codreman2-eng/Smart-Mangrove/reports/Estado de waypoints en el M600.md

# El puerto API podría delatar ya la misión

Sí existe una vía que podría funcionar sin romper la regla de solo recepción, pero nadie la ha demostrado todavía en un M600. El Open Protocol de DJI define en el mismo UART API que el ESP32 ya escucha dos mensajes no solicitados, además del broadcast 0x02/0x00. El primero es **0x02/0x03, el estado de la misión** (tipo de misión, waypoint objetivo, estado actual y error). El segundo es **0x02/0x04, los eventos de la misión** (subida terminada, misión terminada y waypoint alcanzado con su índice). DJI los describe como "broadcast data protocol" y no como llamadas de API. El único requisito documentado es marcar la casilla "Ground Station Status" en DJI Assistant ([Ground Station Protocol](https://developer.dji.com/onboard-sdk/documentation/protocol-doc/ground-station-protocol.html)). Quedan dos incógnitas sin respuesta pública. La primera es si el A3 emite esos mensajes cuando la misión la sube GS Pro y no el OSDK; DJI no lo ha probado y dijo oficialmente que OSDK-ROS no lo soporta. La segunda es si los emite hacia un dispositivo nunca activado. Ambas se resuelven con una sola sesión del simulador de DJI Assistant 2, usando el sniffer `tools/osdk_sniff.py` que el proyecto ya tiene. Si la prueba falla, la única señal explícita que queda es la acción de waypoint "PWM signal output to F-channel" del firmware A3 1.7.6.0, leída por GPIO 35. Esa opción tiene un coste: vuelve a meter en las guías el cableado del canal F que se acaba de quitar. Las demás vías tienen un veredicto firme. El sniffing de DUML o del CAN del A3 se descarta. La app MSDK solo sirve si sustituye a GS Pro como app de misión. Las posiciones de los waypoints no viajan por ningún canal pasivo, así que el ESP32 debe seguir cargándolas desde su propio `mission.json`.

## Dos mensajes de misión ya pasan por el cable que el ESP32 escucha

Esta es la vía con mejor relación entre coste y beneficio, porque no requiere hardware nuevo. El código fuente del OSDK 3.9 define `mission = {0x02, 0x03}` y `waypoint = {0x02, 0x04}` junto al broadcast `{0x02, 0x00}` ([dji_command.cpp](https://github.com/dji-sdk/Onboard-SDK/blob/3.9/osdk-core/api/src/dji_command.cpp)). Los structs están en `dji_ack.hpp`. `WayPointStatusPushData` lleva `mission_type`, `waypoint_index` y `current_status` (0 premisión, 1 en acción, 5 primer waypoint, 6 alcanzado). `WayPointReachedData` lleva `incident_type`, `waypoint_index` y `current_status` (4 pre-acción, 6 post-acción). El comentario del propio código dice que esos datos llegan "while ground-station is enabled on Assistant's SDK Page" ([dji_ack.hpp](https://github.com/dji-sdk/Onboard-SDK/blob/3.9/osdk-core/api/inc/dji_ack.hpp)). Con eso el ESP32 tendría justo lo que pide la pregunta: **el índice del waypoint objetivo, el evento de waypoint alcanzado (incluso separado en antes y después de las acciones) y el fin de misión**.

Hay un dato importante: **la librería anfitriona no exige activación ni autoridad de control para entregar esos mensajes**. En `dji_vehicle.cpp`, `PushDataHandler` despacha 0x02/0x03 y 0x02/0x04 a sus callbacks sin consultar `getActivationStatus()`. La autoridad solo hace falta para subir o arrancar una misión, no para recibirla ([dji_vehicle.cpp @3.9](https://raw.githubusercontent.com/dji-sdk/Onboard-SDK/3.9/osdk-core/api/src/dji_vehicle.cpp)). Por tanto, el único que puede bloquear al ESP32 es el propio firmware del A3. Esa es una prueba empírica, no una barrera de diseño. El broadcast ya demostró algo parecido: según `OsdkPositionSource.h`, el A3 lo emite sin que nadie lo pida, verificado en hardware real con el TX del adaptador desconectado.

Hay tres matices que impiden dar la vía por buena. **Primero, DJI respondió de forma negativa al caso M600 Pro.** En el issue #303 (M600 Pro, FW 1.0.1.67, OSDK 3.8.1), soporte de DJI dijo primero que "we have not tested" suscribirse a la información de una misión creada por una app de terceros. Después lo cerró con "OSDK-ROS does not support obtaining waypoint task information set by DJI APP/ third-party APP" ([Onboard-SDK-ROS #303](https://github.com/dji-sdk/Onboard-SDK-ROS/issues/303)). Esa respuesta habla de lo que la librería soporta, no de lo que el autopiloto emite. Aun así, es la única declaración oficial y no es favorable. A favor queda un argumento estructural: un colaborador recordó que "mission tasks are not exclusive to the Onboard SDK", porque el motor de misiones de la controladora es compartido ([Issue #416](https://github.com/dji-sdk/Onboard-SDK/issues/416)). **Segundo, la fiabilidad de los mensajes es imperfecta incluso con misiones del OSDK.** En modo `TRACE_COORDINATED` solo llegaban los eventos del primer y del último waypoint ([Issue #219](https://github.com/dji-sdk/Onboard-SDK/issues/219)). En un M210 el callback de eventos "is never called" ni en simulador ni en vuelo ([Onboard-SDK-ROS #244](https://github.com/dji-sdk/Onboard-SDK-ROS/issues/244)). **Tercero, la casilla "Ground Station Status" aparece en documentación de la era M100.** No se confirmó que exista en DJI Assistant 2 para A3/M600. Marcarla sería un cambio de configuración en tierra, no una transmisión del payload, así que no rompe la regla del proyecto.

El firmware actual descarta hoy esos mensajes. `OsdkPositionSource::_decode` sale con `if (p[0] != 0x02 || p[1] != 0x00) return false;`, de modo que cualquier 0x02/0x03 o 0x02/0x04 que ya llegue se tira sin registrar. En cambio, el sniffer de PC `tools/osdk_sniff.py` ya cuenta los pares cmd set/id (`self.cmds`, un `Counter`) y decodifica el campo `enc` de la cabecera. Es la herramienta exacta para la prueba.

Hay dos caminos oficiales del OSDK que conviene descartar del todo. **La activación queda descartada.** Es el comando 0x00/0x01: requiere TX, un `app_id` y una clave de desarrollador DJI, y una primera conexión con internet a través de DJI GO o Assistant 2. Además instala una clave de cifrado en el enlace ([OPEN Protocol](https://developer.dji.com/onboard-sdk/documentation/protocol-doc/open-protocol.html); [OSDK FAQ](https://developer.dji.com/onboard-sdk/documentation/appendix/FAQ.html)). Ningún documento dice que la activación desbloquee nada de misiones. **La suscripción (set 0x03) también queda descartada.** Funciona por petición y respuesta, así que necesita TX. Su lista de topics no incluye ninguno de misión ni de waypoint, y el ejemplo de la 3.9 la salta en el "legacy M600" ([dji_telemetry.hpp](https://raw.githubusercontent.com/dji-sdk/Onboard-SDK/3.9/osdk-core/api/inc/dji_telemetry.hpp); [mission_sample.cpp](https://raw.githubusercontent.com/dji-sdk/Onboard-SDK/3.9/sample/platform/linux/missions/mission_sample.cpp)). El techo de versiones también está claro: **OSDK 3.9, de septiembre de 2019, es la última que lista M600 (FW 1.0.1.67) y A3/A3 Pro (FW 1.7.7.0)**. La 4.x solo cubre M300 y M210 V2, y Waypoint V2 no existe para el M600 ([README @3.9](https://raw.githubusercontent.com/dji-sdk/Onboard-SDK/3.9/README.md); [README @master](https://raw.githubusercontent.com/dji-sdk/Onboard-SDK/master/README.md)).

Hay un premio menor dentro del broadcast. El enum `DisplayMode` nombra HOTPOINT (9) y NAVI_SDK_CTRL (17), pero no tiene valor de waypoint. Los valores 13-14, 16 y 18-32 están marcados como "reserved" ([dji_status.hpp](https://raw.githubusercontent.com/dji-sdk/Onboard-SDK/3.9/osdk-core/api/inc/dji_status.hpp)). El MSDK, por su parte, sí reporta `GPS_WAYPOINT` ("WP/F-WP") durante una misión ([FlightControllerState](https://developer.dji.com/api-reference/android-api/Components/FlightController/DJIFlightController_DJIFlightControllerCurrentState.html)). Por eso es plausible, aunque no está verificado, que el A3 ponga un valor reservado en el broadcast mientras GS Pro vuela. Ese valor daría un indicador barato de que hay una misión en ejecución, pero no el índice del waypoint. El campo STATUS (bit 11) todavía no se decodifica: según el propio código, primero hay que dimensionar GPS, RTK, MAG, RC y GIMBAL.

## Un pulso PWM en el canal F es la única señal deliberada

Si los mensajes de misión no aparecen, la única señal que GS Pro puede emitir a propósito en un waypoint concreto es eléctrica. Las notas de versión del A3 son explícitas. La **FW 1.7.6.0 (2018-08-02)**, con Assistant 2 for Autopilot v2.0.0, dice "Added a PWM signal output to F-channel in Waypoint Actions" y también corrige "the aircraft will sometimes not fly to the next waypoint". La **FW 1.7.7.0 (2019-01-09)** corrige que el canal F emitía un valor mínimo antes del preajustado tras reiniciar la controladora ([A3 Release Notes](https://dl.djicdn.com/downloads/a3/20190109/A3+release+notes+20190109.pdf)). El manual del A3 describe F1-F4 como salidas PWM multifunción y F5-F8 como E/S PWM ([A3 User Manual](https://dl.djicdn.com/downloads/a3/en/A3_and_A3_Pro_User_Manual_en_160520.pdf)). El ESP32 lee la señal sin transmitir nada, igual que ya lee el UART. La captura de RC-PWM en GPIO 35 ya está escrita (`RcPwmInput`, `RC_Input_Calibration_Tool.ino`).

**Veredicto: funciona con salvedades, y se presenta como opción, no como decisión.** El coste es concreto: reintroduce en las guías el cable del canal F que el proyecto acaba de retirar, con su pull-down externo de 10 k. Además, GPIO 35 no tolera 5 V y nadie ha medido el nivel lógico de los puertos F. Si resulta ser 5 V, hace falta el mismo divisor o la resistencia en serie que ya usa `RC_Pulse_Generator_Mega2560.ino`. Hay tres incógnitas más que ninguna fuente resuelve. La primera es en qué app y versión aparece la acción y con qué nombre; lo más probable es GS Pro, pero no se encontró manual ni changelog que lo confirme. La segunda es si el A3 integrado del M600 expone la acción igual que un A3 suelto. El M600 numera su firmware aparte (1.0.1.67), y no se verificó qué versión de controladora incluye. La tercera es si los puertos F son accesibles en el chasis del M600 sin el Channel Expansion Kit. Un usuario del foro de DJI afirma que los puertos F no dan V+, lo cual cuadra con un cable de señal y masa, pero esto no está verificado ([DJI forum 95197](https://forum.dji.com/thread-95197-1-1.html)). A cambio, esta vía da lo que ninguna otra pasiva ofrece: una marca que el planificador pone en el waypoint de lanzamiento, por ejemplo 1900 µs tras un hover y de vuelta a 1100 µs después. Con la puerta de posición ya existente, el lanzamiento queda atado a la intención de la misión y no solo a la geometría.

Las demás acciones de GS Pro, cada una con su veredicto, sirven como confirmación pero no como fuente de verdad. GS Pro admite **hasta 99 waypoints con hasta 15 acciones cada uno**: rotación de la aeronave, pitch de gimbal, inicio y parada de grabación, foto y hover ([Heliguy](https://www.heliguy.com/blogs/posts/heliguys-guide-to-the-dji-gs-pro-app)). Cada hover dura como máximo 32 767 ms ([MSDK DJIWaypointActionType](https://developer.dji.com/iframe/mobile-sdk-doc/ios/Enums/DJIWaypointActionType.html)). **El hover con la puerta de posición y velocidad funciona** y no exige cambios. Conviene endurecer la puerta a ≤0,5-1,0 m/s sostenidos durante ≥2 s, en lugar de ≤2,0 m/s instantáneos. Aun así, sigue detectando "parado cerca de la coordenada", no "la misión llegó". **La rotación a un rumbo firma funciona con salvedades** como segundo factor, porque el ESP32 ya recibe el cuaternión. Por ejemplo: hover, girar a un rumbo alejado al menos 30-45° de los tramos de vuelo, mantener ±5-10° y lanzar. **La foto mapeada a un puerto F configurado como "Shutter" es dudosa.** El firmware 1.6.0.10 añadió el mapeo del obturador, pero UgCS informa de que no puede disparar cámaras propias en F1-F8 ([A3 Release Notes](https://dl.djicdn.com/downloads/a3/20190109/A3+release+notes+20190109.pdf); [DIYDrones](https://diydrones.com/group/ugcs/forum/dji-n3-remote-shutter-ugcs)). **El pitch de gimbal no funciona** sin un gimbal DJI reconocido. El M600 con A3 solo controla en ángulo Ronin-MX, X5, X3 y XT ([OSDK Gimbal](https://developer.dji.com/onboard-api-reference/classDJI_1_1OSDK_1_1Gimbal.html)), y añadir uno solo para transportar una señal pesa y cuesta más que un cable.

## DUML y CAN tienen nombres de comandos pero ningún bus accesible

Los comandos de misión existen en el protocolo interno, pero nada de lo publicado permite leerlos en un M600. El disector `dji-dumlv1-flyc.lua` de o-gs nombra un bloque completo de misión en el set 0x03. Dos de esos comandos son mensajes no solicitados: **0x88 "Push Navigation Status Info"** (Target Way Point, Way Point Running Status) y **0x89 "Push Navigation Event Info"** (Reach Incident Way Point Index). Su estructura coincide casi campo por campo con 0x02/0x03 y 0x02/0x04, lo que sugiere un mismo registro interno exportado por dos caminos. Pero la sección de waypoint lleva el comentario `-- Way Point mission (unverified)`. Las subidas 0x82/0x84, que llevarían las posiciones, tienen nombre y ningún layout ([dji-dumlv1-flyc.lua](https://github.com/o-gs/dji-firmware-tools/blob/master/comm_dissector/wireshark/dji-dumlv1-flyc.lua)). Todas las capturas proceden de drones de consumo (Phantom, Mavic, Spark) por UART, USB o Wi-Fi. El repositorio no tiene herramienta de captura CAN ni ninguna captura de A3, M600 o LB2 ([README del disector](https://github.com/o-gs/dji-firmware-tools/blob/master/comm_dissector/README.md)).

La topología física termina de cerrar esta vía. Según el manual, el Lightbridge 2 se conecta al A3 por el **"RF Port" con un "DBUS Cable II"**, no por CAN1. CAN1 queda reservado a GPS-Compass Pro, RTK y gimbal, y CAN2 y el puerto API a dispositivos SDK ([A3 User Manual](https://dl.djicdn.com/downloads/a3/en/A3_and_A3_Pro_User_Manual_en_160520.pdf)). La misión que sube GS Pro probablemente viaja por un enlace propietario sin documentar, el mismo cable que lleva el mando de RC a la controladora, y no conviene intervenir en él. El único precedente público de decodificación CAN de DJI es el Naza-M V2. Allí el oyente tenía que **transmitir un heartbeat (0x108-1007) a 1 Hz** para que la controladora emitiera los datos OSD ([STorM32 wiki](https://www.olliw.eu/storm32bgc-v2-wiki/CAN_Bus_Communication)), algo que el proyecto prohíbe. La tasa de bits del A3, los IDs, el conector y el pinout no son públicos. Además, la EULA de DJI prohíbe la ingeniería inversa sin consentimiento escrito ([DJI Developer EULA](https://developer.dji.com/policies/eula)). **Veredicto: no funciona y se descarta.** Un nodo TWAI en modo listen-only sería eléctricamente seguro, pero no tendría nada que decodificar.

## La app MSDK solo ve la misión si sustituye a GS Pro

El MSDK 4.x expone exactamente los campos que se buscan, pero hay un problema de arquitectura. `WaypointExecutionProgress` da `targetWaypointIndex`, `isWaypointReached` y `executeState` ([DJIWaypointExecutionProgress](https://developer.dji.com/api-reference/android-api/Components/Missions/DJIWaypointMission_DJIWaypointExecutionProgress.html)). El M600 y el M600 Pro figuran con misiones Waypoint en el MSDK 4, y no aparecen en el v5 ([MSDK Product Introduction](https://developer.dji.com/mobile-sdk/documentation/introduction/product_introduction.html)). El problema es que **solo una app habla con la aeronave a la vez**. DJI lo declara para las plataformas actuales ("only one app can access the drone data"), y en el M600 el móvil va por USB al mando ([DJI SDK forum](https://sdk-forum.dji.net/hc/en-us/articles/6029213604249-Can-you-run-official-app-and-MSDK-app-simultaneously-on-RC-Pro-or-RC-Plus)). Para una misión ajena, la única ruta documentada es la de reconexión. Si al conectar el SDK ya hay una misión en ejecución, el operador descarga un resumen "but information for each waypoint is absent", y `downloadMission` puede pedir los waypoints mientras dure el estado EXECUTING ([WaypointMissionOperator](https://developer.dji.com/api-reference/android-api/Components/Missions/DJIWaypointMissionOperator.html)). Para usar esa ruta, GS Pro tendría que soltar el enlace en pleno vuelo, y nadie lo ha probado en un M600.

El relé hasta el ESP32 añade dos problemas más. Por Wi-Fi, el móvil se uniría al AP "SmartLauncher", pero el alcance desde el suelo es de cientos de metros como mucho, frente a los kilómetros del Lightbridge; esto es una estimación sin fuente. Por `sendDataToOnboardSDKDevice`, el MSDK lo lista para el M600/A3 con un máximo de 100 bytes por llamada ([DJIOnboardSDKDevice](https://developer.dji.com/api-reference/ios-api/Components/OnboardSDKDevice/DJIOnboardSDKDevice.html)), y los datos llegan al puerto API como 0x02/0x02 a unos 1 KB/s ([Data Transparent Transmission](https://developer.dji.com/onboard-sdk/documentation/M100-Docs/application-development-guides/data-transparent-transmission.html)). No se sabe si llegan a un dispositivo no activado, y un hilo del foro de DJI afirma que no está disponible en el M600 ([DJI SDK forum 360038614413](https://sdk-forum.dji.net/hc/en-us/community/posts/360038614413-Open-Protocol-and-Data-Transparant-Transmission-on-M210-and-M600)). **Veredicto: funciona con salvedades fuertes, y se descarta como relé de GS Pro.** Solo vale la pena si el proyecto decide cambiar de herramienta y que una app MSDK propia planifique, suba y vuele la misión. En ese caso los eventos están garantizados. GS Pro, además, está en fase de mantenimiento desde la 2.0.17 y no recibirá más soporte de dispositivos ([App Store](https://apps.apple.com/us/app/dji-gs-pro/id1183717144)).

## Las posiciones de los waypoints no salen por ningún canal pasivo

Para la segunda mitad de la pregunta la respuesta es firme. **Ningún mensaje pasivo documentado contiene las coordenadas de los waypoints.** 0x02/0x03 y 0x02/0x04 solo llevan índices y estados. Los comandos DUML de subida no tienen layout público. El MSDK solo las entrega a la app que tiene el enlace, mediante `downloadMission`. En el OSDK, descargar la misión requiere enviar comandos, y aun así solo funciona si el propio OSDK subió algo antes; el autor del issue #303 lo comprobó en un M600 Pro ([Onboard-SDK-ROS #303](https://github.com/dji-sdk/Onboard-SDK-ROS/issues/303)). Por eso el diseño actual es el correcto: el operador carga las coordenadas de lanzamiento en el `mission.json` del ESP32 (`MissionDefault.h` ya trae `lat_deg`, `lon_deg`, `alt_m` y `radius_m` por punto). Si 0x02/0x04 resulta funcionar, el índice que reporte se cruzaría con esa lista. Hay que tener en cuenta que GS Pro trocea las misiones de más de 99 waypoints ([GS Pro FAQ](https://www.dji.com/ground-station-pro/faq)), así que el índice es relativo a cada tramo subido y no a la misión completa.

| Vía | Veredicto | Qué aporta |
|---|---|---|
| OSDK 0x02/0x03 y 0x02/0x04 en el UART actual | Funciona con salvedades, pendiente de banco | Índice objetivo, waypoint alcanzado, fin de misión |
| DisplayMode reservado en el broadcast | Pendiente de banco | Solo "misión activa" |
| Activación o suscripción del OSDK | No, se descarta (exige TX y app key) | Nada de misión |
| PWM de canal F (FW ≥1.7.6.0) en GPIO 35 | Funciona con salvedades, opción con coste de cableado | Marca deliberada en el waypoint de lanzamiento |
| Hover + puerta de posición y velocidad | Funciona (ya implementado) | "Parado en la coordenada" |
| Rumbo firma (cuaternión) | Funciona con salvedades | Segundo factor |
| Foto / Shutter en puerto F | Dudosa, informes contradictorios | Marca, si dispara sin cámara DJI |
| Pitch de gimbal | No, sin gimbal DJI | — |
| DUML / CAN del A3 | No, se descarta | — |
| App MSDK como relé de GS Pro | No en la práctica; sí si sustituye a GS Pro | Índice y estado completos |
| Posiciones de waypoints por vía pasiva | No | Precargar en `mission.json` |

## Una sesión de simulador resuelve las incógnitas

La prueba se hace en banco, con hélices desmontadas, y el ESP32 sigue sin transmitir nada en todo momento. Pasos:

1. Actualizar y anotar el firmware de la controladora. Hace falta conocer la versión del A3 integrado; el objetivo es 1.7.7.0 o la equivalente del paquete M600.
2. En DJI Assistant 2, en la página SDK, buscar y marcar "Ground Station Status". Si la casilla no existe, anotarlo, porque eso también es un resultado. Asignar además un puerto F a la salida PWM de waypoint.
3. Arrancar el simulador de Assistant 2 y conectar el adaptador USB-TTL de 3,3 V solo al TX del puerto API.
4. En GS Pro, en el iPad, volar una misión de 3 waypoints. En el waypoint 2 programar: Hover 3 s, Rotate a un rumbo firma, la acción PWM del canal F a valor alto (si GS Pro la ofrece), Hover 10 s, PWM de vuelta a valor bajo.
5. Grabar la sesión con `python tools/osdk_sniff.py --port COMx --seconds 600`, anotando la hora de cada transición.

Que GS Pro vuele misiones contra el simulador de Assistant 2 es una suposición que hay que confirmar en el primer minuto.

Los criterios de decisión son binarios:

- Si el histograma `cmd set/id` muestra 0x02/0x03 o 0x02/0x04 con `enc=0`, y el `waypoint_index` cambia 0, 1, 2 al ritmo del vuelo, la vía principal queda confirmada. El siguiente paso es ampliar `_decode` para que deje de descartar esos IDs y registrarlos en el logger antes de usarlos en la lógica de lanzamiento.
- Si aparecen con `enc≠0`, están cifrados y se descartan.
- Si no aparece ninguno de los dos, los mensajes están restringidos a misiones del OSDK o a la activación, y la vía se cierra para siempre.

En la misma captura hay que mirar cuatro cosas más. La primera es el byte de modo de vuelo dentro de STATUS, que hay que decodificar o comparar en crudo contra un tramo en P-GPS. La segunda es si el campo gimbal se mantiene estático. La tercera es si el puerto F genera pulsos en un osciloscopio; antes de acercarlo a GPIO 35 hay que medir con un multímetro si la amplitud es de 3,3 V o 5 V. La cuarta es que `RcPwmInput` vea el escalón a 1900 µs justo en el waypoint 2. Solo si falla la primera vía y funciona la tercera tiene sentido decidir si se vuelve a cablear el canal F en las guías.

## Conclusión

El hallazgo que cambia el planteamiento es que la pieza que falta probablemente ya pasa por el cable que el proyecto escucha, y el firmware la tira por un filtro de dos bytes. Eso invierte el orden natural de trabajo. Antes de pensar en hardware nuevo, ingeniería inversa o apps de terceros, conviene dedicar una tarde al simulador con una herramienta que ya existe. La respuesta de DJI en el issue #303 obliga a ser prudentes: el resultado más probable es incierto, no positivo. Pero el coste de averiguarlo es casi nulo, y el posible beneficio (índice y evento de llegada con autoridad del autopiloto, sin un solo cable más) es mayor que el de cualquier otra opción.

La segunda consecuencia es de diseño. Aunque la prueba salga bien, ninguna vía pasiva entrega coordenadas, y los mensajes de misión tienen un historial de pérdidas en ciertos modos de trayectoria. El evento de misión debe entrar como una condición más de la puerta de lanzamiento, junto con posición, velocidad sostenida y quizás rumbo firma, y nunca sustituirla. El canal F queda como plan B con un coste conocido. El MSDK solo vuelve a ser relevante si el proyecto decide dejar GS Pro, que ya está congelado por DJI.
