codreman2-eng/Smart-Mangrove/SMART_LAUNCHER_COMPLETE_GUIDE.md

# Smart Launcher — Complete Implementation & Wiring Guide

**Project:** Autonomous drone seed release system for mangrove reforestation  
**Hardware:** Freenove ESP32-WROVER-E + DJI M600 / A3 Pro (Cube Orange+ = Phase 4)  
**Version:** Phase 4c — configurable release gate (dwell, speed, radius)  
**Last updated:** 2026-10-15 (wiring §4.1/4.5/4.7, §8.2, §10.2, §15). Sections 11, 12
and 16 still describe the Cube Orange / ArduPilot path and are not current for the DJI approach.

---

## Table of Contents

1. [Project Overview](#1-project-overview)
2. [System Architecture](#2-system-architecture)
3. [Hardware Bill of Materials](#3-hardware-bill-of-materials)
4. [Wiring Guide](#4-wiring-guide)
5. [Power System](#5-power-system)
6. [Mechanical Integration](#6-mechanical-integration)
7. [Software Environment Setup](#7-software-environment-setup)
8. [Firmware — Phase 2 Skeleton](#8-firmware--phase-2-skeleton)
9. [Servo Tester Tool](#9-servo-tester-tool)
10. [Mission Configuration](#10-mission-configuration)
11. [Cube Orange Setup](#11-cube-orange-setup)
12. [Bench Testing Protocol](#12-bench-testing-protocol)
13. [Calibration Guide](#13-calibration-guide)
14. [State Machine & LED Reference](#14-state-machine--led-reference)
15. [Serial Command Reference](#15-serial-command-reference)
16. [Flight Checklist](#16-flight-checklist)
17. [Troubleshooting](#17-troubleshooting)
18. [Development Roadmap](#18-development-roadmap)

---

## 1. Project Overview

The Smart Launcher is a **self-contained, platform-agnostic payload module** that autonomously releases mangrove propagules (seeds) from a drone at predefined GPS coordinates.

### Key design principles

- **Zero *control* coupling to the flight controller.** The launcher reads position — from its own GNSS, or from the DJI A3's unprompted OSDK broadcast (Phase 3d) — and **never transmits** to the aircraft. No PSDK or Channel Expansion Kit, and no commanded flight. The original "no OSDK at all" rule was narrowed to receive-only, not dropped.
- **Power only from the drone.** The drone provides 2S–6S power. All drop logic runs on the ESP32 onboard.
- **Two independent modules, synchronized.** Each module holds 5 seeds. Module A fires first; Module B fires immediately after A's limit switch confirms completion. This preserves balance.
- **Configurable without reflashing.** All mission parameters (waypoints, timing, PWM values) live in `mission.json` on the ESP32 filesystem. Change the file, re-upload the filesystem, fly.
- **Safe.** A hardware fault in the launcher cannot affect the flight controller. Power is the only shared resource.

### Physical mechanism

Each launcher module contains a **sliding cover** over 5 seed compartments (35 mm wide each). A continuous rotation servo drives a rack-and-pinion that retracts the cover progressively:

```
Start: [COVER████████████████████] all 5 closed
WP 1:  [        ████████████████] door 1 open → seed drops
WP 2:  [                ████████] door 2 open → seed drops
WP 3:  [                    ████] door 3 open → seed drops
...
WP 5:  [                        ] all open → limit switch hits → mission done
```

The cover only moves in **one direction** (retract). Seeds fall by gravity. The limit switch at the fully-retracted end signals that all seeds have been dropped from that module.

---

## 2. System Architecture

```
┌─────────────────────────────────────────────────────────────────┐
│                         DRONE (host)                            │
│  ┌──────────────────┐          ┌──────────────────────────────┐ │
│  │  Cube Orange     │          │   Smart Launcher             │ │
│  │  ArduCopter 4.6  │ TELEM2   │   Freenove ESP32-WROVER-E   │ │
│  │  (flight ctrl)   │──UART───▶│                              │ │
│  │                  │          │  ┌─────────────────────────┐ │ │
│  │  GPS/IMU/EKF     │          │  │ Drop Logic Engine        │ │ │
│  │  Flies waypoints │          │  │ Config Manager           │ │ │
│  │  via QGC/UgCS    │          │  │ State Machine            │ │ │
│  └──────────────────┘          │  │ Logger                   │ │ │
│                                │  └──────────┬──────────────┘ │ │
│  ┌──────────────────┐          │             │                 │ │
│  │  UBEC 5V/5A      │          │  ┌──────────▼──────────────┐ │ │
│  │  (power only)    │──5V─────▶│  │ Actuator Module A & B   │ │ │
│  └──────────────────┘          │  │ Servo PWM (LEDC)        │ │ │
│                                │  │ Limit switch read        │ │ │
│  ┌──────────────────┐          │  └──────────┬──────────────┘ │ │
│  │  u-blox M8N GNSS │──UART───▶│             │                 │ │
│  │  (onboard)       │          └─────────────│─────────────────┘ │
│  └──────────────────┘                        │                   │
└─────────────────────────────────────────────│───────────────────┘
                               ┌──────────────▼──────────────────┐
                               │  Module A          Module B      │
                               │  Servo + rack      Servo + rack  │
                               │  5 doors           5 doors       │
                               │  Limit SW A        Limit SW B    │
                               └─────────────────────────────────┘
```

### Position source selection

> The diagram above is the original ArduPilot plan. **The path flown today is
> the DJI M600:** the A3's API port broadcasts position and velocity to the
> launcher over one receive-only wire (section 4.5).

The firmware picks the source itself — there is nothing to set:

| Priority | Source | Notes |
|---|---|---|
| 1 | DJI A3 OSDK broadcast, UART2 (GPIO 25) | ~47 Hz, position + velocity + height. Enables the impact predictor and the speed gate |
| 2 | Onboard u-blox M8N, UART1 (GPIO 4/5) | Automatic fallback when OSDK goes stale (>500 ms). 1 Hz, no velocity |
| — | Cube Orange TELEM2 (MAVLink) | **Not implemented** — Phase 4 plan only |

`position_source` in `mission.json` is parsed but **not used**; the OSDK →
GNSS fallback order above is fixed in firmware.

---

## 3. Hardware Bill of Materials

### Core electronics

| Component | Part | Qty | Notes |
|---|---|---|---|
| MCU | Freenove ESP32-WROVER-E | 1 | PSRAM, built-in Wi-Fi. Arduino IDE board: **ESP32 Wrover Module** |
| GNSS | u-blox M8N (BN-880 or similar) | 1 | UART, 3.3V, patch antenna included |
| Servo | FS5106R continuous rotation | 2 | One per module. 4.8–6V |
| Limit switch | Micro snap-action switch (SPDT) | 2 | One per module, at fully-retracted end |
| UBEC | 5V / 5A step-down BEC | 1 | Powers servos + ESP32 |
| Capacitor | 100µF 10V electrolytic | 2 | One across each servo power rail |
| Connector | XT30 or JST-PH | 1 set | Drone power input |
| Wire | 22 AWG silicone | — | Signal lines |
| Wire | 18 AWG silicone | — | Power lines (servo) |

### Optional / Phase 4

| Component | Part | Notes |
|---|---|---|
| JST-GH 6-pin cable | Cube Orange+ TELEM2 cable | Phase 4 MAVLink feed — pins unassigned, see 4.6 |
| USB-C cable | Data-capable (not charge-only) | Firmware upload |

### For bench testing only

| Item | Purpose |
|---|---|
| Desktop 5V / 3A power supply | Power servos without drone battery |
| Bench alligator clips | Temporary connections |
| Multimeter | Verify voltages before first power-on |

---

## 4. Wiring Guide

### 4.1 Complete pin mapping — ESP32-WROVER-E

> **`Servo_Web_Calibrator_WROVER/Pins.h` is the authority.** These values were
> validated on real hardware by serial-checkpoint bisection. If this table and
> `Pins.h` ever disagree, `Pins.h` is right and this table is stale.

| Signal | GPIO | Direction | Voltage | Notes |
|---|---|---|---|---|
| Servo A PWM | GPIO 12 | OUT | 3.3V | `ledcAttach`, 50 Hz, 16-bit |
| Servo B PWM | GPIO 13 | OUT | 3.3V | `ledcAttach`, 50 Hz, 16-bit |
| Limit Switch A | GPIO 32 | IN | 3.3V | INPUT_PULLUP, active LOW |
| Limit Switch B | GPIO 33 | IN | 3.3V | INPUT_PULLUP, active LOW |
| Status LED | GPIO 22 | OUT | 3.3V | Plain 2-pin LED + 330R. **Not** the board's built-in |
| Wait LED (yellow) | GPIO 27 | OUT | 3.3V | 330R to GND. Steady ON = ARMED |
| Drop announce LED | GPIO 14 | OUT | 3.3V | 330R to GND. Lit for the servo drive window |
| RC pilot trigger | GPIO 35 | IN | — | **Not wired** (F-channel wire removed 2026-10-14). Reserved; trigger ships disabled. See 4.5 |
| OSDK RX | GPIO 25 | IN | 3.3V | ← DJI A3 Pro API port TX, 921600 baud (UART2) |
| OSDK TX | GPIO 26 | — | — | **Not connected.** Reserved for UART2 TX; never driven — the link is receive-only |
| GNSS UART RX | GPIO 4 | IN | 3.3V | ← GNSS module TX (UART1) |
| GNSS UART TX | GPIO 5 | OUT | 3.3V | → GNSS module RX (UART1) |
| ARM button | GPIO 0 | IN | 3.3V | Onboard BOOT button, hold 2s **after** boot. Secondary path — the dashboard ARM button is primary |
| GND | GND | — | 0V | Common ground — CRITICAL |
| 5V in | 5V pin | PWR IN | 5V | From UBEC output |

#### ⛔ Pins that must never be used on this board

| Pin | Why | How it was found |
|---|---|---|
| GPIO 2 | Strapping pin. Driven as OUTPUT during/around boot it boot-loops (`rst:0x8 TG1WDT_SYS_RESET`) | Cost a debugging session |
| GPIO 9, 10 | Permanently wired to the shared flash+PSRAM SPI bus on WROVER modules, regardless of flash mode. `pinMode(9, INPUT_PULLUP)` crashes the board instantly | Live serial bisection |
| GPIO 16, 17 | Same PSRAM bus. These are `Serial2`'s **default** pins, so UART2 pins must always be passed explicitly to `Serial2.begin()` | Caught before it cost anything |

Free and safe if you need a spare: **18, 19, 21, 23**.

> **A 3.3V GPIO signal is safe for servo signal wires.** Most servos accept 3.3V logic on the signal pin even when powered at 5V. Tested with FS5106R.

> **Note on GPIO 14:** the boot ROM emits a brief PWM burst on this pin, so a
> flicker of the drop announce LED at power-on — before checkpoint `[1]` prints —
> is expected, not a fault.

---

### 4.2 Servo wiring

Each servo has 3 wires. Standard colour coding:

```
Servo wire colour → Connect to
─────────────────────────────────────────────────────
Brown / Black     → UBEC GND  AND  ESP32 GND (common)
Red               → UBEC 5V output
Orange / Yellow   → ESP32 GPIO (12 for A, 13 for B)
```

> **Never power servos from the ESP32 5V or 3.3V pins.** Always use the UBEC. Servo stall current (up to 1.5A each) will reset or damage the ESP32 regulator.

**Add a 100µF electrolytic capacitor** across the servo power rail (+ to 5V, – to GND) near each servo connector. This absorbs voltage spikes when the servo starts or stalls.

> **`SIM_MODE` in `Pins.h` decides whether these pins are driven at all.** With
> `SIM_MODE 1`, `ledcAttach()` is never called on GPIO 12/13 — the signal lines
> stay high-impedance and no PWM is generated. **Also unplug the servo UBEC for
> sim runs.** Set it to `0` only for a flight build.

---

### 4.3 Limit switch wiring

Each micro switch has 3 terminals: COM, NO (Normally Open), NC (Normally Closed).  
**Use COM and NO.**

```
Limit switch terminal → Connect to
──────────────────────────────────
COM                   → GND
NO                    → GPIO 32 (Module A) or GPIO 33 (Module B)
NC                    → not connected
```

The firmware configures these pins as `INPUT_PULLUP`. When the cover reaches the end of the rail and presses the switch, the GPIO reads LOW → servo auto-stops.

> ⚠️ **Wire these before `SIM_MODE` goes to 0.** With the switches unwired the pin
> floats high and the last door of each module runs to its timeout instead of
> stopping: module A drove **1740 ms against a 580 ms target** — a 3x overdrive.
> Harmless in SIM, mechanically dangerous with real servos.
>
> Only the **last** door of a module reads the switch (`_is_last_door`); doors 1–4
> use `travel_ms` and never read the pin, so they are safe to fire un-switched.

---

### 4.4 GNSS module wiring (u-blox M8N / BN-880)

```
GNSS module pin → ESP32 GPIO
────────────────────────────────
VCC (3.3V)      → 3V3 pin on ESP32 board
GND             → GND
TX              → GPIO 4 (ESP32 UART1 RX)
RX              → GPIO 5 (ESP32 UART1 TX)
```

> The BN-880 runs at 3.3V. Do **not** connect VCC to the 5V rail.

---

### 4.5 DJI M600 / A3 Pro wiring (primary position — the only aircraft wire)

This is the link that is actually flown today; the M8N above is the fallback.
**It is the only connection between the launcher and the aircraft's
electronics** (besides power).

**API port → OSDK position (receive-only):**

```
A3 "API" port pin → ESP32
──────────────────────────────────────────────────
TX                → GPIO 25   (330R series optional)
GND               → GND       ← MANDATORY
RX                → NOT CONNECTED   (GPIO 26 stays unconnected)
VCC               → NOT CONNECTED
```

Both sides are 3.3V — no level shifter. 921600 baud, as set in DJI Assistant 2.
**The launcher never transmits on this link** — that is a design rule, not a
limitation.

**DJI Assistant 2 broadcast settings — keep VELOCITY on.** The broadcast must
include **POSITION (bit 5)** and **VELOCITY (bit 3)**. Everything the release
gate uses arrives on this one wire: position, height above takeoff, and the
velocity vector the impact predictor and the speed limit read. Without
VELOCITY both switch off silently — the speed gate fails **open** and the
dashboard's APPROACH card shows "no velocity - gate off". TIME, QUATERNION,
ACCEL and ANG_RATE can be trimmed to shorten the frame; the decoder computes
field offsets from the `passFlag`. (Earlier versions of this guide said to trim
to POSITION+GPS+RC+STATUS — that predates the predictor and would disable it.)

**Mission pushes over the same wire (unverified).** The A3 may also send
`0x02/0x03` (mission state) and `0x02/0x04` (waypoint event) on this TX line
when "Ground Station Status" is ticked in Assistant 2's SDK page. The firmware
logs them and the dashboard's DJI MISSION card counts them; nothing fires on
them. Whether the A3 sends them for a GS Pro mission is the open question in
`reports/Estado de waypoints en el M600.md`. No extra wiring either way.

**F-channel → GPIO 35 pilot trigger: NOT WIRED.** Removed from this guide on
2026-10-14. The firmware input still exists and the dashboard still shows the
card, but the trigger ships **disabled** (`rc_trigger.enabled = false`) because
an unwired input-only pin has no pull resistor and floats. If the GS Pro
"PWM signal output to F-channel" waypoint action is adopted later, the wire
comes back with: the F-channel voltage **measured first** (GPIO 35 is not 5V
tolerant — 10k/20k divider if it reads 5V), an external **10k pull-down** from
GPIO 35 to GND, common ground, then `RC_Input_Calibration_Tool.ino` before the
dashboard trigger is enabled.

### 4.5a What the release settings need from the wiring

Nothing new. The dashboard's RELEASE SETTINGS (max speed, dwell, default
radius — section 10.2) are pure software acting on data from the A3 API wire
above:

| Setting | Data it needs | Comes from |
|---|---|---|
| Radius (per waypoint) | Position (+ predicted impact) | API TX → GPIO 25, POSITION field |
| Max release speed | Horizontal velocity | API TX → GPIO 25, VELOCITY field |
| Impact prediction | Velocity + height above takeoff | API TX → GPIO 25, VELOCITY + POSITION |
| Dwell | Time + the two above | ESP32 clock |

On the GNSS fallback (M8N on GPIO 4/5) there is no velocity: radius and dwell
still apply, the speed gate and prediction do not.

---

### 4.6 Cube Orange+ TELEM2 wiring (Phase 4 — MAVLink, NOT YET WIRED)

Phase 4 would take position from the Cube Orange+ over MAVLink as a cross-check
and mode/abort detector. **No pins are assigned for this yet**, and the obvious
choice is a trap:

- **Not GPIO 16/17.** Those are `Serial2`'s defaults *and* the WROVER PSRAM bus.
- UART0 is the console, UART1 is the GNSS (GPIO 4/5), and **UART2 is already
  taken by the DJI OSDK link** (GPIO 25/26). A third UART has to be resolved
  before this is wired — pick free pins (18/19/21/23) and pass them explicitly
  to `begin()`.

For reference, the Cube Orange carrier's TELEM2 port is a **JST-GH 6-pin**:

```
TELEM2 pin (JST-GH) → Signal    → ESP32
─────────────────────────────────────────────────
Pin 1               → +5V       → NOT connected (ESP32 already powered)
Pin 2               → TX (out)  → ESP32 UART RX   (pin TBD — NOT 16)
Pin 3               → RX (in)   → ESP32 UART TX   (pin TBD — NOT 17)
Pin 4               → CTS       → NOT connected
Pin 5               → RTS       → NOT connected
Pin 6               → GND       → GND (common ground)
```

> Both TX/RX are 3.3V TTL — directly compatible with ESP32. No level shifter needed.

---

### 4.7 Complete wiring diagram (text schematic)

```
                    ┌─────────────────────────────┐
  DRONE BATTERY     │    UBEC  5V / 5A            │
  2S–6S ──────────▶ │  IN: 7.4–25.2V              │──── 5V out ──┬── Servo A red
                    │  OUT: 5V regulated          │              ├── Servo B red
                    └─────────────────────────────┘              └── ESP32 5V pin

  GND bus ──────────────────────────────────────────────────────────────────────
           │         │          │          │          │          │        │
         UBEC GND  Servo A    Servo B   Limit SW A  Limit SW B  GNSS GND  A3 GND
                   brown/blk  brown/blk  COM         COM

  ┌──────────────────────────────────────────────────────────────────────┐
  │                   Freenove ESP32-WROVER-E                            │
  │                                                                      │
  │  GPIO 4  ◀──────────────────────────────────── GNSS TX              │
  │  GPIO 5  ──────────────────────────────────▶   GNSS RX              │
  │  GPIO 25 ◀──────────────────────────────────── A3 API TX (OSDK)     │
  │  GPIO 26     (not connected — A3 API RX stays open)                 │
  │  GPIO 35     (not connected — RC trigger reserved, disabled)        │
  │  GPIO 12 ──────────────────────────────────▶   Servo A signal (org) │
  │  GPIO 13 ──────────────────────────────────▶   Servo B signal (org) │
  │  GPIO 32 ◀──── internal pullup ──── Limit SW A NO ──── GND          │
  │  GPIO 33 ◀──── internal pullup ──── Limit SW B NO ──── GND          │
  │  GPIO 0  ◀──── onboard BOOT button                                  │
  │  GPIO 22 ──── [330R] ──── Status LED ──── GND                       │
  │  GPIO 27 ──── [330R] ──── Wait LED (yellow) ──── GND                │
  │  GPIO 14 ──── [330R] ──── Drop announce LED ──── GND                │
  │  GND     ──────────────────────────────── Common GND bus            │
  │  5V      ◀──────────────────────────────── UBEC 5V out              │
  └──────────────────────────────────────────────────────────────────────┘

  Note: the limit-switch 10kΩ pullups are INTERNAL (INPUT_PULLUP) — no external
  resistors needed. GPIO 35 needs an EXTERNAL 10kΩ pull-down only if the
  F-channel is ever wired (4.5). The A3 → ESP32 link is ONE signal wire
  (API TX → GPIO 25) plus ground.
  Never use GPIO 2, 9, 10, 16 or 17 on this board — see 4.1.
```

---

## 5. Power System

### 5.1 Power budget

| Component | Voltage | Typical current | Peak (stall) |
|---|---|---|---|
| ESP32-WROVER-E | 5V → 3.3V internal | 80 mA | 250 mA (Wi-Fi TX) |
| GNSS M8N | 3.3V | 25 mA | 35 mA |
| Servo A (FS5106R) | 5V | 150 mA running | 1500 mA stall |
| Servo B (FS5106R) | 5V | 150 mA running | 1500 mA stall |
| **Total (running)** | **5V** | **~400 mA** | **~3300 mA** |

**Required UBEC: 5V / 5A minimum.** Recommended: 5V / 5A with short-circuit protection.

### 5.2 Recommended UBEC options

| Product | Rating | Notes |
|---|---|---|
| Matek FCHUB-6S | 5V / 3A + 9V / 3A | Good for light servos |
| HobbyWing 5A BEC | 5V / 5A | Best option for FS5106R |
| Pololu D36V28F5 | 5V / 3.8A | Compact, high efficiency |

### 5.3 Power sequencing

Power-on order does not matter — the ESP32 boots from 3.3V (internal LDO from 5V input). Servos are always held at 1500 µs (stop) until the ARM command is received.

---

## 6. Mechanical Integration

### 6.1 Rack and pinion specs

| Parameter | Value | Derivation |
|---|---|---|
| Gear diameter | 38 mm | Measured |
| Teeth count | 24 | Measured |
| Circumference | π × 38 = 119.4 mm | — |
| Travel per tooth | 119.4 ÷ 24 = **4.97 mm** | — |
| Teeth for 35 mm | 35 ÷ 4.97 = **7.04 teeth** | — |
| Revolutions for 35 mm | 7.04 ÷ 24 = **0.293 rev** | — |
| FS5106R speed at 5V | ~60 RPM = 1 rev/sec | Datasheet |
| **Theoretical travel time** | 0.293 sec = **~300 ms** | — |
| **Starting firmware value** | **350 ms** | +20% margin |

> **Calibrate this value on the bench before flying.** See Section 13.

### 6.2 Limit switch placement

The limit switch must be positioned so the switch actuator is **fully depressed** when the sliding cover reaches the end of its retraction travel (all 5 doors open). Mount it at the retracted end of the rail with the switch body fixed to the frame and the actuator contacting a tab on the sliding cover.

### 6.3 Module mounting on drone

- Mount both modules **symmetrically** on the drone frame, equidistant from the centre of gravity.
- Use vibration-dampening foam or rubber grommets between the launcher frame and drone frame.
- Run all wiring through cable sleeves and secure with zip ties — no loose wires near propellers.
- The entire launcher assembly should be detachable via a single multi-pin connector for easy module swap between missions.

---

## 7. Software Environment Setup

> **The firmware is built with the Arduino IDE, not PlatformIO.** The live
> sketch is `Servo_Web_Calibrator_WROVER/Servo_Web_Calibrator_WROVER.ino`.
> The PlatformIO project under `smart_launcher_phase2/` is the abandoned Phase 2
> skeleton — see 7.6 before touching it.

### 7.1 Arduino IDE — board and core

1. Download Arduino IDE 2.x from [arduino.cc](https://www.arduino.cc/en/software)
2. `File → Preferences` → paste into "Additional boards manager URLs":
   ```
   https://raw.githubusercontent.com/espressif/arduino-esp32/gh-pages/package_esp32_index.json
   ```
3. `Tools → Board → Boards Manager` → search "esp32" → install **esp32 by
   Espressif Systems**. The project machine has **3.3.11** installed (verified
   via `arduino-cli board details`, 2026-09-14); match it if you can. Note
   `START_HERE.md` still says 3.3.8 — it has drifted.
4. Select board: `Tools → Board → ESP32 Arduino → **ESP32 Wrover Module**`

| Setting | Value |
|---|---|
| Board | **ESP32 Wrover Module** |
| Upload Speed | 921600 |
| Flash Frequency | 80 MHz |
| Partition Scheme | Default 4MB with spiffs |

> ⛔ **"ESP32 Wrover Module" is not optional.** Choosing "ESP32 Dev Module"
> misconfigures PSRAM and the board crashes on boot. This already happened once.
> "ESP32S3 Dev Module" is wrong for a different reason — this is not an S3.

### 7.2 Turn compiler warnings on

`File → Preferences → Compiler warnings → **Default**` (or higher).

The sketch carries a deliberate `#warning` that fires on a flight build,
restating which defects were confirmed on hardware, which were closed by code
reading only, and that the servos have never been driven by this firmware. At
the IDE's default setting of "None" you would never see it.

### 7.3 Uploading

1. Open `Servo_Web_Calibrator_WROVER/Servo_Web_Calibrator_WROVER.ino`
2. Check `#define SIM_MODE` in `Pins.h` — for bench work **it must be `1`**
3. Set board (7.1) and port
4. Upload. Wait for `Hash of data verified` and `Hard resetting`

**The COM port moves.** The launcher enumerates as a **CH340** and has been seen
on COM6 and COM10; unplugging and replugging can move it. Never assume — plug
in, check `Tools → Port`, unplug, look again; the one that disappeared is yours.
It is a different device from the Cube Orange+.

**Only one program can hold a port.** If upload fails with "Access denied" or
"port busy", the Serial Monitor is almost certainly still open. Close it. This
has caught us three times.

### 7.4 There is no filesystem upload step

The old `uploadfs` instruction does not apply to this firmware. `ConfigManager`
calls `LittleFS.begin(true)`, which formats on first mount if needed, and
`/mission.json` **self-seeds from a PROGMEM default** (`MissionDefault.h`) when
it is missing. Waypoints and calibration are then written back to `mission.json`
from the device itself — the dashboard's Save button, or the SIM-only serial
commands `wpadd` / `wpradius` / `wpclear` / `wpsave`.

Nothing needs to be pushed to flash from the PC except the sketch.

### 7.5 Required libraries

Install via `Tools → Manage Libraries`:

| Library | Version | Purpose |
|---|---|---|
| TinyGPSPlus | ^1.0.3 | NMEA sentence parsing |
| ArduinoJson | ^7.0.0 | JSON config parsing |

`WiFi`, `WebServer`, `LittleFS` and `HardwareSerial` ship with the ESP32 core —
nothing to install.

### 7.6 Headless builds (arduino-cli)

`arduino-cli` is **not on PATH**. It ships inside the IDE install:

```bash
ARDUINO_CLI="C:/Program Files/Arduino IDE/resources/app/lib/backend/resources/arduino-cli.exe"
export ARDUINO_DIRECTORIES_DATA="C:/Users/carli/AppData/Local/Arduino15"

"$ARDUINO_CLI" compile --fqbn esp32:esp32:esp32wrover Servo_Web_Calibrator_WROVER
```

Using the IDE's own data directory is what makes the CLI see the same installed
core and libraries as the IDE. `esp32:esp32:esp32wrover` is the same board
profile as "ESP32 Wrover Module" in 7.1.

### 7.7 PlatformIO — historical only

`smart_launcher_phase2/smart_launcher/platformio.ini` targets
`freenove_esp32_wrover` and was the Phase 2 build. **That tree is not the flight
firmware and has not been touched since Phase 3 landed.** Its pin `build_flags`
were partly corrected during the WROVER port, but they still carry
`-DPIN_MAVLINK_RX=16 -DPIN_MAVLINK_TX=17` — the PSRAM-bus trap described in 4.1.
Do not copy pins out of it; `Pins.h` is the authority.

---

## 8. Firmware — Phase 2 Skeleton

### 8.1 Project structure

> ⚠️ **This is the Phase 2 skeleton's layout, not the flight firmware.** The
> live code is a flat Arduino sketch folder, `Servo_Web_Calibrator_WROVER/`,
> holding `Servo_Web_Calibrator_WROVER.ino` plus `Pins.h`, `ConfigManager`,
> `PositionSource` / `GNSSPositionSource` / `OsdkPositionSource` /
> `SimPositionSource` / `FallbackPositionSource`, `ActuatorModule`,
> `StateMachine`, `DropLogicEngine`, `RcPwmInput`, `Ballistics.h`,
> `MissionDefault.h` and `Logger`. The module responsibilities in 8.2 still
> describe it; the directory tree below does not. See 7.7.

```
smart_launcher/
├── platformio.ini              ← Board config, pins, libraries
├── partitions_custom.csv       ← 3MB firmware + 960KB LittleFS
├── data/
│   └── mission.json            ← Mission config (upload to LittleFS)
└── src/
    ├── main.cpp                ← Setup, loop, serial command handler
    ├── config/
    │   ├── ConfigManager.h
    │   └── ConfigManager.cpp   ← Load/parse mission.json from LittleFS
    ├── position/
    │   ├── IPositionSource.h   ← Abstract interface + Haversine()
    │   ├── GNSSPositionSource.h
    │   └── GNSSPositionSource.cpp  ← NMEA parser via TinyGPS++
    ├── actuator/
    │   ├── ActuatorModule.h
    │   └── ActuatorModule.cpp  ← Servo LEDC PWM + limit switch logic
    ├── safety/
    │   ├── StateMachine.h
    │   └── StateMachine.cpp    ← State machine + ARM button + LED
    ├── logging/
    │   ├── Logger.h
    │   └── Logger.cpp          ← Serial + LittleFS flash log
    └── logic/
        ├── DropLogicEngine.h
        └── DropLogicEngine.cpp ← Haversine check, sequential A→B firing
```

### 8.2 Module responsibilities

#### ConfigManager
- Mounts LittleFS on boot
- Parses `mission.json` into typed structs (`MissionConfig`, `DropPoint`, `ModuleConfig`)
- Provides `reload()` for hot-reload after Wi-Fi upload (Phase 3)
- Prints config summary to serial for verification

#### IPositionSource
- Pure abstract interface: `begin()`, `update()`, `read()`, `hasFix()`
- `haversineDistance()` inline function — returns distance in metres between two GPS coordinates
- Swap GNSS for MAVLink by changing one pointer in `main.cpp` — no other code changes

#### GNSSPositionSource
- Opens UART1 on GPIO 4/5 at 9600 baud
- Feeds bytes to TinyGPS++ decoder
- Updates internal `Position` struct on each valid NMEA sentence
- `hasFix()` returns true only when HDOP < 5.0 and satellites ≥ 4

#### ActuatorModule
- Configures LEDC at 50 Hz, 16-bit resolution
- `dropNext()`:
  - Doors 1–4: sends open PWM, waits exactly `travel_ms`, sends stop PWM
  - Door 5 (last): sends open PWM, polls limit switch until triggered OR timeout
  - Returns `DropResult::OK` or `DropResult::TIMEOUT`
- `stop()`: immediately sends 1500 µs (safe in any state)
- `reset()`: clears door counter (for bench testing and module swap)

#### StateMachine
```
BOOT ──(self-check OK)──▶ IDLE
IDLE ──(hold ARM 2s)────▶ ARMED
ARMED ──(drop executing)─▶ DROPPING
DROPPING ──(drop done)───▶ ARMED
ANY ──(fault detected)───▶ FAULT
ARMED ──(hold ARM 2s)────▶ IDLE  (disarm)
```

#### DropLogicEngine
- Called every `loop()` iteration; non-blocking (tracks IDLE / WAITING_A /
  WAITING_B itself, so the dashboard keeps running during a drop)
- Predicts where a seed released now would land (`Ballistics.h`, needs OSDK
  velocity; otherwise uses the aircraft position) and measures the Haversine
  distance from that point to the next pending waypoint
- **Release gate** — fires only when ARMED and all three hold:
  1. distance ≤ the waypoint's `radius_m`
  2. horizontal speed ≤ `release.max_speed_mps` (OSDK only; open on GNSS)
  3. 1 and 2 have held continuously for `release.dwell_s` while armed
     (any exit, or a disarm, restarts the count)
- Then: state → DROPPING, module A drives one door, B fires as soon as A
  reports done, back to ARMED, next waypoint
- Logs a `release` row (distance, radius, speed, limit, dwell, predicted or
  not) and one `drop` row per module to the JSONL flight log
- Reports FAR / APPROACHING / SLOW DOWN / SETTLING / IN RADIUS / DROPPING to the
  dashboard's APPROACH card, armed or not

#### Logger
- Writes human-readable CSV to `/logs/flight.log` on LittleFS
- Format: `timestamp_ms, drop_id, module, door_num, lat, lon, alt, result`
- `dumpLog()` prints entire log to serial (use after landing for review)

### 8.3 Drop sequence — detailed timing

```
Timeline (one waypoint, both modules):

T+0 ms    Enter radius → state = DROPPING
T+0 ms    Module A servo: 1700 µs (OPEN)
T+350 ms  Module A servo: 1500 µs (STOP) [timed, doors 1-4]
           OR limit switch triggers [door 5]
T+351 ms  Log Module A drop → Serial + LittleFS
T+351 ms  Module B servo: 1300 µs (OPEN)  ← fires immediately
T+701 ms  Module B servo: 1500 µs (STOP)
T+702 ms  Log Module B drop
T+702 ms  State = ARMED, advance to next waypoint
```

Total time per waypoint: **~700 ms** (at 350 ms travel_ms)

The release now waits for speed ≤ `release.max_speed_mps` (2.0 m/s by
default), so the aircraft moves at most ~1.4 m during this window. The fall
carry (2.6 m at 2 m/s from 8 m) is aimed for by the impact predictor when OSDK
velocity is available. With the predictor active, `radius_m` is an accuracy
tolerance — "fire when the seed is predicted to land within X m" — 5 m by
default.

---

## 9. Servo Tester Tool

A standalone Arduino sketch (`servo_tester.ino`) for bench testing servos before integrating with the full firmware.

### 9.1 Features
- Wi-Fi access point mode — no router needed
- Web interface at `http://192.168.4.1`
- Individual control of Module A and Module B
- OPEN / STOP / CLOSE buttons with correct preset PWM per module
- Fine-tuning slider (1000–2000 µs, 10 µs steps)
- Live limit switch indicators (auto-stops servo on trigger)
- Event log with timestamps
- Heartbeat LED blink on GPIO 22

### 9.2 How to use

1. Flash `servo_tester.ino` with Arduino IDE
2. Connect phone/laptop to Wi-Fi: **"SmartLauncher"** (no password)
3. Open browser → `http://192.168.4.1`
4. Status LED (GPIO 22) blinking = server healthy

### 9.3 PWM reference for FS5106R

| PWM (µs) | Module A direction | Module B direction |
|---|---|---|
| 1000 | Full speed reverse (CLOSE) | Full speed forward |
| 1300 | Slow reverse | Slow forward |
| 1500 | **STOP (neutral)** | **STOP (neutral)** |
| 1700 | Slow forward (OPEN) | Slow reverse |
| 2000 | Full speed forward | Full speed reverse |

> The two modules rotate in **opposite directions** because they retract toward each other for balance. This is reflected in the firmware (`module_a.servo_open_pwm_us = 1700`, `module_b.servo_open_pwm_us = 1300`).

> **Important:** The exact neutral point (true stop) may not be exactly 1500 µs. Use the slider to find the value where the servo is completely still. Record this as `servo_stop_pwm_us` in `mission.json`.

---

## 10. Mission Configuration

### 10.1 File location

The mission config lives at `/mission.json` on the ESP32 LittleFS filesystem.

**It is not uploaded from the PC.** On first boot it self-seeds from a PROGMEM
default (`MissionDefault.h`), and it is edited on the device thereafter:

- the Wi-Fi dashboard's **Save** button (edits live in RAM until you save), or
- the SIM-only serial commands `wpadd` / `wpradius` / `wpclear` / `wpsave`.

See 7.4. The annotated structure below documents the file's schema.

### 10.2 Full annotated config

```json
{
  "mission_name": "mangrove_plot_A",

  "min_gps_fix_duration_s": 10,
  // How many seconds of stable GPS fix required before ARM is allowed.
  // Prevents arming in poor reception. Range: 5–30s recommended.

  "position_source": "GNSS",
  // Parsed but NOT used. The firmware always takes DJI OSDK position first
  // and falls back to the onboard M8N automatically (see section 2).

  "modules": {
    "A": {
      "servo_open_pwm_us": 1700,
      // PWM to run servo in OPEN direction. 
      // Calibrate: should move rack ~35mm in travel_ms milliseconds.
      // Increase toward 2000 for faster travel, decrease toward 1500 for slower.

      "servo_stop_pwm_us": 1500,
      // PWM to hold servo stopped. Find true neutral with servo tester slider.
      // Common range: 1480–1520 µs depending on individual servo.

      "travel_ms": 350,
      // Time in milliseconds to travel exactly 35mm (one door width).
      // Theoretical: 293ms. Starting value: 350ms. Calibrate on bench.
      // If rack travels MORE than 35mm, reduce this value.
      // If rack travels LESS than 35mm, increase this value.

      "door_count": 5
      // Total seeds in this module. Do not change unless redesigning.
    },
    "B": {
      "servo_open_pwm_us": 1300,
      // Module B rotates opposite to A (1300 = open direction for B)
      "servo_stop_pwm_us": 1500,
      "travel_ms": 350,
      "door_count": 5
    }
  },

  "rc_trigger": {
    "enabled": false,
    // Pilot trigger on GPIO 35. Ships DISABLED: the F-channel is not wired
    // (section 4.5). Thresholds below are nominal, never measured on the A3.
    "safe_max_us": 1300, "fire_min_us": 1700,
    "frames_to_confirm": 5, "signal_timeout_ms": 500
  },

  "release": {
    // When an ARMED launcher fires. Edited from the dashboard:
    // Waypoints tab -> RELEASE SETTINGS -> Apply + Save. An absent block
    // means these defaults (the 2026-09-30 behaviour).
    "max_speed_mps": 2.0,
    // Horizontal speed at or below which a release is allowed (0.1-15).
    // Needs OSDK velocity; on the GNSS fallback the speed gate is open.
    "dwell_s": 0.0,
    // Seconds the in-radius-and-slow condition must hold, armed, before
    // firing (0-30). 0 = fire on the first qualifying sample. 1-2 s for a
    // hover drop. Any exit from the radius or speed window restarts it.
    "default_radius_m": 5.0
    // Radius given to new waypoints ("ADD WAYPOINT HERE", `wpadd`) and the
    // value "Default radius -> all waypoints" applies (0.5-100).
  },

  "drops": [
    // One entry per drop point, max 10. Each entry fires ONE door of Module A,
    // then ONE door of Module B as soon as A reports done (sequential, for
    // balance). 5 doors per module = 5 drop points per load.

    { "id": 1, "lat_deg": 9.345678, "lon_deg": -79.876543, "alt_m": 8.0, "radius_m": 3.0 },
    { "id": 2, "lat_deg": 9.345700, "lon_deg": -79.876520, "alt_m": 8.0, "radius_m": 3.0 },
    { "id": 3, "lat_deg": 9.345722, "lon_deg": -79.876497, "alt_m": 8.0, "radius_m": 3.0 },
    { "id": 4, "lat_deg": 9.345744, "lon_deg": -79.876474, "alt_m": 8.0, "radius_m": 3.0 },
    { "id": 5, "lat_deg": 9.345766, "lon_deg": -79.876451, "alt_m": 8.0, "radius_m": 3.0 }

    // radius_m: release tolerance in metres, tested against the PREDICTED
    // IMPACT point (aircraft position without OSDK velocity). Per waypoint,
    // editable in the Waypoints tab list. 5 m is the smallest that survives
    // the 1 Hz GNSS fallback; use 10 m for bench/walk tests.
    // alt_m is informational — the fall time uses the A3's height above takeoff.
  ]
}
```

### 10.3 Generating waypoints from QGroundControl

1. Plan mission in QGC with drop points as waypoints
2. Export as `.plan` file
3. Open `.plan` (it is JSON) and extract `lat`, `lon` from each waypoint item
4. Paste coordinates into `mission.json` drops array
5. Re-upload filesystem

Python helper script (coming in Phase 5):
```bash
python tools/convert_mission.py --input mission.plan --output data/mission.json
```

---

## 11. Cube Orange Setup

### 11.1 Firmware

- **Firmware:** ArduCopter V4.6.3 OFFICIAL (or latest stable)
- **Board:** CubeOrangePlus
- **Frame:** Hexa X (`FRAME_CLASS=2`, `FRAME_TYPE=1`)

### 11.2 Initial setup sequence (Mission Planner)

1. Connect via USB → COM port at 115200 baud
2. `Setup → Install Firmware` → select CubeOrangePlus → Copter V4.6.3
3. `Config → Mandatory Hardware → Frame Type` → Hexa X
4. `Config → Mandatory Hardware → Accel Calibration` → follow wizard (6 positions)
5. `Config → Mandatory Hardware → Compass` → calibrate (rotate drone on all axes)
6. `Config → Mandatory Hardware → Radio Calibration` → calibrate RC transmitter
7. `Config → Mandatory Hardware → ESC Calibration` → calibrate all 6 ESCs
8. Motor test (no props): `Setup → Optional Hardware → Motor Test` → verify correct order

### 11.3 TELEM2 parameters for Smart Launcher (Phase 4)

Set these in `Config → Full Parameter List`:

| Parameter | Value | Description |
|---|---|---|
| `SERIAL2_PROTOCOL` | `2` | MAVLink 2.0 on TELEM2 |
| `SERIAL2_BAUD` | `57` | 57600 baud |
| `SR2_POSITION` | `4` | GLOBAL_POSITION_INT at 4 Hz |
| `SR2_EXT_STAT` | `2` | Battery and GPS status |
| `SR2_EXTRA1` | `0` | Disable unnecessary messages |
| `SR2_EXTRA2` | `0` | Disable unnecessary messages |

Write parameters → reboot Cube Orange → TELEM2 will output MAVLink immediately on power-up.

### 11.4 TELEM2 wiring to ESP32 (Phase 4)

```
Cube Orange+ TELEM2      ESP32-WROVER-E
(JST-GH 6-pin)
─────────────────────────────────────────
Pin 1 (+5V)    →    NOT CONNECTED
Pin 2 (TX)     →    ESP32 UART RX  (pin TBD — NOT 16, see 4.6)
Pin 3 (RX)     →    ESP32 UART TX  (pin TBD — NOT 17, see 4.6)
Pin 4 (CTS)    →    NOT CONNECTED
Pin 5 (RTS)    →    NOT CONNECTED
Pin 6 (GND)    →    GND (common ground)
```

---

## 12. Bench Testing Protocol

Perform all these tests **before mounting on the drone** and **before any flight**.

### Test 1 — Power-on and boot

```
PASS criteria:
□ Status LED (GPIO 22) solid on → BOOT state; a brief GPIO 14 flicker at power-on is the boot ROM, not a fault
□ Serial monitor shows:
    === Smart Launcher booting ===
    [CFG] LittleFS mounted OK
    [CFG] Loaded 'mangrove_plot_A' — 5 drop points
    [HW] Servos initialised — both at 1500µs (STOP)
    [SM] State machine started — BOOT (state LED GPIO22, wait LED GPIO27)
    [SM] Disarmed → IDLE
    [MAIN] Boot complete — IDLE
□ LED solid YELLOW = IDLE state
□ No "FAULT" messages in serial output
```

### Test 2 — Servo neutral verification

```
Procedure:
1. Type 'dropa' in serial monitor
2. Observe servo A — it should NOT move (neutral test)
   If it moves: adjust servo_stop_pwm_us in mission.json
3. Repeat with 'dropb' for servo B

PASS criteria:
□ Servo A stationary at 1500µs (or calibrated neutral)
□ Servo B stationary at 1500µs (or calibrated neutral)
```

### Test 3 — Servo tester web interface

```
Procedure:
1. Flash servo_tester.ino
2. Connect to "SmartLauncher" Wi-Fi
3. Open http://192.168.4.1
4. Click OPEN for Module A — verify servo runs
5. Click STOP — verify servo stops
6. Click CLOSE — verify servo reverses
7. Manually press limit switch — verify:
   - Dot turns purple in interface
   - Servo auto-stops
8. Repeat for Module B

PASS criteria:
□ Both servos respond to commands
□ Both limit switches trigger auto-stop
□ Servo directions match OPEN/CLOSE labels
```

### Test 4 — Single door drop timing

```
Procedure:
1. Flash main firmware
2. Mark start position on rack with marker pen
3. Type 'arm' in serial monitor → status LED goes to a 2 Hz blink, wait LED steady on (§14)
4. Type 'dropa' → servo runs for travel_ms, stops
5. Measure how far rack moved
6. Adjust travel_ms via the dashboard's calibration Save (writes mission.json)
7. Reboot or reload config — no filesystem upload, see 7.4
8. Repeat until rack moves exactly 35mm

PASS criteria:
□ Module A rack moves 35mm ± 2mm per 'dropa' command
□ Module B rack moves 35mm ± 2mm per 'dropb' command
□ 'reset' command resets door counter
□ 5 consecutive drops complete, limit switch triggers on 5th
```

### Test 5 — GPS fix and arming

```
Procedure:
1. Take ESP32 outside (or near window) with GNSS connected
2. Power on — wait for GPS fix
3. Serial output should show:
    [GPS] UART1 started on RX=4 TX=5 @9600 baud
   After satellite acquisition (~60s):
    [MAIN] GPS stable for 10 s — ready to ARM
4. Hold ARM button for 2+ seconds → status LED goes to a 2 Hz blink, wait LED steady on (§14)

PASS criteria:
□ GPS acquires fix within 90s (cold start)
□ HDOP reported < 5.0
□ Satellites ≥ 4
□ ARM button hold triggers ARMED state
□ Serial shows: [SM] >>> ARMED <<<
```

### Test 6 — Full mission simulation (NMEA replay)

```
Procedure:
1. Record real NMEA sentences from your field location
   (or use gpsfake / miniterm to replay a .nmea file)
2. Feed NMEA over UART to ESP32 GNSS port
3. Arm the system
4. Verify drops trigger at correct waypoints
5. Verify A fires before B at each waypoint
6. After 5th waypoint: verify limit switches hit, mission complete

PASS criteria:
□ Each waypoint triggers exactly one drop
□ Module A fires first, B follows
□ Mission complete logged after waypoint 5
□ System disarms automatically
□ Serial log matches expected drop sequence
```

---

## 13. Calibration Guide

### 13.1 Finding servo neutral (true stop)

The FS5106R continuous rotation servo may not stop exactly at 1500 µs.  
Individual units vary ±20 µs.

**Using servo tester:**
1. Open `http://192.168.4.1`
2. Click STOP → note if servo is still moving slightly
3. Move slider slowly toward 1490 or 1510 until servo is completely still
4. Record the value (e.g. `1508`)
5. Update `servo_stop_pwm_us` in `mission.json`
6. Re-upload filesystem

### 13.2 Calibrating travel_ms (35mm per door)

**Method:**
1. Mark a reference line on the rack with a marker
2. Type `dropa` in serial monitor
3. Measure displacement with ruler
4. Calculate correction:
   ```
   new_travel_ms = current_travel_ms × (35 / measured_mm)
   Example: measured 40mm with 350ms
   new_travel_ms = 350 × (35/40) = 306 ms
   ```
5. Update `travel_ms` in `mission.json`, re-upload filesystem
6. Repeat until displacement is 35 ± 1 mm

### 13.3 Verifying balance (A vs B timing)

After calibrating both modules individually:
1. Weigh both modules with seeds loaded — should be equal
2. Run `dropa` and `dropb` with stopwatch
3. Total time for 5 doors should be equal between modules
4. If one module is faster: reduce its `travel_ms` slightly

---

## 14. State Machine & LED Reference

```
                    ┌──────┐
                    │ BOOT │  startup, self-check
                    └──┬───┘
                       │ config OK
                    ┌──▼───┐
              ┌────▶│ IDLE │  ready, drop logic off
              │     └──┬───┘
              │        │ ARM (dashboard button, or BOOT button held 2s)
              │     ┌──▼────┐
              │     │ ARMED │  drop logic active
              │     └──┬────┘
              │        │ in radius + armed
              │     ┌──▼──────────┐
              │     │  DROPPING   │  executing drop
              │     └──┬──────────┘
              │        │ drop complete
              └────────┘ back to ARMED

         Any state ──(error)──▶ FAULT  servos stopped
```

### There is no RGB LED on this board

State is signalled by **blink cadence across three single-colour LEDs**, not by
colour — `PIN_LED` is a plain 2-pin LED, not a WS2812. See
`StateMachine::_updateLED()` / `_updateWaitLED()`.

| State | Status LED (GPIO 22) | Wait LED, yellow (GPIO 27) |
|---|---|---|
| BOOT | Solid on | Dark until IDLE |
| IDLE | Slow single blink (150 ms on / 2 s period) | Slow blink (120 ms on / 1.5 s period) |
| ARMED | Steady 2 Hz blink (250/500 ms) | **STEADY ON** — the "waiting for trigger" state |
| DROPPING | Rapid blink (50/100 ms) | **Dark** — the announce LED has the floor |
| FAULT | Slow 50% on/off (500/1000 ms) | Rapid blink (100/200 ms) |

The wait LED is deliberately the **inverse** of the announce LED during DROPPING:
yellow steady = holding, yellow dark + announce lit = firing. That makes the
A→B handoff readable at a glance, and makes an unexpected re-fire after an
emergency stop obvious.

### Drop announce LED (GPIO 14)

Active in **both** SIM and flight builds, so bench behaviour matches the aircraft.
It is lit for exactly the window the servo is (or would be) driven, then — after
a 200 ms dark gap — blips out which module just dropped:

| Module | Confirm pattern |
|---|---|
| A | Short blips — 80 ms on / 120 ms off |
| B | Long blips — 400 ms on / 200 ms off |

> A brief flicker on GPIO 14 at power-on, before checkpoint `[1]` prints, is the
> boot ROM's PWM burst — expected, not a fault.

---

## 15. Serial Command Reference

Connect at **115200 baud**. The board enumerates as a **CH340** — no FTDI
adapter needed, but the port moves; see 7.3. Opening the port does *not* reset
the board (only `tools/bench_serial.py`'s explicit DTR/RTS sequence does), and
serial works at the same time as the Wi-Fi dashboard.

> Timing-critical sequences should be scripted with `tools/bench_serial.py`, not
> hand-typed.

Deliberately **no servo-moving commands**: motion stays behind the
dashboard's two-tap confirm.

| Command | Builds | Action |
|---|---|---|
| `help` | all | List the commands |
| `status` | all | State, position + source, OSDK health, doors, approach (state, distance, radius, speed vs limit, dwell), log size, worst loop |
| `arm` / `disarm` | all | Same as the dashboard buttons (no GPS-stability gate) |
| `stop` | all | Emergency stop — the same function as the dashboard's red bar |
| `wp` | all | List the waypoints with their radii |
| `rel` | all | Print the release settings |
| `rel <max_mps> <dwell_s> [default_r]` | SIM | Set them (RAM only — `wpsave` writes mission.json). Blocked while armed |
| `clearlog` | all | Delete the flight log (ask first — it may hold bench history) |
| `simpos <lat> <lon>` / `simclear` | SIM | Inject / clear a fake position |
| `simvel <vn> <ve>` | SIM | Give the injected fix a velocity (m/s) at 8 m, so prediction and speed gate run |
| `wpadd <lat> <lon> [r] [alt]` | SIM | Add a waypoint (r defaults to `release.default_radius_m`) |
| `wpradius <idx\|all> <r>` | SIM | Change a radius (1-based index, or all) |
| `wpclear` / `wpsave` | SIM | Clear the list / write mission.json |
| `balltest` | SIM | Impact-predictor self-test vectors |

**Example `status` output (SIM, armed, settling):**
```
state=2 armed=1 dropping=0
pos valid=1 9.0222514, -79.5322405 alt=8.0 src=OSDK
osdk frames=0 crcErr=0 health-fix=0
doorsA=0 doorsB=0 dropIdx=0 of 10
approach=SETTLING wp=1 dist=0.6 r=5.0 speed=0.5 max=2.0 dwell=1.2/2.0 aim=impact
log=474112 bytes  worstLoop=2 ms
```

States: 0=BOOT 1=IDLE 2=ARMED 3=DROPPING 4=FAULT. The flight log is read
from the dashboard (Control tab) or `/log?tail=0`, not over serial.

---

## 16. Flight Checklist

### Pre-flight (ground)

```
□ mission.json updated with correct waypoints for today's field site
□ Firmware uploaded from the Arduino IDE, board "ESP32 Wrover Module" (7.1)
□ SIM_MODE set deliberately in Pins.h — and limit switches wired if it is 0 (4.3)
□ Config summary verified in serial monitor (correct coordinates, radius)
□ Both modules loaded with seeds
□ Limit switches verified functional (test bench)
□ Travel_ms calibrated (35mm per door confirmed)
□ Servo neutral calibrated
□ All wiring secured, no loose connections
□ UBEC output verified: 5.0V ± 0.1V with multimeter
□ Common ground confirmed between UBEC, servos, ESP32
□ SD card inserted in Cube Orange
□ Cube Orange compass calibrated (if moved since last calibration)
□ Mission uploaded to Cube Orange via QGC
□ Geofence configured in Mission Planner (recommended)
```

### Arming sequence (field)

```
□ Power on launcher (UBEC) → LED = YELLOW (IDLE)
□ Wait for GPS fix → serial: "[MAIN] GPS stable for 10s"
□ LED still YELLOW — GPS acquired
□ Hold ARM button 2 seconds → status LED 2 Hz blink + wait LED steady on (ARMED)
□ Confirm: serial shows [SM] >>> ARMED <<<
□ Power on drone
□ Arm drone via RC transmitter (normal ArduPilot arm procedure)
□ Safety check: do NOT approach propellers after arming
□ Execute mission via QGC or RC
```

### Post-flight

```
□ Land drone
□ Disarm drone (RC transmitter)
□ Hold ARM button 2s → launcher LED = YELLOW (disarmed)
□ Power off drone + launcher
□ Connect ESP32 via USB
□ Open serial monitor → type 'log' → review drop events
□ Verify all 5 waypoints show OK drops for both modules
□ Note any TIMEOUT events for investigation
□ Remove empty modules, reload seeds for next mission
□ Type 'reset' before next mission if not reflashing
```

---

## 17. Troubleshooting

### Servo does not move

| Check | Action |
|---|---|
| Is system ARMED? | Type `arm` in serial, check LED is green |
| Is power supply on? | Verify UBEC 5V with multimeter |
| Is PWM wire connected? | Check GPIO 12 (A) or GPIO 13 (B) |
| Is common ground connected? | UBEC GND and ESP32 GND must share ground |
| Is servo signal 3.3V compatible? | FS5106R accepts 3.3V signal — should be fine |

### Servo does not stop

| Symptom | Cause | Fix |
|---|---|---|
| Servo creeps slowly | Neutral not calibrated | Use servo tester slider to find true stop |
| Servo runs continuously | Limit switch wired incorrectly or unwired | Verify COM→GND, NO→GPIO 32 (A) / 33 (B). Only the LAST door of a module reads the switch |
| Servo runs past door | travel_ms too high | Reduce by 20ms, re-test |

### GPS not acquiring fix

| Check | Action |
|---|---|
| Is antenna outdoors or near window? | GNSS needs sky view |
| Are UART wires swapped? | Verify GNSS TX → GPIO 4, GNSS RX → GPIO 5 |
| Is GNSS powered correctly? | 3.3V only — never connect to 5V |
| Cold start? | Wait 90s for first fix, 10s for warm start |
| Is baud rate correct? | Default M8N is 9600 — check `GNSSPositionSource` |

### LittleFS mount fails

```
[CFG] LittleFS mount FAILED
```
| Check | Action |
|---|---|
| Nothing to upload — is the partition scheme right? | Must be "Default 4MB with spiffs" (7.1). `LittleFS.begin(true)` formats on first mount, so a genuine mount failure is a partition or flash problem, not a missing upload |
| Board not selected correctly? | Must be **ESP32 Wrover Module** — "ESP32 Dev Module" misconfigures PSRAM (7.1) |

### Mission Planner cannot connect to Cube Orange

| Symptom | Fix |
|---|---|
| "USB Serial Device" in Device Manager | Install CubePilot driver from ardupilot.org |
| Two COM ports appear | Use the MAVLink port (not SLCAN) |
| Connected but no telemetry | Check baud rate = 115200 |
| PreArm: Check frame class | Set FRAME_CLASS=2, FRAME_TYPE=1 in Full Parameter List |

---

## 18. Development Roadmap

| Phase | Description | Status |
|---|---|---|
| **Phase 1** | Electronics, schematic, pin mapping, power budget | ✅ Complete |
| **Phase 2** | Firmware skeleton: GNSS, servo, config, state machine, logging | ✅ Complete |
| **Phase 3** | Wi-Fi AP config upload, NMEA bench replay tool | 🔲 Next |
| **Phase 4** | MAVLink position source (Cube Orange TELEM2) | 🔲 Planned |
| **Phase 5** | Python config tool: import QGC/UgCS missions, upload via serial | 🔲 Planned |
| **Phase 6** | Full flight testing protocol | 🔲 Planned |

### Phase 3 details (next sprint)

- **Wi-Fi AP config server:** Browse to `http://192.168.4.1/config` to upload new `mission.json` without USB
- **NMEA replay script:** Python script feeds recorded `.nmea` file over serial to simulate GPS flight path — allows full system test on bench without GPS signal
- **Watchdog timer:** Hardware watchdog to reset ESP32 if firmware hangs during flight

### Phase 4 details

- Implement `MavlinkPositionSource` parsing `GLOBAL_POSITION_INT` (MAVLink msg #33)
- Runtime selection: if `position_source = "MAVLINK"` in config, use TELEM2; else use GNSS
- Fallback: if MAVLink stops updating for 2 seconds, fall back to GNSS automatically

---

*Smart Launcher Project — Mangrove Reforestation Initiative*  
*Hardware: Freenove ESP32-WROVER-E + DJI M600 / A3 Pro (Cube Orange+ Standard Set = Phase 4)*  
*Firmware: ArduCopter V4.6.3 (Cube Orange+) + custom Arduino C++ built with the Arduino IDE*
