codreman2-eng/Smart-Mangrove/Servo_Web_Calibrator_WROVER/Servo_Web_Calibrator_WROVER.ino

/*
  Smart Launcher — Mission Dashboard + Calibrator (Phase 3)
  Board  : ESP32 Wrover Module  (Tools -> Board -> ESP32 Wrover Module,
           NOT "ESP32 Dev Module" — wrong board = PSRAM misconfig = boot crash)
  Flash  : 8MB, QIO, 80MHz, upload 921600

  This sketch merges two things that were previously separate:
    1. The servo calibrator (Stop/Offset/Reverse per module, slider,
       TIMED RUN, Apply Correction) — extensively hands-on validated on
       this exact board across many sessions. See PROJECT_HANDOFF.md for
       the full bug history (GPIO 2 strapping pin, GPIO 9/10 permanently
       reserved for flash+PSRAM on WROVER modules, direction-reversal fix,
       real-stop-tracking fix).
    2. The mission-control architecture from smart_launcher_phase2/ (a
       PlatformIO project): ConfigManager, StateMachine, Logger,
       GNSSPositionSource, DropLogicEngine — ported here near-verbatim as
       sibling files, EXCEPT ActuatorModule, which is a real rewrite:
       (a) uses ledcAttach(pin,...)/ledcWrite(pin,...) matching the
       calibrator's proven API, not PlatformIO's older forced
       ledcSetup/ledcAttachPin API; (b) is non-blocking (startDrop()+poll()
       instead of a blocking while-loop), because this sketch's loop()
       also runs server.handleClient() for the live dashboard — a blocking
       multi-second drop would freeze the dashboard during exactly the
       moment you'd most want to watch it.

  WHY THIS TOOLCHAIN (Arduino IDE / arduino-cli) AND NOT PLATFORMIO:
    PlatformIO's official espressif32 platform bundles an older
    Arduino-ESP32 core without ledcAttach(pin,...) at all. On its first
    live drop test, a stop value (1650us) measured via this calibrator did
    NOT stop the servo through that older core/API — it kept slowly
    rotating even after a full reboot re-wrote the same stop command.
    Re-measured via this calibrator afterward: true stop was 1670us, not
    1650. The two toolchains' differing underlying LEDC drivers is the
    likely explanation. This sketch's toolchain has the actual track
    record of calibration numbers holding up under re-verification — see
    PROJECT_HANDOFF.md for the full incident writeup.

    IMPORTANT: that's "proven more trustworthy by repeated measurement,"
    not "proven correct in an absolute sense." Recalibrate each module's
    stop value fresh after any significant firmware change — don't carry
    forward old numbers from memory or from a different toolchain.

  WIRING:
    Servo A signal -> GPIO 12   Servo B signal -> GPIO 13
    Limit switch A -> GPIO 32 (COM->GND, NO->GPIO, INPUT_PULLUP)
    Limit switch B -> GPIO 33 (COM->GND, NO->GPIO, INPUT_PULLUP)
    Heartbeat/state LED -> GPIO 22 (plain 2-pin LED, NOT WS2812)
    GNSS RX/TX -> GPIO 4/5 (UART1, u-blox M8N, 9600 baud)
    Servo power     -> external 5V (UBEC), NEVER from ESP32 pins
    Servo/limit GND -> external supply GND + ESP32 GND, all tied together
    NEVER USE GPIO 2 (strapping pin) or GPIO 9/10 (flash+PSRAM on WROVER).

  USE:
    Connect to Wi-Fi AP "SmartLauncher" (no password) -> http://192.168.4.1
    Two tabs: Mission Control (default) and Calibration. A sticky
    EMERGENCY STOP button is always visible regardless of tab.

    Calibration tab: same workflow as before — set Stop(us)/Offset(us),
    tick Reverse if OPEN/CLOSE come out backwards, TIMED RUN + measured-mm
    + Apply Correction to dial in travel_ms. Press "Save Calibration" to
    persist into mission.json (LittleFS) — nothing is written to flash on
    every slider drag, only on explicit save.

    Mission Control tab: ARM (confirmed) enables GPS-radius-triggered
    autonomous drops via DropLogicEngine. Manual DROP A / DROP B require
    ARMED state and a two-tap confirm (today's incident is exactly why —
    friction only on actions that cause motion, never on ones that stop
    it). Flight log viewer + Clear.

  mission.json self-seeds from a PROGMEM default (MissionDefault.h) on
  first boot if the file doesn't exist — Arduino IDE has no bundled
  equivalent of PlatformIO's `pio run --target uploadfs`.
*/

#include <Arduino.h>
#include <WiFi.h>
#include <WebServer.h>
#include "Pins.h"
#include "ConfigManager.h"
#include "PositionSource.h"
#include "GNSSPositionSource.h"
#include "Logger.h"
#include "StateMachine.h"
#include "ActuatorModule.h"
#include "DropLogicEngine.h"
#include "MissionDefault.h"
#include "SimPositionSource.h"
#include "OsdkPositionSource.h"
#include "RcPwmInput.h"
#include "Ballistics.h"

#if !SIM_MODE
#warning "FLIGHT BUILD: real servo PWM on GPIO 12/13. All four planted defects are closed: (a), (b), (e) fixed and re-verified on hardware 2026-08-25; (c) symptoms proven unreachable 2026-09-01. Still open before trusting a drop: T_EXIT_S is 0.0 and unmeasured, limit switches are unwired (LIMIT_SWITCHES_WIRED 0 - last door is timed), OSDK_VZ_IS_UP is unverified, and the impact predictor has never seen real aircraft data. Set SIM_MODE back to 1 before committing."
#endif

// ─── Objects ────────────────────────────────────────────────────────────
const char* SSID = "SmartLauncher";
WebServer server(80);

ConfigManager      cfg;
Logger             logger;
StateMachine       sm(PIN_LED, PIN_ARM_BUTTON, PIN_WAIT_LED);
GNSSPositionSource gnssSource(1, PIN_GNSS_RX, PIN_GNSS_TX, 9600);

// DJI M600 A3 Pro broadcast — 50Hz fused position, read-only. Wrapped so a
// loose connector degrades to the onboard M8N instead of taking the
// launcher's position away entirely, and so this same firmware still runs
// on the DIY ArduPilot aircraft, which has no OSDK at all.
OsdkPositionSource     osdkSource(2, PIN_OSDK_RX, PIN_OSDK_TX, OSDK_BAUD);
FallbackPositionSource realSource(osdkSource, gnssSource);

#if SIM_MODE
// In SIM builds the fake source sits IN FRONT of the real one and only
// takes over once a position is injected — so a fresh SIM boot runs on real
// aircraft position (the walk test) while /simpos still works indoors.
SimPositionSource  simSource;
IPositionSource*   posSource = &simSource;
#else
IPositionSource*   posSource = &realSource;
#endif

// Constructed with placeholder values here, rebuilt from config in setup()
ActuatorModule modA(PIN_SERVO_A, PIN_LIMIT_A, 1700, 1500, 350, 5, 'A');
ActuatorModule modB(PIN_SERVO_B, PIN_LIMIT_B, 1300, 1500, 350, 5, 'B');

DropLogicEngine* engine = nullptr;

// Pilot "drop now" trigger from the M600 A3 Pro F-channel. SUPPLEMENTS the
// GPS waypoint path — it fires a balanced A->B pair without consuming a
// planned waypoint, and it cannot arm: the dashboard still owns arming, so
// two independent authorities are required before anything drops.
RcPwmInput rcIn(PIN_RC_IN);

// Manual (dashboard) drops are not owned by DropLogicEngine, so nothing was
// moving the state machine into DROPPING for them — the dashboard and the
// state LED both reported ARMED for the whole manual drop window. Tracked
// here so the yellow WAIT LED and the reported state are truthful.
static bool manualDropActive = false;
// What the aircraft was doing when DROP A/B was pressed, for the log row
// written when the door finishes. Until 2026-10-31 manual drops left no row
// at all: 5 door openings in that day's log could only be inferred from
// state changes, 3 of them in flight at 1.5-1.7 m/s.
static Position manualDropPos;
static uint8_t  manualDropMod = 0;     // 0 = A, 1 = B

// A mission-status push older than this means the mission is not running
// (the A3 stops sending them when a mission ends). Fail-safe: a stale or
// missing push can only hold a drop back, never cause one.
#define DJI_MISSION_STALE_MS 3000

// ─── Flight logging ────────────────────────────────────────────────────
// 1 Hz periodic telemetry plus event rows on change. At ~150 bytes/row this
// is roughly 2 hours of flight inside the log's 1.1MB budget — a real
// mission is 15-20 min, so there is comfortable headroom. Raising this to
// 5 Hz would fill the budget in about 33 minutes; don't, without also
// revisiting MAX_LOG_BYTES.
#define TELEMETRY_INTERVAL_MS 1000    // armed / dropping
#define TELEMETRY_IDLE_MS    10000    // idle heartbeat only
static uint32_t last_tlm_ms   = 0;
// Change-detection state, so events are logged once per transition rather
// than every loop. Centralised here instead of sprinkled through the HTTP
// handlers — fewer call sites to keep in sync.
static uint8_t  last_state    = 255;
static bool     last_rc_sig   = false;
static uint8_t  last_rc_band  = 255;

// Worst loop() iteration seen in the current reporting window. Every ms
// spent in an HTTP handler is a ms in which position is not updated and the
// drop radius is not evaluated — so this IS the drop-latency figure, and it
// is measured rather than assumed. Reported on the dashboard and on serial.
static uint32_t loop_max_us      = 0;
static uint32_t loop_max_report  = 0;   // held for display between resets
static uint32_t loop_report_ms   = 0;

// ─── GPS fix stability tracking ────────────────────────────────────────
static uint32_t gps_fix_start_ms = 0;
static bool     gps_stable       = false;

bool checkGPSStable(IPositionSource* src, uint8_t required_s) {
    if (!src->hasFix()) { gps_fix_start_ms = 0; gps_stable = false; return false; }
    if (gps_fix_start_ms == 0) gps_fix_start_ms = millis();
    if (!gps_stable && (millis() - gps_fix_start_ms >= (uint32_t)required_s * 1000)) {
        gps_stable = true;
        Serial.printf("[MAIN] GPS stable for %d s\n", required_s);
    }
    return gps_stable;
}

// ─── Calibration-only raw PWM jog state (Calibration tab) ─────────────
// Separate from ActuatorModule's door-drop startDrop()/poll() — raw jogs
// (OPEN/STOP/CLOSE buttons, slider, TIMED RUN) don't count doors. Same
// non-blocking shape validated all session.
bool     calRunningA = false, calRunningB = false;
bool     calTimedActive = false;
bool     calTimedIsA    = true;
uint32_t calTimedStart  = 0;
uint32_t calTimedMs     = 0;

// ─── HTML split into chunks — avoids one large PROGMEM block ──────────
static const char HTML1[] =
"<!DOCTYPE html><html lang='en'><head>"
"<meta charset='UTF-8'>"
"<meta name='viewport' content='width=device-width,initial-scale=1'>"
"<title>Smart Launcher</title><style>"
"*{box-sizing:border-box;margin:0;padding:0}"
"body{font-family:sans-serif;background:#0f1117;color:#e0e0e0;padding:14px;padding-bottom:70px}"
"h1{color:#4ade80;text-align:center;font-size:1.2rem;margin-bottom:2px}"
".sub{text-align:center;color:#6b7280;font-size:.72rem;margin-bottom:14px}"
".tabs{display:flex;gap:6px;max-width:720px;margin:0 auto 14px}"
".tab-btn{flex:1;padding:10px;border:none;border-radius:8px;background:#1c1f26;color:#6b7280;font-weight:700;font-size:.82rem;cursor:pointer}"
".tab-btn.active{background:#1e3a5f;color:#93c5fd}"
".tab-panel{display:none}.tab-panel.active{display:block}"
".grid{display:grid;grid-template-columns:1fr 1fr;gap:10px;max-width:720px;margin:0 auto}"
".card{background:#1c1f26;border:1px solid #2a2d35;border-radius:12px;padding:16px}"
".card h2{font-size:.88rem;color:#93c5fd;margin-bottom:12px}"
".badge{display:inline-block;padding:3px 10px;border-radius:20px;font-size:.68rem;font-weight:700;margin-bottom:10px}"
".s-stop{background:#374151;color:#9ca3af}.s-open{background:#166534;color:#4ade80}"
".s-close{background:#7c2d12;color:#fb923c}.s-timed{background:#1e3a5f;color:#60a5fa}"
".s-armed{background:#166534;color:#4ade80}.s-idle{background:#713f12;color:#fbbf24}"
".s-dropping{background:#581c87;color:#e9d5ff}.s-fault{background:#7f1d1d;color:#fca5a5}"
".s-boot{background:#1e3a5f;color:#93c5fd}"
".pwm-val{font-size:1.9rem;font-weight:700;color:#f9fafb;text-align:center;margin:4px 0 2px}"
".pwm-unit{font-size:.68rem;color:#6b7280;text-align:center;margin-bottom:10px}"
"input[type=range]{width:100%;accent-color:#4ade80;margin-bottom:10px}"
".btns{display:grid;grid-template-columns:1fr 1fr 1fr;gap:5px;margin-bottom:8px}"
"button{padding:10px 0;border:none;border-radius:8px;font-size:.78rem;font-weight:700;cursor:pointer}"
".b-o{background:#166534;color:#4ade80}.b-s{background:#374151;color:#e5e7eb}"
".b-c{background:#7c2d12;color:#fb923c}.b-t{background:#1e3a5f;color:#60a5fa;width:100%;padding:9px 0;margin-top:4px}"
".b-danger{background:#7f1d1d;color:#fca5a5;width:100%;padding:10px 0;margin-top:4px}"
".b-confirm{background:#b45309;color:#fef3c7}"
".ref-row{display:flex;gap:6px;margin-bottom:8px}"
".ref-row div{flex:1}"
".ref-row label{font-size:.65rem;color:#6b7280;display:block;margin-bottom:2px}"
".ref-row input[type=number]{width:100%;padding:6px;background:#111318;border:1px solid #2a2d35;border-radius:6px;color:#f9fafb;font-size:.8rem;text-align:center}"
".preview{font-size:.66rem;color:#6b7280;text-align:center;margin-bottom:8px}"
".preview b{color:#93c5fd}"
".ms-row{display:flex;gap:6px;align-items:center;margin-top:6px}"
".ms-row input[type=number]{flex:1;padding:7px;background:#111318;border:1px solid #2a2d35;border-radius:6px;color:#f9fafb;font-size:.85rem;text-align:center}"
".ms-row label{font-size:.7rem;color:#6b7280}"
".pbar{width:100%;height:4px;background:#1f2937;border-radius:2px;margin-top:8px;overflow:hidden;display:none}"
".pfill{height:100%;background:#60a5fa;width:0%}"
".sw-bar{max-width:720px;margin:10px auto 0;background:#1c1f26;border:1px solid #2a2d35;border-radius:12px;padding:12px}"
".sw-bar h2{font-size:.78rem;color:#6b7280;margin-bottom:8px}"
".sw-row{display:flex;gap:20px;align-items:center;flex-wrap:wrap}"
".sw{display:flex;align-items:center;gap:8px;font-size:.78rem}"
".dot{width:12px;height:12px;border-radius:50%;background:#374151;transition:.2s}"
".dot.clear{background:#4ade80}.dot.hit{background:#a855f7;box-shadow:0 0 6px #a855f7}"
".up{margin-left:auto;font-size:.68rem;color:#374151}"
".log{max-width:720px;margin:10px auto 0;background:#1c1f26;border:1px solid #2a2d35;border-radius:12px;padding:12px;max-height:180px;overflow-y:auto}"
".log h2{font-size:.78rem;color:#6b7280;margin-bottom:6px}"
".le{font-size:.68rem;font-family:monospace;color:#a3e635;padding:2px 0;border-bottom:1px solid #1a1e27}"
".hint{max-width:720px;margin:10px auto 0;background:#1c1f26;border:1px solid #2a2d35;border-radius:10px;padding:12px;font-size:.7rem;color:#6b7280;line-height:1.7}"
".hint b{color:#93c5fd}"
".row2{display:flex;gap:10px;max-width:720px;margin:0 auto 10px}"
".row2 .card{flex:1}"
".kv{display:flex;justify-content:space-between;font-size:.75rem;padding:3px 0;color:#9ca3af}"
".kv b{color:#e5e7eb}"
".estop{position:fixed;bottom:0;left:0;right:0;background:#7f1d1d;color:#fecaca;border:none;"
"padding:16px;font-size:1rem;font-weight:800;letter-spacing:.05em;cursor:pointer;z-index:50}"
".estop:active{background:#991b1b}"
".toast{position:fixed;top:10px;left:50%;transform:translateX(-50%);background:#7f1d1d;color:#fecaca;"
"padding:10px 18px;border-radius:8px;font-size:.8rem;font-weight:700;z-index:100;display:none;"
"max-width:90%;text-align:center;box-shadow:0 4px 12px rgba(0,0,0,.4)}"
".toast.ok{background:#166534;color:#4ade80}"
"</style></head><body>"
"<div class='toast' id='toast'></div>"
"<h1>&#x1F680; Smart Launcher</h1>"
"<p class='sub'>ESP32 WROVER-E &nbsp;&#183;&nbsp; GPIO 12/13 servos &nbsp;&#183;&nbsp; LED 22 &nbsp;&#183;&nbsp; wait 27 &nbsp;&#183;&nbsp; 192.168.4.1</p>"
"<div class='tabs'>"
"<button class='tab-btn active' id='tabBtnMission' onclick='showTab(\"mission\")'>Control</button>"
"<button class='tab-btn' id='tabBtnWp' onclick='showTab(\"wp\")'>Waypoints</button>"
"<button class='tab-btn' id='tabBtnCal' onclick='showTab(\"cal\")'>Calibration</button>"
"</div>";

// Waypoints tab. The design centre is ADD WAYPOINT HERE: stand where you
// want a drop, tap once. No coordinates typed, no laptop, no import format
// — which is the only workflow that actually works in a mangrove field.
static const char HTML_WP[] =
"<div class='tab-panel' id='tabWp'>"
"<div class='sw-bar'><h2>CURRENT POSITION</h2>"
"<div class='sw-row'>"
"<div class='sw'><div id='wpFixDot' class='dot'></div><span id='wpFix'>no fix</span></div>"
"<div class='sw'><b id='wpHereLL' style='color:#e5e7eb'>--</b></div>"
"<div class='up' id='wpSrc'>--</div></div>"
"<div class='ms-row' style='margin-top:10px'>"
"<label>Radius</label><input type='number' id='wpR' value='5' min='0.5' max='100' step='0.5'>"
"<label>m &nbsp;(starts at the saved default radius below)</label></div>"
"<button class='b-o' style='width:100%;padding:14px;margin-top:8px;font-size:.9rem' "
"onclick='wpHere()'>&#128205; ADD WAYPOINT HERE</button>"
"</div>"
"<div class='sw-bar'><h2>MISSION <span id='wpCount' style='color:#374151'></span></h2>"
"<div id='wpWarn' style='display:none;background:#713f12;border:1px solid #b45309;"
"border-radius:8px;padding:8px;font-size:.68rem;color:#fbbf24;margin-bottom:8px'></div>"
"<div id='wpList' style='font-size:.7rem;color:#9ca3af'>(loading)</div>"
"<div class='btns' style='margin-top:10px'>"
"<button class='b-t' style='margin:0' onclick='wpRefresh()'>&#8635; Refresh</button>"
"<button class='b-c' onclick='wpClear()'>Clear all</button>"
"<button class='b-o' onclick='wpSave()'>&#128190; Save</button></div>"
"<div style='font-size:.66rem;color:#6b7280;margin-top:8px;line-height:1.6'>"
"Edits live in RAM until <b>Save</b> writes mission.json. Any edit rewinds "
"mission progress to waypoint 1. Blocked while armed."
"</div></div>"
// Release gate settings. These decide WHEN an armed launcher fires, so they
// sit next to the waypoints they apply to rather than on the Control tab.
"<div class='sw-bar'><h2>RELEASE SETTINGS <span style='color:#374151'>&#183; when an armed launcher fires</span></h2>"
"<div class='ref-row'>"
"<div><label>Max speed (m/s)</label><input type='number' id='relSpd' value='2.0' min='0.1' max='15' step='0.1' oninput='relPreview()'></div>"
"<div><label>Dwell (s)</label><input type='number' id='relDw' value='0' min='0' max='30' step='0.5'></div>"
"<div><label>Default radius (m)</label><input type='number' id='relR' value='5' min='0.5' max='100' step='0.5'></div>"
"</div>"
"<div class='preview' id='relCarry'>--</div>"
"<div class='btns' style='grid-template-columns:1fr 1fr'>"
"<button class='b-o' onclick='relApply()'>&#128190; Apply + Save</button>"
"<button class='b-t' style='margin:0' onclick='wpRadiusAll()'>Default radius &#8594; all waypoints</button></div>"
"<div style='font-size:.66rem;color:#6b7280;margin-top:8px;line-height:1.6'>"
"Fires when the <b>predicted impact point</b> is inside the waypoint's radius, horizontal speed is at or "
"below <b>Max speed</b>, and both have held for <b>Dwell</b> seconds while armed (0 = at once; 1-2 s for a "
"hover drop). Speed gate and prediction need DJI OSDK velocity &#8212; on the GNSS fallback only radius "
"and dwell apply. <b>Apply + Save</b> writes the whole mission.json, unsaved waypoint edits included. "
"<b>&#8594; all waypoints</b> is a waypoint edit: press <b>Save</b> above to keep it. Blocked while armed."
"</div></div>"
// Hover release mode settings — every condition tunable in the field.
"<div class='sw-bar'><h2>HOVER RELEASE <span style='color:#374151'>&#183; drop on a hover, no coordinates</span></h2>"
"<label style='font-size:.75rem;color:#e5e7eb;display:flex;align-items:center;gap:6px;margin-bottom:8px'>"
"<input type='checkbox' id='hvEn'> <b>Hover mode ON</b> &nbsp;<span style='color:#6b7280'>(waypoints are ignored while on)</span></label>"
"<div class='ref-row'>"
"<div><label>After flight (min)</label><input type='number' id='hvMin' value='0.25' min='0' max='60' step='0.25'></div>"
"<div><label>Min height (m)</label><input type='number' id='hvHmin' value='5' min='0' max='120' step='0.5'></div>"
"<div><label>Max height (m)</label><input type='number' id='hvHmax' value='15' min='0' max='120' step='0.5'></div>"
"</div><div class='ref-row'>"
"<div><label>Max speed (m/s)</label><input type='number' id='hvSpd' value='1.0' min='0.1' max='15' step='0.1'></div>"
"<div><label>Max vertical (m/s)</label><input type='number' id='hvVzMax' value='1.0' min='0.1' max='5' step='0.1'></div>"
"<div><label>Hold (s)</label><input type='number' id='hvHoldS' value='5' min='0' max='30' step='0.5'></div>"
"</div><div class='ref-row'>"
"<div><label>Min from takeoff (m)</label><input type='number' id='hvHome' value='30' min='0' max='5000' step='1'></div>"
"<div><label>Move between drops (m)</label><input type='number' id='hvRearm' value='10' min='0' max='1000' step='1'></div>"
"<div><label>Takeoff height (m)</label><input type='number' id='hvToh' value='3' min='0.5' max='20' step='0.5'></div>"
"</div><div class='ref-row'>"
"<div><label>&nbsp;</label><label style='display:flex;align-items:center;gap:6px;color:#e5e7eb'>"
"<input type='checkbox' id='hvB'> Also fire module B</label></div>"
"<div><label>&nbsp;</label><label style='display:flex;align-items:center;gap:6px;color:#e5e7eb'>"
"<input type='checkbox' id='hvMis'> Only during the DJI mission</label></div>"
"</div>"
"<button class='b-o' style='width:100%;margin-top:8px' onclick='hvApply()'>&#128190; Apply + Save</button>"
"<div style='font-size:.66rem;color:#6b7280;margin-top:8px;line-height:1.6'>"
"While <b>armed</b>, fires module A when <b>all</b> hold together for <b>Hold</b> seconds: airborne at least "
"<b>After flight</b> minutes (the clock starts when height passes <b>Takeoff height</b>), height between "
"<b>Min height</b> and <b>Max height</b>, at least <b>Min from takeoff</b> metres from where it took off, OSDK "
"speed at or below <b>Max speed</b>, climbing or descending no faster than <b>Max vertical</b> (so an RTH climb "
"or a landing never fires), the speed worked out from position agreeing (within 1 m/s), and at least "
"<b>Move between drops</b> metres from the last hover drop. With <b>Only during the DJI mission</b> it also "
"needs the A3 to report a GS Pro waypoint mission running, so stops after the mission ends never fire. "
"Needs DJI OSDK height and velocity &#8212; "
"without them it never fires. Blocked while armed."
"</div></div>"
"</div>";

#if SIM_MODE
// Loud, unmissable, and only present in SIM builds — you must never be in
// doubt about which firmware is on the board. Sent between HTML1 and the
// Mission tab (see handleRoot).
static const char HTML_SIM_BANNER[] =
"<div style='max-width:720px;margin:0 auto 14px;background:#713f12;border:1px solid #b45309;"
"border-radius:12px;padding:12px;text-align:center'>"
"<div style='color:#fbbf24;font-weight:800;font-size:.86rem;letter-spacing:.04em'>"
"&#x26A0;&#xFE0F; SIM MODE &#8212; NO SERVO OUTPUT</div>"
"<div style='color:#d1a054;font-size:.68rem;margin-top:5px;line-height:1.6'>"
"GPIO 12/13 are not attached &#8212; drops announce on the GPIO 14 LED instead.<br>"
"Timing, state, door counting and drop logic are identical to the flight build.<br>"
"Inject a position with <b>/simpos?lat=..&amp;lon=..</b> to trigger auto-fire."
"</div></div>";
#endif

// Mission Control tab
static const char HTML_MISSION[] =
"<div class='tab-panel active' id='tabMission'>"
// Hover release mode. Shown instead of APPROACH while hover mode is on: one
// row per condition, so a ground check shows exactly which one is missing.
"<div class='card' id='hvCard' style='margin-bottom:12px;text-align:center;display:none'><h2>HOVER RELEASE</h2>"
"<span id='hvBadge' class='badge s-stop' style='font-size:1rem;padding:6px 18px'>NO DATA</span>"
"<div id='hvLink' style='font-size:.72rem;line-height:1.5;margin:6px 0 4px;color:#9ca3af'>--</div>"
"<div style='font-size:1.4rem;font-weight:700;color:#f9fafb' id='hvHold'>--</div>"
"<div class='kv'><span id='hvTk'>&#9675;</span> Flight time: <b id='hvT'>--</b></div>"
"<div class='kv'><span id='hvHk'>&#9675;</span> Height above takeoff: <b id='hvH'>--</b></div>"
"<div class='kv'><span id='hvDk'>&#9675;</span> Distance from takeoff: <b id='hvD'>--</b></div>"
"<div class='kv'><span id='hvVk'>&#9675;</span> Speed (OSDK): <b id='hvV'>--</b></div>"
"<div class='kv'><span id='hvZk'>&#9675;</span> Vertical speed (OSDK): <b id='hvZ'>--</b></div>"
"<div class='kv'><span id='hvPk'>&#9675;</span> Speed (from position): <b id='hvP'>--</b></div>"
"<div class='kv'><span id='hvRk'>&#9675;</span> Moved since last drop: <b id='hvR'>--</b></div>"
"<div class='kv' id='hvMrow' style='display:none'><span id='hvMk'>&#9675;</span> DJI mission running: <b id='hvM'>--</b></div>"
"<div class='kv'>Hover drops: <b id='hvN'>0</b></div>"
"</div>"
"<div class='card' id='apCard' style='margin-bottom:12px;text-align:center'><h2>APPROACH</h2>"
"<span id='apBadge' class='badge s-stop' style='font-size:1rem;padding:6px 18px'>NO POSITION</span>"
"<div style='font-size:1.9rem;font-weight:700;color:#f9fafb' id='apDist'>--</div>"
"<div class='kv'>Next waypoint: <b id='apWp'>--</b></div>"
"<div class='kv'>Speed / release max: <b id='apSpd'>--</b></div>"
"<div class='kv'>Dwell / required: <b id='apDw'>--</b></div>"
"<div class='kv'>Aim: <b id='apPred'>--</b></div>"
"</div>"
"<div class='row2'>"
"<div class='card'><h2>STATE</h2>"
"<span id='stateBadge' class='badge s-boot'>BOOT</span>"
"<div class='kv'>Armed: <b id='armedVal'>no</b></div>"
"<div class='kv'>GPS fix: <b id='gpsVal'>--</b></div>"
"<div class='kv'>Lat/Lon: <b id='latlonVal'>--</b></div>"
"<div class='kv'>Sats/HDOP: <b id='satsVal'>--</b></div>"
"<div class='btns' style='margin-top:10px'>"
"<button class='b-o' id='armBtn' onclick='armTap()'>ARM</button>"
"<button class='b-s' onclick='doFetch(\"/disarm\")'>DISARM</button>"
"</div></div>"
"<div class='card'><h2>PROGRESS</h2>"
"<div class='kv'>Module A doors: <b id='doorsA'>0/5</b></div>"
"<div class='kv'>Module B doors: <b id='doorsB'>0/5</b></div>"
"<div class='kv'>Mission drops: <b id='dropIdx'>0/10</b></div>"
"<div class='btns' style='margin-top:10px'>"
"<button class='b-o' id='dropABtn' onclick='dropTap(\"A\")'>DROP A</button>"
"<button class='b-o' id='dropBBtn' onclick='dropTap(\"B\")'>DROP B</button>"
"</div>"
"<div id='doorWarn' style='display:none;font-size:.68rem;color:#fbbf24;margin-top:8px;line-height:1.5'></div>"
"<button class='b-t' id='resetDoorsBtn' style='width:100%;margin-top:8px' onclick='resetDoorsTap()'>&#8635; RESET DOOR COUNT</button>"
"<div style='font-size:.62rem;color:#6b7280;margin-top:4px;line-height:1.5'>Reload the rack to its start position first. "
"Disarm to use. Moves nothing.</div>"
"</div></div>"
"<div class='sw-bar'><h2>LIMIT SWITCHES</h2><div class='sw-row'>"
"<div class='sw'><div id='dotA' class='dot'></div>Module A (GPIO 32)</div>"
"<div class='sw'><div id='dotB' class='dot'></div>Module B (GPIO 33)</div>"
"<div class='sw'>worst loop <b id='loopMs' style='color:#e5e7eb'>--</b></div>"
"<div class='up' id='up'>--</div></div></div>"
"<div class='sw-bar'><h2>PILOT RC TRIGGER &nbsp;<span style='color:#374151'>M600 A3 F-channel &#183; GPIO 35</span></h2>"
"<div class='sw-row'>"
"<div class='sw'><div id='dotRc' class='dot'></div><span id='rcState'>no signal</span></div>"
"<div class='sw'><b id='rcUs' style='color:#e5e7eb'>--</b> us</div>"
"<div class='sw'><span id='rcBand' class='badge s-stop' style='margin:0'>NONE</span></div>"
"<div class='up' id='rcHz'>-- Hz</div></div>"
"<div style='font-size:.66rem;color:#6b7280;margin-top:7px;line-height:1.6'>"
"Supplements GPS &#8212; fires a balanced A&#8594;B pair without consuming a waypoint. "
"Cannot arm: the dashboard must arm first.</div></div>"
// The OSDK mission pushes counted by OsdkPositionSource. Whether the A3
// sends them for a GS Pro mission is the open question in
// reports/Estado de waypoints en el M600.md; this card is where a simulator
// run answers it. Display only.
"<div class='sw-bar'><h2>DJI MISSION (API) &nbsp;<span style='color:#374151'>OSDK 0x02/0x03 &#183; 0x02/0x04 &#183; listen-only</span></h2>"
"<div class='sw-row'>"
"<div class='sw'>status <b id='djMis' style='color:#e5e7eb'>0</b></div>"
"<div class='sw'>events <b id='djEvt' style='color:#e5e7eb'>0</b></div>"
"<div class='sw'>encrypted <b id='djEnc' style='color:#e5e7eb'>0</b></div>"
"<div class='up' id='djLast'>none seen</div></div>"
"<div style='font-size:.66rem;color:#6b7280;margin-top:7px;line-height:1.6'>"
"Shows whether the A3 reports GS Pro waypoint progress over the API (logged as <b>osdk_mission</b>). "
"<b>Not used to fire</b> &#8212; the release stays the radius + speed + dwell gate until a simulator run "
"proves these messages arrive.</div></div>"
"<div class='log'><h2>FLIGHT LOG <button class='b-danger' style='width:auto;padding:4px 10px;font-size:.65rem;float:right' onclick='clearLogTap()'>Clear</button></h2>"
"<label style='font-size:.66rem;color:#6b7280;display:flex;align-items:center;gap:5px;margin-bottom:6px'>"
"<input type='checkbox' id='logEv' checked onchange='refreshLog()'> Events only "
"(hide the 1&nbsp;Hz telemetry rows &#8212; drops are invisible without this)</label>"
"<pre id='flightLog' style='font-size:.68rem;color:#a3e635;white-space:pre-wrap'>(not loaded — tap Refresh)</pre>"
"<button class='b-t' onclick='refreshLog()'>Refresh Log</button></div>"
"</div>";

// Calibration tab — module cards with editable stop/offset, switches, log
static const char HTML2[] =
"<div class='tab-panel' id='tabCal'>"
"<p class='sub'>Door width: <input type='number' id='doorWidth' value='35' min='5' max='200' step='1' "
"style='width:56px;background:#111318;border:1px solid #2a2d35;border-radius:4px;color:#f9fafb;text-align:center'> mm"
" &nbsp;(used by Apply Correction below)</p>"
"<div class='grid'>"
"<div class='card'><h2>MODULE A <span style='color:#374151;font-size:.66rem'>GPIO 12</span></h2>"
"<span id='bdgA' class='badge s-stop'>STOP</span>"
"<div class='pwm-val' id='pvA'>1650</div><div class='pwm-unit'>us (last command)</div>"
"<div class='ref-row'>"
"<div><label>Stop (us)</label><input type='number' id='stopA' value='1670' min='1000' max='2000' step='5' oninput='preview(\"A\")'></div>"
"<div><label>Offset (us)</label><input type='number' id='offA' value='200' min='10' max='500' step='5' oninput='preview(\"A\")'></div>"
"</div>"
"<label style='font-size:.65rem;color:#6b7280;display:flex;align-items:center;gap:5px;margin-bottom:6px'>"
"<input type='checkbox' id='revA' onchange='preview(\"A\")'> Reverse OPEN/CLOSE (check if they came out swapped)</label>"
"<div class='preview' id='prevA'>OPEN=<b>1850</b> &nbsp; CLOSE=<b>1450</b></div>"
"<input type='range' id='slA' min='1000' max='2000' value='1670' step='5' oninput='slMove(\"A\",this.value)' onchange='slDrop(\"A\",this.value)'>"
"<div class='btns'>"
"<button class='b-o' onclick='pressOpen(\"A\")'>&#9654; OPEN</button>"
"<button class='b-s' onclick='pressStop(\"A\")'>&#9632; STOP</button>"
"<button class='b-c' onclick='pressClose(\"A\")'>&#9664; CLOSE</button></div>"
"<div class='ms-row'><input type='number' id='msA' value='580' min='50' max='9000' step='10'><label>ms</label></div>"
"<button class='b-t' onclick='timed(\"A\")'>&#9201; TIMED RUN</button>"
"<div class='pbar' id='pbA'><div class='pfill' id='pfA'></div></div>"
"<div class='ms-row'><input type='number' id='measA' placeholder='measured mm' min='0' max='500' step='0.5'>"
"<button class='b-t' style='flex:0 0 auto;padding:8px 10px;margin-top:0' onclick='applyCorrection(\"A\")'>Apply</button></div></div>"
"<div class='card'><h2>MODULE B <span style='color:#374151;font-size:.66rem'>GPIO 13</span></h2>"
"<span id='bdgB' class='badge s-stop'>STOP</span>"
"<div class='pwm-val' id='pvB'>1500</div><div class='pwm-unit'>us (last command)</div>"
"<div class='ref-row'>"
"<div><label>Stop (us)</label><input type='number' id='stopB' value='1500' min='1000' max='2000' step='5' oninput='preview(\"B\")'></div>"
"<div><label>Offset (us)</label><input type='number' id='offB' value='200' min='10' max='500' step='5' oninput='preview(\"B\")'></div>"
"</div>"
"<label style='font-size:.65rem;color:#6b7280;display:flex;align-items:center;gap:5px;margin-bottom:6px'>"
"<input type='checkbox' id='revB' onchange='preview(\"B\")'> Reverse OPEN/CLOSE (check if they came out swapped)</label>"
"<div class='preview' id='prevB'>OPEN=<b>1300</b> &nbsp; CLOSE=<b>1700</b></div>"
"<input type='range' id='slB' min='1000' max='2000' value='1500' step='5' oninput='slMove(\"B\",this.value)' onchange='slDrop(\"B\",this.value)'>"
"<div class='btns'>"
"<button class='b-o' onclick='pressOpen(\"B\")'>&#9654; OPEN</button>"
"<button class='b-s' onclick='pressStop(\"B\")'>&#9632; STOP</button>"
"<button class='b-c' onclick='pressClose(\"B\")'>&#9664; CLOSE</button></div>"
"<div class='ms-row'><input type='number' id='msB' value='350' min='50' max='9000' step='10'><label>ms</label></div>"
"<button class='b-t' onclick='timed(\"B\")'>&#9201; TIMED RUN</button>"
"<div class='pbar' id='pbB'><div class='pfill' id='pfB'></div></div>"
"<div class='ms-row'><input type='number' id='measB' placeholder='measured mm' min='0' max='500' step='0.5'>"
"<button class='b-t' style='flex:0 0 auto;padding:8px 10px;margin-top:0' onclick='applyCorrection(\"B\")'>Apply</button></div></div></div>"
"<button class='b-t' style='max-width:720px;display:block;margin:10px auto' onclick='saveCal()'>&#128190; Save Calibration to mission.json</button>"
// RC pilot trigger calibration — mirrors RC_Input_Calibration_Tool.ino's
// workflow (sweep the switch, read the travel, place thresholds) but on the
// board that will actually fly it. Use the standalone tool first for
// bring-up: proving an unknown hardware path in isolation has paid for
// itself twice on this project already.
"<div class='sw-bar'><h2>RC PILOT TRIGGER <span style='color:#374151'>&#183; GPIO 35 &#183; A3 F-channel</span></h2>"
"<div class='sw-row' style='margin-bottom:10px'>"
"<div class='sw'><div id='dotRc2' class='dot'></div><span id='rcState2'>no signal</span></div>"
"<div class='sw'>Live: <b id='rcUs2' style='color:#e5e7eb'>--</b> us</div>"
"<div class='sw'><span id='rcBand2' class='badge s-stop' style='margin:0'>NONE</span></div>"
"<div class='sw'>Seen: <b id='rcRange' style='color:#e5e7eb'>--</b></div>"
"<div class='up' id='rcHz2'>-- Hz</div></div>"
"<div class='ref-row'>"
"<div><label>SAFE max (us)</label><input type='number' id='rcSafe' value='1300' min='1000' max='2000' step='5'></div>"
"<div><label>FIRE min (us)</label><input type='number' id='rcFire' value='1700' min='1000' max='2000' step='5'></div>"
"<div><label>Confirm frames</label><input type='number' id='rcFrames' value='5' min='1' max='50' step='1'></div>"
"<div><label>Timeout (ms)</label><input type='number' id='rcTimeout' value='500' min='100' max='5000' step='50'></div>"
"</div>"
"<label style='font-size:.65rem;color:#6b7280;display:flex;align-items:center;gap:5px;margin:6px 0'>"
"<input type='checkbox' id='rcEn'> RC trigger enabled <span style='color:#374151'>(F-channel &#8594; GPIO 35 is not wired today &#8212; leave off)</span></label>"
"<div class='btns'>"
"<button class='b-t' style='margin:0' onclick='rcSweep()'>&#8635; Reset sweep</button>"
"<button class='b-t' style='margin:0' onclick='rcSuggest()'>&#9998; Suggest from sweep</button>"
"<button class='b-o' onclick='rcApply(1)'>&#128190; Apply + Save</button></div>"
"<div style='font-size:.66rem;color:#6b7280;margin-top:8px;line-height:1.7'>"
"<b style='color:#93c5fd'>Workflow:</b> Reset sweep &rarr; move the pilot switch through <b>every</b> position, "
"holding each ~2s &rarr; Suggest &rarr; check each position lands in the band you expect &rarr; Apply + Save.<br>"
"Glitches: <b id='rcGl'>0</b> &#183; frame rate should read ~50 Hz. Anything else means wiring, "
"common ground or voltage &#8212; fix that before trusting the thresholds."
"</div></div>"
"<div class='log'><h2>EVENT LOG</h2><div id='log'></div></div>"
"<div class='hint'><b>Workflow:</b><br>"
"1. Set Stop (us) — start from the last saved value, re-verify with a fresh watch-test if unsure.<br>"
"2. OPEN/CLOSE are Stop &#177; Offset (mirrored for B). Tick <b>Reverse</b> if they came out swapped.<br>"
"3. Mark the rack &rarr; TIMED RUN &rarr; measure &rarr; type into <b>measured mm</b> &rarr; <b>Apply</b> &rarr; repeat until measured &#8776; door width.<br>"
"4. Press <b>Save Calibration</b> when done — nothing is written to flash before that.</div>"
"</div>"
"<button class='estop' onclick='doFetch(\"/stop\")'>&#9724; EMERGENCY STOP</button>";

// JavaScript
static const char HTML3[] =
"<script>"
"function ts(){return new Date().toLocaleTimeString();}"
"function log(m,c){const d=document.getElementById('log');if(!d)return;const e=document.createElement('div');"
"e.className='le';e.style.color=c||'#a3e635';e.textContent='['+ts()+'] '+m;d.prepend(e);"
"if(d.children.length>60)d.removeChild(d.lastChild);}"
// Visible on BOTH tabs (unlike the event log, which only lives on
// Calibration) — server-side rejections (409 armed/blocked, 400 missing
// confirm, etc.) were previously silent, which is exactly what read as
// 'calibration doesn't work while armed' / 'drops work randomly'. They
// were working as designed (blocked), just never communicated.
"function toast(msg,isError){"
"const t=document.getElementById('toast');"
"t.textContent=msg;t.className='toast'+(isError?'':' ok');t.style.display='block';"
"clearTimeout(window._toastTimer);"
"window._toastTimer=setTimeout(()=>{t.style.display='none';},3500);}"
"function showTab(t){"
"[['mission','tabMission','tabBtnMission'],['wp','tabWp','tabBtnWp'],"
"['cal','tabCal','tabBtnCal']].forEach(([k,p,b])=>{"
"document.getElementById(p).className='tab-panel'+(t===k?' active':'');"
"document.getElementById(b).className='tab-btn'+(t===k?' active':'');});"
"if(t==='wp')wpRefresh();}"
"async function doFetch(url){"
"try{const r=await fetch(url);"
"if(!r.ok){const t=await r.text().catch(()=>'');toast('Blocked ('+r.status+'): '+t,true);log('Blocked: '+url+' -> '+r.status+' '+t,'#f87171');}"
"return r;"
"}catch(e){toast('Network error',true);log('Network error: '+url,'#f87171');return null;}}"
// --- Calibration (unchanged behaviour from the proven calibrator) ---
"function badge(mod,lbl,cls){const el=document.getElementById('bdg'+mod);el.textContent=lbl;el.className='badge '+cls;}"
"function clamp(v){return Math.min(2000,Math.max(1000,v));}"
"function stopOf(mod){return parseInt(document.getElementById('stop'+mod).value)||1500;}"
"function offOf(mod){return parseInt(document.getElementById('off'+mod).value)||200;}"
"function isRev(mod){return document.getElementById('rev'+mod).checked;}"
"function opensHigh(mod){return(mod==='A')===isRev(mod);}"
"function openPWM(mod){const s=stopOf(mod),o=offOf(mod);return clamp(opensHigh(mod)?s+o:s-o);}"
"function closePWM(mod){const s=stopOf(mod),o=offOf(mod);return clamp(opensHigh(mod)?s-o:s+o);}"
"function preview(mod){document.getElementById('prev'+mod).innerHTML="
"'OPEN=<b>'+openPWM(mod)+'</b> &nbsp; CLOSE=<b>'+closePWM(mod)+'</b>';}"
"function syncSlider(mod,v){document.getElementById('sl'+mod).value=v;document.getElementById('pv'+mod).textContent=v;}"
"function slMove(mod,v){syncSlider(mod,v);}"
"async function sendPwm(mod,pwm,lbl,cls){"
"const r=await doFetch('/cmd?mod='+mod+'&pwm='+pwm+'&stop='+stopOf(mod));"
"if(!r||!r.ok)return;"   // doFetch already toasted/logged the reason (usually: armed/dropping)
"syncSlider(mod,pwm);badge(mod,lbl,cls);log('Mod '+mod+' '+pwm+'us ('+lbl+')');}"
"async function slDrop(mod,v){v=parseInt(v);const s=stopOf(mod);"
"const lbl=v===s?'STOP':(opensHigh(mod)===(v>s)?'OPEN':'CLOSE');"
"const cls=lbl==='STOP'?'s-stop':lbl==='OPEN'?'s-open':'s-close';"
"await sendPwm(mod,v,lbl,cls);}"
"function pressOpen(mod){sendPwm(mod,openPWM(mod),'OPEN','s-open');}"
"function pressStop(mod){sendPwm(mod,stopOf(mod),'STOP','s-stop');}"
"function pressClose(mod){sendPwm(mod,closePWM(mod),'CLOSE','s-close');}"
"function applyCorrection(mod){"
"const measEl=document.getElementById('meas'+mod);"
"const measured=parseFloat(measEl.value);"
"const doorW=parseFloat(document.getElementById('doorWidth').value)||35;"
"if(!measured||measured<=0){log('Mod '+mod+': enter measured mm first','#f87171');return;}"
"const msEl=document.getElementById('ms'+mod);"
"const cur=parseInt(msEl.value)||350;"
"let next=Math.round(cur*(doorW/measured));"
"next=Math.max(50,Math.min(9000,next));"
"msEl.value=next;"
"log('Mod '+mod+' correction: '+cur+'ms \\u00d7 ('+doorW+'/'+measured+'mm) = '+next+'ms \\u2014 press TIMED RUN to verify','#60a5fa');"
"}"
"async function timed(mod){"
"const ms=parseInt(document.getElementById('ms'+mod).value);"
"if(isNaN(ms)||ms<50||ms>9000){log('ms must be 50-9000','#f87171');return;}"
"const op=openPWM(mod);"
"const r=await doFetch('/timed?mod='+mod+'&ms='+ms+'&pwm='+op+'&stop='+stopOf(mod));"
"if(!r||!r.ok)return;"   // doFetch already toasted/logged why (usually: armed/dropping)
"badge(mod,'TIMED','s-timed');"
"log('Mod '+mod+' TIMED '+ms+'ms @ '+op+'us','#60a5fa');"
"const pb=document.getElementById('pb'+mod);const pf=document.getElementById('pf'+mod);"
"pb.style.display='block';pf.style.width='0%';"
"const t0=Date.now();"
"const iv=setInterval(()=>{"
"const pct=Math.min(100,(Date.now()-t0)/ms*100);pf.style.width=pct+'%';"
"if(pct>=100){clearInterval(iv);"
"setTimeout(()=>{pb.style.display='none';pf.style.width='0%';},700);"
"const s=stopOf(mod);badge(mod,'STOP','s-stop');syncSlider(mod,s);"
"log('Mod '+mod+' DONE ('+ms+'ms) measure rack now!','#4ade80');}},50);}"
"async function saveCal(){"
"const body='stopA='+stopOf('A')+'&offA='+offOf('A')+'&revA='+(isRev('A')?1:0)+'&msA='+document.getElementById('msA').value"
"+'&stopB='+stopOf('B')+'&offB='+offOf('B')+'&revB='+(isRev('B')?1:0)+'&msB='+document.getElementById('msB').value;"
"const r=await fetch('/savecal?'+body).catch(()=>null);"
"log(r&&r.ok?'Calibration saved to mission.json':'Save FAILED',r&&r.ok?'#4ade80':'#f87171');}"
// --- Mission control ---
"let armConfirming=false,dropConfirming={A:false,B:false},clearConfirming=false;"
"function armTap(){"
"const b=document.getElementById('armBtn');"
"if(!armConfirming){armConfirming=true;b.textContent='CONFIRM?';b.className='b-confirm';"
"setTimeout(()=>{if(armConfirming){armConfirming=false;b.textContent='ARM';b.className='b-o';}},5000);return;}"
"armConfirming=false;b.textContent='ARM';b.className='b-o';doFetch('/arm');}"
"function dropTap(mod){"
"const b=document.getElementById('drop'+mod+'Btn');"
"if(!dropConfirming[mod]){dropConfirming[mod]=true;b.textContent='CONFIRM DROP '+mod+'?';b.className='b-confirm';"
"setTimeout(()=>{if(dropConfirming[mod]){dropConfirming[mod]=false;b.textContent='DROP '+mod;b.className='b-o';}},5000);return;}"
"dropConfirming[mod]=false;b.textContent='DROP '+mod;b.className='b-o';"
"doFetch('/drop'+mod.toLowerCase()+'?confirm=1');}"
"let resetConfirming=false;"
"function resetDoorsTap(){"
"const b=document.getElementById('resetDoorsBtn');"
"if(!resetConfirming){resetConfirming=true;b.textContent='RACK RELOADED? TAP AGAIN';b.className='b-confirm';"
"setTimeout(()=>{if(resetConfirming){resetConfirming=false;b.innerHTML='&#8635; RESET DOOR COUNT';b.className='b-t';}},5000);return;}"
"resetConfirming=false;b.innerHTML='&#8635; RESET DOOR COUNT';b.className='b-t';"
"doFetch('/resetdoors?confirm=1').then(r=>{if(r&&r.ok){toast('Door count reset - A 0/'+(window._dcA||5)+', ready to arm',false);"
"log('Door count reset (rack reloaded)','#4ade80');}});}"
"function clearLogTap(){"
"if(!clearConfirming){clearConfirming=true;log('Tap Clear again within 5s to confirm','#f87171');"
"setTimeout(()=>{clearConfirming=false;},5000);return;}"
"clearConfirming=false;doFetch('/clearlog').then(()=>refreshLog());}"
"async function refreshLog(){"
"try{const ev=document.getElementById('logEv');"
"const r=await fetch('/log'+((!ev||ev.checked)?'?ev=1':''));"
"const t=await r.text();"
"const el=document.getElementById('flightLog');"
"el.textContent=t||'(empty)';"
// Newest rows are appended, so without this the box shows the oldest lines
// and a drop that just happened sits off-screen below.
"el.parentElement.scrollTop=el.parentElement.scrollHeight;"
"}catch(e){}}"
// --- RC pilot trigger calibration ---
"let rcSeen={min:0,max:0},rcLoaded=false;"
"function rcSweep(){doFetch('/rccal?reset=1').then(r=>{if(r&&r.ok)log('RC sweep reset - move the switch through all positions','#60a5fa');});}"
"function rcSuggest(){"
"const sp=rcSeen.max-rcSeen.min;"
"if(!rcSeen.min||sp<200){toast('Not enough travel seen - sweep the switch first',true);"
"log('RC suggest: need a full sweep first (seen '+rcSeen.min+'-'+rcSeen.max+'us)','#f87171');return;}"
// 25%/75% of observed travel — wide dead bands so neither end is reachable
// by jitter alone. Same rule as the standalone tool, kept in sync deliberately.
"const s=Math.round(rcSeen.min+sp/4),f=Math.round(rcSeen.min+sp*3/4);"
"document.getElementById('rcSafe').value=s;document.getElementById('rcFire').value=f;"
"log('RC suggest from '+rcSeen.min+'-'+rcSeen.max+'us: safe<='+s+' fire>='+f+' - VERIFY each switch position before saving','#4ade80');"
"toast('Suggested '+s+'/'+f+' - verify, then Apply',false);}"
"async function rcApply(save){"
"const s=parseInt(document.getElementById('rcSafe').value);"
"const f=parseInt(document.getElementById('rcFire').value);"
"if(isNaN(s)||isNaN(f)||f<=s+50){toast('FIRE min must be >=50us above SAFE max',true);return;}"
"const q='/rccal?safe='+s+'&fire='+f"
"+'&frames='+parseInt(document.getElementById('rcFrames').value)"
"+'&timeout='+parseInt(document.getElementById('rcTimeout').value)"
"+'&en='+(document.getElementById('rcEn').checked?1:0)+(save?'&save=1':'');"
"const r=await doFetch(q);"
"if(!r||!r.ok)return;"
"log('RC trigger saved: safe<='+s+' fire>='+f,'#4ade80');toast('RC trigger saved',false);}"
"const RC_CLASS={NONE:'s-stop',SAFE:'s-armed',MID:'s-idle',FIRE:'s-fault'};"
"function rcPaint(j){"
"const cls=RC_CLASS[j.rcBand]||'s-stop';"
"['','2'].forEach(sfx=>{"
"const dot=document.getElementById('dotRc'+sfx);if(dot)dot.className='dot '+(j.rcSig?'clear':'');"
"const st=document.getElementById('rcState'+sfx);"
"if(st)st.textContent=!j.rcEn?'disabled':(j.rcSig?'signal ok':'no signal');"
"const us=document.getElementById('rcUs'+sfx);if(us)us.textContent=j.rcSig?j.rcUs:'--';"
"const bd=document.getElementById('rcBand'+sfx);"
"if(bd){bd.textContent=j.rcBand;bd.className='badge '+cls;}"
"const hz=document.getElementById('rcHz'+sfx);if(hz)hz.textContent=j.rcHz+' Hz';});"
// The RC form starts from what the board holds, once per page load. It used
// to start from hard-coded HTML defaults (enabled, 1300/1700), so Apply + Save
// silently re-enabled a trigger the board had saved as off.
"if(!rcLoaded&&j.rcSafe){rcLoaded=true;document.getElementById('rcEn').checked=!!j.rcEn;"
"document.getElementById('rcSafe').value=j.rcSafe;document.getElementById('rcFire').value=j.rcFire;}"
"rcSeen.min=j.rcMin;rcSeen.max=j.rcMax;"
"const rg=document.getElementById('rcRange');"
"if(rg)rg.textContent=j.rcMin?(j.rcMin+'-'+j.rcMax+'us'):'--';"
"const gl=document.getElementById('rcGl');if(gl)gl.textContent=j.rcGl;}"
// --- Waypoints ---
"let wpFixOk=false;"
"function wpRender(j){"
"const L=document.getElementById('wpList');"
"document.getElementById('wpCount').textContent='('+j.wp.length+'/'+j.max+')';"
"if(!j.wp.length){L.innerHTML='<i>No waypoints. Walk to a spot and tap ADD WAYPOINT HERE.</i>';}"
"else{L.innerHTML=j.wp.map((w,i)=>"
"'<div style=\"display:flex;gap:8px;align-items:center;padding:5px 0;border-bottom:1px solid #1a1e27\">'"
"+'<b style=\"color:#93c5fd;width:28px\">'+w.id+'</b>'"
"+'<span style=\"flex:1;font-family:monospace\">'+w.lat.toFixed(6)+', '+w.lon.toFixed(6)+'</span>'"
"+'<input type=\"number\" value=\"'+w.r+'\" min=\"0.5\" max=\"100\" step=\"0.5\" '"
"+'style=\"width:56px;background:#111318;border:1px solid #2a2d35;border-radius:4px;color:#f9fafb;text-align:center\" '"
"+'onchange=\"wpRadius('+i+',this.value)\">'"
"+'<span style=\"color:#6b7280\">m</span>'"
"+'<button class=\"b-c\" style=\"padding:3px 8px;font-size:.62rem\" onclick=\"wpDel('+i+')\">X</button>'"
"+'</div>').join('');}"
// The 10-waypoint default against 5 doors is a real trap: the engine would
// log phantom successes once the doors run out. Surface it in the UI.
"const W=document.getElementById('wpWarn');const cap=Math.min(j.doorsA,j.doorsB);"
"if(j.wp.length>cap){W.style.display='block';"
"W.innerHTML='&#9888; '+j.wp.length+' waypoints but only '+cap+' doors per module. '"
"+'Drops past #'+cap+' cannot fire - they would log as successful with no motion.';}"
"else W.style.display='none';"
// Fill the release card from the board once per page load, so a refresh
// does not overwrite values the operator is still typing.
"if(j.rel&&!relLoaded){relFill(j.rel);relLoaded=true;}"
"if(j.hover&&!hvLoaded){hvFill(j.hover);hvLoaded=true;}}"
"async function wpCall(q){"
"const r=await doFetch('/mission'+q);"
"if(!r||!r.ok)return null;"
"try{const j=await r.json();wpRender(j);return j;}catch(e){return null;}}"
"function wpRefresh(){wpCall('');}"
"function wpDel(i){wpCall('?del='+i).then(()=>log('Waypoint removed','#fb923c'));}"
"function wpRadius(i,v){wpCall('?radius='+i+'&r='+v);}"
"async function wpHere(){"
"if(!wpFixOk){toast('No position fix - cannot add a waypoint here',true);return;}"
"const r=document.getElementById('wpR').value;"
"const j=await wpCall('?add=here&r='+r);"
"if(j)  {toast('Waypoint '+j.wp.length+' added here',false);log('Waypoint added at current position','#4ade80');}}"
"function wpClear(){"
"if(!confirm('Delete ALL waypoints?'))return;"
"wpCall('?clear=1').then(()=>log('All waypoints cleared','#fb923c'));}"
"async function wpSave(){"
"const r=await doFetch('/mission?save=1');"
"if(r&&r.ok){toast('Mission saved to mission.json',false);log('mission.json written','#4ade80');}}"
// --- Release settings ---
"let relLoaded=false;"
"function relNum(id,lo,hi){const v=parseFloat(document.getElementById(id).value);"
"return(isNaN(v)||v<lo||v>hi)?null:v;}"
// Fall carry at the speed limit from the 8m mission height: what the
// predictor corrects for with OSDK velocity, and the downrange miss without it.
"function relPreview(){const v=relNum('relSpd',0.1,15);const el=document.getElementById('relCarry');"
"if(v===null){el.textContent='Max speed must be 0.1-15 m/s';return;}"
"const c=v*Math.sqrt(2*8/9.80665);"
"el.innerHTML='At <b>'+v.toFixed(1)+' m/s</b> from 8 m a seed carries <b>'+c.toFixed(1)+' m</b> forward '"
"+'&#8212; the predictor aims for it with OSDK velocity; on GNSS it lands that far past the waypoint.';}"
"function relFill(r){document.getElementById('relSpd').value=r.spd;document.getElementById('relDw').value=r.dwell;"
"document.getElementById('relR').value=r.defr;document.getElementById('wpR').value=r.defr;relPreview();}"
"async function relApply(){"
"const s=relNum('relSpd',0.1,15),d=relNum('relDw',0,30),R=relNum('relR',0.5,100);"
"if(s===null||d===null||R===null){toast('Speed 0.1-15 m/s, dwell 0-30 s, radius 0.5-100 m',true);return;}"
"const r=await doFetch('/release?spd='+s+'&dwell='+d+'&defr='+R+'&save=1');"
"if(!r||!r.ok)return;"
"try{const j=await r.json();relFill(j);"
"toast('Release saved: <= '+j.spd+' m/s, dwell '+j.dwell+' s, radius '+j.defr+' m',false);"
"log('Release saved: speed<='+j.spd+' m/s dwell='+j.dwell+' s default r='+j.defr+' m','#4ade80');}catch(e){}}"
// --- Hover release settings ---
"let hvLoaded=false;"
"const HV_F=[['hvMin','min',0,60],['hvHmin','h',0,120],['hvHmax','hmax',0,120],['hvHome','home',0,5000],"
"['hvSpd','spd',0.1,15],['hvVzMax','vz',0.1,5],['hvHoldS','hold',0,30],['hvRearm','rearm',0,1000],['hvToh','toh',0.5,20]];"
"function hvFill(h){document.getElementById('hvEn').checked=!!h.en;document.getElementById('hvB').checked=!!h.b;document.getElementById('hvMis').checked=!!h.mis;"
"for(const f of HV_F)document.getElementById(f[0]).value=h[f[1]];}"
"async function hvApply(){"
"let q='/hover?en='+(document.getElementById('hvEn').checked?1:0)+'&b='+(document.getElementById('hvB').checked?1:0)+'&mis='+(document.getElementById('hvMis').checked?1:0);"
"for(const f of HV_F){const v=relNum(f[0],f[2],f[3]);"
"if(v===null){toast(f[0]+': must be '+f[2]+'-'+f[3],true);return;}q+='&'+f[1]+'='+v;}"
"const r=await doFetch(q+'&save=1');"
"if(!r||!r.ok)return;"
"try{const h=await r.json();hvFill(h);"
"const s=h.en?('Hover ON: after '+h.min+' min, h '+h.h+'-'+h.hmax+' m, '+h.home+' m out, <='+h.spd+' m/s, vert <='+h.vz+' m/s for '+h.hold+' s'):'Hover mode OFF - waypoints fire';"
"toast(s,false);log(s,'#4ade80');}catch(e){}}"
"async function wpRadiusAll(){"
"const R=relNum('relR',0.5,100);if(R===null){toast('Radius must be 0.5-100 m',true);return;}"
"const j=await wpCall('?radiusall=1&r='+R);"
"if(j)toast('Radius '+R+' m on all '+j.wp.length+' waypoints - press Save to keep it',false);}"
"const STATE_NAMES=['BOOT','IDLE','ARMED','DROPPING','FAULT'];"
"const STATE_CLASS=['s-boot','s-idle','s-armed','s-dropping','s-fault'];"
"async function poll(){"
"try{const j=await(await fetch('/status')).json();"
"document.getElementById('dotA').className='dot '+(j.lA?'hit':'clear');"
"document.getElementById('dotB').className='dot '+(j.lB?'hit':'clear');"
"document.getElementById('up').textContent='up '+j.up+'s';"
"const sb=document.getElementById('stateBadge');"
"sb.textContent=STATE_NAMES[j.state]||'?';sb.className='badge '+(STATE_CLASS[j.state]||'s-boot');"
"document.getElementById('armedVal').textContent=j.armed?'yes':'no';"
"window._armed=(j.state===2||j.state===3);"   // ARMED or DROPPING -> pause log polling
"const lp=document.getElementById('loopMs');"
"if(lp)lp.textContent=j.loopMax+' ms';"
"document.getElementById('gpsVal').textContent=j.gpsValid?'valid':'no fix';"
"document.getElementById('latlonVal').textContent=j.gpsValid?(j.lat.toFixed(6)+', '+j.lon.toFixed(6)):'--';"
"document.getElementById('satsVal').textContent=j.gpsValid?(j.sats+' sats / hdop '+j.hdop.toFixed(1)):'--';"
"document.getElementById('doorsA').textContent=j.doorsA+'/'+j.doorCountA;"
"document.getElementById('doorsB').textContent=j.doorsB+'/'+j.doorCountB;"
"window._dcA=j.doorCountA;"
"{const w=document.getElementById('doorWarn');const ea=j.doorsA>=j.doorCountA,eb=j.doorsB>=j.doorCountB;"
"if(ea||eb){w.style.display='block';w.innerHTML='&#9888; Module '+(ea&&eb?'A and B':ea?'A':'B')+' empty'"
"+(ea?' - ARM will not hold':'')+'. Reload the rack, then RESET DOOR COUNT.';}else w.style.display='none';}"
"document.getElementById('dropIdx').textContent=j.dropIdx+'/'+j.dropTotal;"
"if(j.apSt!==undefined){"
"const AP_CLASS={'NO POSITION':'s-stop','MISSION DONE':'s-stop',FAR:'s-boot',APPROACHING:'s-idle',"
"'SLOW DOWN':'s-fault',SETTLING:'s-timed','IN RADIUS':'s-armed',DROPPING:'s-dropping'};"
"const ab=document.getElementById('apBadge');"
"ab.textContent=j.apSt;ab.className='badge '+(AP_CLASS[j.apSt]||'s-stop');"
"const live=!(j.apSt==='NO POSITION'||j.apSt==='MISSION DONE');"
"document.getElementById('apDist').textContent=live?(j.apDist.toFixed(1)+' m (r '+j.apR.toFixed(1)+')'):'--';"
"document.getElementById('apWp').textContent=live?('WP'+j.apWp):'--';"
"document.getElementById('apSpd').textContent=!live?'--':j.apSpdOk?"
"(j.apSpd.toFixed(1)+' / '+j.apMax.toFixed(1)+' m/s'):('no velocity - gate off');"
"document.getElementById('apPred').textContent=!live?'--':j.apPred?'predicted impact':'aircraft position';"
"document.getElementById('apDw').textContent=!(j.apDwSet>0)?'off (fires at once)':"
"(live?j.apDw.toFixed(1):'0.0')+' / '+j.apDwSet.toFixed(1)+' s';}"
// Hover card replaces APPROACH while hover mode is on
"{const hc=document.getElementById('hvCard'),on=!!j.hvOn;"
"hc.style.display=on?'block':'none';document.getElementById('apCard').style.display=on?'none':'block';"
"if(on){const HV_CLASS={'NO DATA':'s-stop','ON GROUND':'s-boot',WAITING:'s-idle',READY:'s-timed',"
"HOLDING:'s-armed',DROPPING:'s-dropping',DONE:'s-stop'};"
"const hb=document.getElementById('hvBadge');hb.textContent=j.hvSt;hb.className='badge '+(HV_CLASS[j.hvSt]||'s-stop');"
// Tell a missing wire from a missing GPS fix from missing broadcast fields:
// NO DATA alone reads as a dead link (it confused the operator on 2026-10-30)
"const now=Date.now();let fps=0;"
"if(window._fr0!==undefined&&now>window._ft0)fps=Math.max(0,Math.round((j.osdkFr-window._fr0)*1000/(now-window._ft0)));"
"window._fr0=j.osdkFr;window._ft0=now;"
"const lk=document.getElementById('hvLink');const fl=j.osdkFlag||0,hh=j.osdkHealth||0;"
"const setL=(t,c)=>{lk.innerHTML=t;lk.style.color=c;};"
"if(!j.osdkLink){if(j.hvSt==='NO DATA'){hb.textContent='NO DJI LINK';hb.className='badge s-fault';}"
"setL('&#10007; No data from the drone (A3). Check the GPIO 25 wire, the common ground, and that the drone is powered on.','#f87171');}"
"else if(!(fl&32)||!(fl&8)){if(j.hvSt==='NO DATA'){hb.textContent='LINK OK - MISSING DATA';hb.className='badge s-fault';}"
"setL('&#10003; Drone link OK ('+fps+' frames/s) but the broadcast is missing '+(!(fl&32)?'POSITION ':'')+(!(fl&8)?'VELOCITY':'')+'. Enable it in DJI Assistant 2.','#fbbf24');}"
"else if(hh<3){if(j.hvSt==='NO DATA'){hb.textContent='LINK OK - WAITING GPS';hb.className='badge s-idle';}"
"setL('&#10003; Drone link OK ('+fps+' frames/s). GPS health '+hh+'/5 - needs 3. Normal indoors: go outside and wait for satellites.','#fbbf24');}"
"else setL('&#10003; Drone link OK ('+fps+' frames/s) &#183; GPS health '+hh+'/5','#4ade80');"
"const ck=(id,ok)=>{const e=document.getElementById(id);e.innerHTML=ok?'&#10003;':'&#10007;';e.style.color=ok?'#4ade80':'#f87171';};"
"const m=Math.floor(j.hvT/60),s=Math.floor(j.hvT%60);"
"document.getElementById('hvT').textContent=j.hvAir?(m+'m '+(s<10?'0':'')+s+'s / '+j.hvTmin+' min'):'on ground';"
"document.getElementById('hvH').textContent=j.hvHok?(j.hvH.toFixed(1)+' m ('+j.hvHmin+'-'+j.hvHmax+')'):'no OSDK height';"
"document.getElementById('hvD').textContent=j.hvD<0?'no takeoff point':(j.hvD.toFixed(0)+' / '+j.hvDmin+' m');"
"document.getElementById('hvV').textContent=j.hvVok?(j.hvV.toFixed(1)+' / '+j.hvMax+' m/s'):'no OSDK velocity';"
"document.getElementById('hvZ').textContent=j.hvVok?(j.hvVz.toFixed(1)+' / '+j.hvVzMax+' m/s'):'no OSDK velocity';"
"document.getElementById('hvP').textContent=j.hvP<0?'--':(j.hvP.toFixed(1)+' m/s');"
"document.getElementById('hvR').textContent=j.hvR<0?'no drop yet':(j.hvR.toFixed(0)+' / '+j.hvRmin+' m');"
"document.getElementById('hvN').textContent=j.hvN;"
"document.getElementById('hvHold').textContent=j.hvSt==='HOLDING'?('hold '+j.hvHold.toFixed(1)+' / '+j.hvHoldSet+' s'):"
"j.hvSt==='READY'?'all met - ARM to fire':'--';"
"const c=j.hvOk;ck('hvTk',c&1);ck('hvHk',c&2);ck('hvDk',c&4);ck('hvVk',c&8);ck('hvPk',c&16);ck('hvRk',c&32);ck('hvZk',c&64);"
"document.getElementById('hvMrow').style.display=j.hvMisOn?'':'none';"
"if(j.hvMisOn){ck('hvMk',c&128);document.getElementById('hvM').textContent=(c&128)?'yes (GS Pro)':'no - mission not running';}}}"
"if(j.osdkMis!==undefined){"
"document.getElementById('djMis').textContent=j.osdkMis;"
"document.getElementById('djEvt').textContent=j.osdkEvt;"
"document.getElementById('djEnc').textContent=j.osdkEnc;"
"const dl=[];"
"if(j.misAge>=0)dl.push('status wp '+j.misWp+' st '+j.misSt+' ('+j.misAge+'s ago)');"
"if(j.evtAge>=0)dl.push('event wp '+j.evtWp+' st '+j.evtSt+' ('+j.evtAge+'s ago)');"
"document.getElementById('djLast').textContent=dl.length?dl.join(' \\u00b7 '):'none seen';}"
"rcPaint(j);"
"wpFixOk=j.gpsValid;"
"const fd=document.getElementById('wpFixDot');"
"if(fd){fd.className='dot '+(j.gpsValid?'clear':'');"
"document.getElementById('wpFix').textContent=j.gpsValid?'fix ok':'no fix';"
"document.getElementById('wpHereLL').textContent=j.gpsValid?"
"(j.lat.toFixed(6)+', '+j.lon.toFixed(6)):'--';"
"document.getElementById('wpSrc').textContent=j.posSrc+' | osdk '+j.osdkFr+'f '+j.osdkErr+'e';}"
"}catch(e){}}"
"setInterval(poll,350);"
// The log fetch is the most expensive request the board serves, and it runs
// inside the same loop() that updates position and evaluates the drop
// radius. While armed, that latency lands directly on drop timing — so the
// auto-refresh pauses and the Refresh button stays available.
"setInterval(()=>{if(!window._armed)refreshLog();},5000);"
"preview('A');preview('B');relPreview();refreshLog();"
"log('Connected - Mission Dashboard ready');"
"</script></body></html>";

// ─── Calibration raw-PWM write helper ──────────────────────────────────
void calWriteRaw(bool isModA, uint16_t pwm) {
    if (isModA) modA.writeRaw(pwm); else modB.writeRaw(pwm);
}

// ─── HTTP handlers — root / calibration (guarded while armed/dropping) ─
void handleRoot() {
    size_t total = strlen(HTML1) + strlen(HTML_MISSION) + strlen(HTML_WP)
                 + strlen(HTML2) + strlen(HTML3);
#if SIM_MODE
    total += strlen(HTML_SIM_BANNER);
#endif
    server.setContentLength(total);
    server.send(200, "text/html", "");
    server.sendContent(HTML1);
#if SIM_MODE
    server.sendContent(HTML_SIM_BANNER);
#endif
    server.sendContent(HTML_MISSION);
    server.sendContent(HTML_WP);
    server.sendContent(HTML2);
    server.sendContent(HTML3);
}

bool calibrationBlocked() {
    // A stale calibration click during a real mission is a real hazard now
    // that both feature sets share one servo driver.
    return sm.isArmed() || sm.isDropping();
}

void handleCmd() {
    if (calibrationBlocked()) { server.send(409, "text/plain", "blocked: armed/dropping"); return; }
    if (!server.hasArg("mod") || !server.hasArg("pwm")) {
        server.send(400, "text/plain", "bad"); return;
    }
    String mod = server.arg("mod");
    bool   isA = (mod == "A");
    int    pwm = constrain(server.arg("pwm").toInt(), 1000, 2000);

    if (server.hasArg("stop")) {
        int stopArg = constrain(server.arg("stop").toInt(), 1000, 2000);
        ActuatorModule& m = isA ? modA : modB;
        m.setCalibration(m.openPwm(), stopArg, m.travelMs());
    }
    uint16_t stopNow = isA ? modA.stopPwm() : modB.stopPwm();
    if (isA) calRunningA = (pwm != stopNow); else calRunningB = (pwm != stopNow);
    calWriteRaw(isA, pwm);

    Serial.printf("[CMD] %s %d us (stop=%d)\n", mod.c_str(), pwm, stopNow);
    server.send(200, "text/plain", "ok");
}

void handleTimed() {
    if (calibrationBlocked()) { server.send(409, "text/plain", "blocked: armed/dropping"); return; }
    if (!server.hasArg("mod") || !server.hasArg("ms") || !server.hasArg("pwm") || !server.hasArg("stop")) {
        server.send(400, "text/plain", "bad"); return;
    }
    String   mod     = server.arg("mod");
    bool     isA      = (mod == "A");
    uint32_t ms       = constrain((uint32_t)server.arg("ms").toInt(), 50, 9000);
    int      openPW   = constrain(server.arg("pwm").toInt(), 1000, 2000);
    int      stopArg  = constrain(server.arg("stop").toInt(), 1000, 2000);

    ActuatorModule& m = isA ? modA : modB;
    m.setCalibration(m.openPwm(), stopArg, m.travelMs());

    calTimedIsA    = isA;
    calTimedMs     = ms;
    calTimedStart  = millis();
    calTimedActive = true;
    if (isA) calRunningA = true; else calRunningB = true;
    calWriteRaw(isA, openPW);

    Serial.printf("[TIMED] %s %d us for %lu ms (stop=%d)\n", mod.c_str(), openPW, ms, stopArg);
    server.send(200, "text/plain", "ok");
}

void handleSaveCal() {
    // stopA/offA/revA/msA + stopB/offB/revB/msB
    uint16_t stopA = constrain(server.arg("stopA").toInt(), 1000, 2000);
    uint16_t offA  = constrain(server.arg("offA").toInt(), 10, 500);
    bool     revA  = server.arg("revA") == "1";
    uint32_t msA   = constrain((uint32_t)server.arg("msA").toInt(), 50, 9000);
    uint16_t stopB = constrain(server.arg("stopB").toInt(), 1000, 2000);
    uint16_t offB  = constrain(server.arg("offB").toInt(), 10, 500);
    bool     revB  = server.arg("revB") == "1";
    uint32_t msB   = constrain((uint32_t)server.arg("msB").toInt(), 50, 9000);

    uint16_t openA = computeOpenPwm(true,  stopA, offA, revA);
    uint16_t openB = computeOpenPwm(false, stopB, offB, revB);

    cfg.setModuleA(openA, stopA, msA, revA, offA);
    cfg.setModuleB(openB, stopB, msB, revB, offB);
    bool ok = cfg.save();

    if (ok) {
        modA.setCalibration(openA, stopA, msA);
        modB.setCalibration(openB, stopB, msB);
        Serial.printf("[CAL] Saved: A open=%d stop=%d ms=%lu rev=%d | B open=%d stop=%d ms=%lu rev=%d\n",
                      openA, stopA, msA, revA, openB, stopB, msB, revB);
    }
    server.send(ok ? 200 : 500, "text/plain", ok ? "ok" : "save failed");
}

// ─── HTTP handlers — mission control ───────────────────────────────────
void handleArm() {
    sm.requestArm();
    server.send(200, "text/plain", "ok");
}

void handleDisarm() {
    sm.requestDisarm();
    server.send(200, "text/plain", "ok");
}

void handleDropA() {
    if (!server.hasArg("confirm") || server.arg("confirm") != "1") {
        server.send(400, "text/plain", "confirm required"); return;
    }
    if (!sm.isArmed()) { server.send(409, "text/plain", "not armed"); return; }
    if (engine && engine->isBusy()) { server.send(409, "text/plain", "auto sequence in progress"); return; }
    // Snapshot BEFORE the drive starts: no flash write happens here, the row
    // is written once the door has finished (see loop()).
    Position p = posSource->read();
    bool started = modA.startDrop();
    if (started) {
        sm.setDropping(true); manualDropActive = true;
        manualDropPos = p; manualDropMod = 0;
    }
    server.send(started ? 200 : 409, "text/plain", started ? "ok" : "cannot start");
}

void handleDropB() {
    if (!server.hasArg("confirm") || server.arg("confirm") != "1") {
        server.send(400, "text/plain", "confirm required"); return;
    }
    if (!sm.isArmed()) { server.send(409, "text/plain", "not armed"); return; }
    if (engine && engine->isBusy()) { server.send(409, "text/plain", "auto sequence in progress"); return; }
    Position p = posSource->read();
    bool started = modB.startDrop();
    if (started) {
        sm.setDropping(true); manualDropActive = true;
        manualDropPos = p; manualDropMod = 1;
    }
    server.send(started ? 200 : 409, "text/plain", started ? "ok" : "cannot start");
}

// A manual DROP A/B has finished: a context row (what the aircraft was doing
// at the press) and a drop row with id 0, as a pilot RC pair logs. Called
// from loop() once the door is done, outside the drive window, so the flash
// write cannot stretch it.
static void logManualDrop() {
    ActuatorModule& m = manualDropMod ? modB : modA;
    const Position& p = manualDropPos;
    const char* res = DropLogicEngine::resultName(m.lastResult());
    char ex[160];
    snprintf(ex, sizeof(ex),
             "\"via\":\"http\",\"mod\":\"%c\",\"door\":%u,\"h\":%.1f,\"spd\":%.2f,\"res\":\"%s\"",
             manualDropMod ? 'B' : 'A', m.doorsDropped(),
             p.height_valid ? p.height_m : -1.0f,
             p.vel_valid ? p.horizontalSpeed() : -1.0f, res);
    logger.logEvent("manual_drop", ex);

    DropEvent evt;
    evt.timestamp_ms = millis();
    evt.drop_id      = 0;
    evt.module       = manualDropMod;
    evt.door_num     = m.doorsDropped();
    evt.lat_deg      = p.lat_deg;
    evt.lon_deg      = p.lon_deg;
    evt.alt_m        = p.alt_m;
    evt.success      = m.lastResult() == DropResult::OK;
    strncpy(evt.result_str, res, sizeof(evt.result_str));
    logger.logDrop(evt);
}

// Rack reloaded -> door counters back to 0 (Control tab RESET DOOR COUNT).
// Without it an emptied launcher stays "mission complete" and disarms every
// ARM until a reboot. Moves nothing; refused while armed or dropping.
static bool resetDoorCount(const char* via) {
    if (calibrationBlocked() || !engine || engine->isBusy() ||
        modA.isDropping() || modB.isDropping()) return false;
    char ex[80];
    snprintf(ex, sizeof(ex), "\"via\":\"%s\",\"a_was\":%u,\"b_was\":%u",
             via, modA.doorsDropped(), modB.doorsDropped());
    engine->resetDoors();
    logger.logEvent("doors_reset", ex);
    return true;
}

void handleResetDoors() {
    if (!server.hasArg("confirm") || server.arg("confirm") != "1") {
        server.send(400, "text/plain", "confirm required"); return;
    }
    if (!resetDoorCount("http")) {
        server.send(409, "text/plain", "blocked: disarm first"); return;
    }
    server.send(200, "text/plain", "ok");
}

#if SIM_MODE
// SIM-only: inject a fake position so the GPS-radius auto-fire path can be
// exercised indoors with no sky view.
//   /simpos?lat=9.345678&lon=-79.876543   -> waypoint 1 of the default mission
//   /simpos?clear=1                       -> back to reporting no fix
void handleSimPos() {
    if (server.hasArg("clear")) {
        simSource.clear();
        server.send(200, "text/plain", "cleared");
        return;
    }
    if (!server.hasArg("lat") || !server.hasArg("lon")) {
        server.send(400, "text/plain", "need lat & lon (or clear=1)");
        return;
    }
    double lat = server.arg("lat").toDouble();
    double lon = server.arg("lon").toDouble();
    if (lat < -90.0 || lat > 90.0 || lon < -180.0 || lon > 180.0) {
        server.send(400, "text/plain", "lat/lon out of range");
        return;
    }
    simSource.inject(lat, lon);
    server.send(200, "text/plain", "ok");
}
#endif

// THE emergency stop. Both entry points — the dashboard's /stop route and
// the serial 'stop' command — go through here and nowhere else.
//
// They used to be two independent copies of the same body. That is how the
// serial path kept defects (a) and (b) after the HTTP path was fixed: the fix
// landed on one copy and silently missed the other, and the regression test
// (which drives the serial path) caught it still firing module B. Two
// implementations of an emergency stop is one too many — if this ever needs a
// third entry point, it calls this function too.
//
// ORDER MATTERS. The engine is torn down FIRST, while _phase still says which
// module was in flight. Stopping the modules without resetting the phase IS
// defect (a): stop() clears _active, and the engine's very next tick reads
// that as "A finished" and starts B.
void emergencyStopAll() {
    if (engine) engine->abort();
    modA.stop();
    modB.stop();
    manualDropActive = false;      // a manual drop is over too
    calRunningA = calRunningB = false;
    calTimedActive = false;
    // NOT requestDisarm() — it is guarded to ARMED and silently no-ops from
    // DROPPING, which was defect (b).
    sm.emergencyStop();
    logger.logEvent("estop");
    Serial.println(F("[CMD] *** EMERGENCY STOP ***"));
}

void handleStop() {
    emergencyStopAll();
    server.send(200, "text/plain", "stopped");
}

// RC trigger calibration — set bands live and optionally persist them.
//   /rccal?safe=1300&fire=1700&frames=5&timeout=500&en=1[&save=1]
//   /rccal?reset=1     clears min/max/glitch stats (start a fresh sweep)
void handleRcCal() {
    if (server.hasArg("reset")) {
        rcIn.resetStats();
        server.send(200, "text/plain", "stats reset");
        return;
    }
    // Changing what can fire the launcher while it is armed is exactly the
    // kind of stale-click hazard the calibration guard already exists for.
    if (calibrationBlocked()) {
        server.send(409, "text/plain", "blocked: armed/dropping");
        return;
    }
    if (!server.hasArg("safe") || !server.hasArg("fire")) {
        server.send(400, "text/plain", "need safe & fire"); return;
    }
    uint16_t safe    = constrain(server.arg("safe").toInt(), 1000, 2000);
    uint16_t fire    = constrain(server.arg("fire").toInt(), 1000, 2000);
    uint8_t  frames  = server.hasArg("frames")  ? constrain(server.arg("frames").toInt(), 1, 50) : 5;
    uint16_t timeout = server.hasArg("timeout") ? constrain(server.arg("timeout").toInt(), 100, 5000) : 500;
    bool     en      = server.hasArg("en") ? (server.arg("en") == "1") : true;

    if (fire <= safe + 50) {
        server.send(400, "text/plain", "fire_min must be >=50us above safe_max");
        return;
    }

    rcIn.setBands(safe, fire, frames, timeout);
    rcIn.setEnabled(en);

    if (server.hasArg("save")) {
        cfg.setRcTrigger(en, safe, fire, frames, timeout);
        bool ok = cfg.save();
        Serial.printf("[RCCAL] Saved: en=%d safe<=%d fire>=%d frames=%d timeout=%dms\n",
                      en, safe, fire, frames, timeout);
        server.send(ok ? 200 : 500, "text/plain", ok ? "saved" : "save failed");
        return;
    }
    server.send(200, "text/plain", "ok");
}

// ─── Release gate settings ─────────────────────────────────────────────
static String releaseJson() {
    const ReleaseConfig& r = cfg.config().release;
    return "{\"spd\":"   + String(r.max_speed_mps, 1) +
           ",\"dwell\":" + String(r.dwell_s, 1) +
           ",\"defr\":"  + String(r.default_radius_m, 1) + "}";
}

// The one place a release-setting change is announced, so the HTTP route and
// the serial command cannot drift apart. The flight log is the record of
// what the gate was set to when a drop happened.
static void logReleaseChange(const char* via) {
    const ReleaseConfig& r = cfg.config().release;
    char ex[112];
    snprintf(ex, sizeof(ex), "\"via\":\"%s\",\"max\":%.1f,\"dwell\":%.1f,\"defr\":%.1f",
             via, r.max_speed_mps, r.dwell_s, r.default_radius_m);
    logger.logEvent("release_cfg", ex);
}

// Waypoints tab -> RELEASE SETTINGS.
//   /release                                       current values as JSON
//   /release?spd=2.0&dwell=1.5&defr=5[&save=1]     set (clamped), optionally persist
// Any argument may be omitted and keeps its current value. Always answers
// with what was actually stored, so the UI shows the clamped result.
void handleRelease() {
    const bool mutate = server.hasArg("spd") || server.hasArg("dwell") || server.hasArg("defr");
    if (mutate) {
        // What makes the launcher fire must not change under an armed engine —
        // the same stale-click guard as calibration and waypoint edits.
        if (calibrationBlocked()) {
            server.send(409, "text/plain", "blocked: armed/dropping"); return;
        }
        const ReleaseConfig cur = cfg.config().release;
        cfg.setRelease(server.hasArg("spd")   ? server.arg("spd").toFloat()   : cur.max_speed_mps,
                       server.hasArg("dwell") ? server.arg("dwell").toFloat() : cur.dwell_s,
                       server.hasArg("defr")  ? server.arg("defr").toFloat()  : cur.default_radius_m);
        logReleaseChange("http");
        if (server.hasArg("save") && !cfg.save()) {
            server.send(500, "text/plain", "save failed"); return;
        }
    }
    server.send(200, "application/json", releaseJson());
}

// ─── Hover release mode settings ───────────────────────────────────────
static String hoverJson() {
    const HoverConfig& h = cfg.config().hover;
    return String("{\"en\":") + (h.enabled ? "true" : "false") +
           ",\"min\":"   + String(h.min_flight_min, 2) +
           ",\"h\":"     + String(h.min_height_m, 1) +
           ",\"hmax\":"  + String(h.max_height_m, 1) +
           ",\"home\":"  + String(h.min_home_dist_m, 0) +
           ",\"spd\":"   + String(h.max_speed_mps, 1) +
           ",\"vz\":"    + String(h.max_vspeed_mps, 1) +
           ",\"hold\":"  + String(h.hold_s, 1) +
           ",\"rearm\":" + String(h.rearm_dist_m, 0) +
           ",\"toh\":"   + String(h.takeoff_height_m, 1) +
           ",\"b\":"     + (h.use_b ? "true" : "false") +
           ",\"mis\":"   + (h.need_mission ? "true" : "false") + "}";
}

// Like logReleaseChange(): what hover mode was set to when a drop happened
// is only knowable afterwards from the flight log.
static void logHoverChange(const char* via) {
    const HoverConfig& h = cfg.config().hover;
    char ex[240];
    snprintf(ex, sizeof(ex),
             "\"via\":\"%s\",\"en\":%s,\"min\":%.2f,\"h\":%.1f,\"hmax\":%.1f,"
             "\"home\":%.0f,\"spd\":%.1f,\"vz\":%.1f,\"hold\":%.1f,\"rearm\":%.0f,"
             "\"toh\":%.1f,\"b\":%s,\"mis\":%s",
             via, h.enabled ? "true" : "false", h.min_flight_min, h.min_height_m,
             h.max_height_m, h.min_home_dist_m, h.max_speed_mps, h.max_vspeed_mps,
             h.hold_s, h.rearm_dist_m, h.takeoff_height_m, h.use_b ? "true" : "false",
             h.need_mission ? "true" : "false");
    logger.logEvent("hover_cfg", ex);
}

// Waypoints tab -> HOVER RELEASE.
//   /hover                                         current values as JSON
//   /hover?en=1&min=0.25&h=5&hmax=15&home=30&spd=1&vz=1&hold=5&rearm=10&toh=3&b=0[&save=1]
// Any argument may be omitted and keeps its current value. Answers with what
// was actually stored (clamped).
void handleHover() {
    static const char* const KEYS[] = {"en", "min", "h", "hmax", "home", "spd", "vz",
                                       "hold", "rearm", "toh", "b", "mis"};
    bool mutate = false;
    for (const char* k : KEYS) mutate |= server.hasArg(k);
    if (mutate) {
        if (calibrationBlocked()) {
            server.send(409, "text/plain", "blocked: armed/dropping"); return;
        }
        HoverConfig h = cfg.config().hover;
        auto f = [](const char* k, float cur) {
            return server.hasArg(k) ? server.arg(k).toFloat() : cur;
        };
        if (server.hasArg("en")) h.enabled = server.arg("en") == "1";
        if (server.hasArg("b"))  h.use_b   = server.arg("b")  == "1";
        if (server.hasArg("mis")) h.need_mission = server.arg("mis") == "1";
        h.min_flight_min   = f("min",   h.min_flight_min);
        h.min_height_m     = f("h",     h.min_height_m);
        h.max_height_m     = f("hmax",  h.max_height_m);
        h.min_home_dist_m  = f("home",  h.min_home_dist_m);
        h.max_speed_mps    = f("spd",   h.max_speed_mps);
        h.max_vspeed_mps   = f("vz",    h.max_vspeed_mps);
        h.hold_s           = f("hold",  h.hold_s);
        h.rearm_dist_m     = f("rearm", h.rearm_dist_m);
        h.takeoff_height_m = f("toh",   h.takeoff_height_m);
        cfg.setHover(h);
        if (engine) engine->resetProgress();
        logHoverChange("http");
        if (server.hasArg("save") && !cfg.save()) {
            server.send(500, "text/plain", "save failed"); return;
        }
    }
    server.send(200, "application/json", hoverJson());
}

// ─── Waypoints tab ─────────────────────────────────────────────────────
// One route, action selected by query parameter:
//   /mission                       list waypoints as JSON (+ release settings)
//   /mission?add=here[&r=5]        add at the CURRENT position  <- field use
//   /mission?add=1&lat=&lon=&r=    add explicit coordinates
//   /mission?del=<index>
//   /mission?radius=<index>&r=<m>
//   /mission?radiusall=1&r=<m>     same radius on every waypoint
//   /mission?clear=1
//   /mission?save=1                persist to mission.json
// A missing r on add means release.default_radius_m.
void handleMission() {
    bool mutate = server.hasArg("add") || server.hasArg("del") ||
                  server.hasArg("clear") || server.hasArg("radius") ||
                  server.hasArg("radiusall") || server.hasArg("save");
    // Editing the mission mid-flight is exactly the stale-click hazard the
    // calibration guard already exists for — the engine indexes into this
    // list while armed.
    if (mutate && calibrationBlocked()) {
        server.send(409, "text/plain", "blocked: armed/dropping"); return;
    }

    if (server.hasArg("clear")) {
        cfg.clearDrops();
        if (engine) engine->resetProgress();
    } else if (server.hasArg("del")) {
        if (!cfg.removeDrop(server.arg("del").toInt())) {
            server.send(400, "text/plain", "bad index"); return;
        }
        if (engine) engine->resetProgress();
    } else if (server.hasArg("radius")) {
        float r = constrain(server.arg("r").toFloat(), 0.5f, 100.0f);
        if (!cfg.setDropRadius(server.arg("radius").toInt(), r)) {
            server.send(400, "text/plain", "bad index"); return;
        }
    } else if (server.hasArg("radiusall")) {
        if (!server.hasArg("r")) { server.send(400, "text/plain", "need r"); return; }
        cfg.setAllDropRadius(constrain(server.arg("r").toFloat(), 0.5f, 100.0f));
    } else if (server.hasArg("add")) {
        float r   = server.hasArg("r")   ? constrain(server.arg("r").toFloat(), 0.5f, 100.0f)
                                         : cfg.config().release.default_radius_m;
        float alt = server.hasArg("alt") ? server.arg("alt").toFloat() : 8.0f;
        double lat, lon;
        if (server.arg("add") == "here") {
            Position p = posSource->read();
            // Refuse rather than silently storing 0,0 — which would be a
            // waypoint in the Atlantic that never triggers, and would look
            // like a drop-logic bug rather than a missing fix.
            if (!p.valid) {
                server.send(409, "text/plain", "no position fix - cannot add here");
                return;
            }
            lat = p.lat_deg; lon = p.lon_deg;
            if (server.hasArg("alt") == false) alt = p.alt_m;
        } else {
            if (!server.hasArg("lat") || !server.hasArg("lon")) {
                server.send(400, "text/plain", "need lat & lon"); return;
            }
            lat = server.arg("lat").toDouble();
            lon = server.arg("lon").toDouble();
            if (lat < -90 || lat > 90 || lon < -180 || lon > 180) {
                server.send(400, "text/plain", "lat/lon out of range"); return;
            }
        }
        if (!cfg.addDrop(lat, lon, alt, r)) {
            server.send(409, "text/plain", "waypoint list full"); return;
        }
        if (engine) engine->resetProgress();
    } else if (server.hasArg("save")) {
        bool ok = cfg.save();
        server.send(ok ? 200 : 500, "text/plain", ok ? "saved" : "save failed");
        return;
    }

    // Always answer with the current list so the UI never needs a second call
    const MissionConfig& mc = cfg.config();
    String j = "{\"max\":" + String(cfg.maxDrops());
    j += ",\"doorsA\":" + String(modA.doorCount());
    j += ",\"doorsB\":" + String(modB.doorCount());
    j += ",\"rel\":" + releaseJson();
    j += ",\"hover\":" + hoverJson();
    j += ",\"wp\":[";
    for (uint8_t i = 0; i < mc.drop_count; i++) {
        if (i) j += ",";
        j += "{\"id\":" + String(mc.drops[i].id);
        j += ",\"lat\":" + String(mc.drops[i].lat_deg, 7);
        j += ",\"lon\":" + String(mc.drops[i].lon_deg, 7);
        j += ",\"alt\":" + String(mc.drops[i].alt_m, 1);
        j += ",\"r\":"   + String(mc.drops[i].radius_m, 1) + "}";
    }
    j += "]}";
    server.send(200, "application/json", j);
}

void handleLog() {
    // /log         last ~25KB, all rows
    // /log?ev=1    events only — the dashboard default, because two drop rows
    //              among hundreds of 1 Hz telemetry rows are invisible
    // /log?tail=0  whole file (slow on a big log — do this on the ground)
    uint32_t tail = server.hasArg("tail")
                  ? (uint32_t)server.arg("tail").toInt()
                  : Logger::TAIL_DEFAULT;
    logger.streamToHttp(server, server.hasArg("ev"), tail);
}

void handleClearLog() {
    logger.clearLog();
    server.send(200, "text/plain", "ok");
}

void handleStatus() {
    bool lA = (digitalRead(PIN_LIMIT_A) == LOW);
    bool lB = (digitalRead(PIN_LIMIT_B) == LOW);
    // Limit-switch auto-stop for raw calibration jogs only (door-drop
    // limit-switch handling lives inside ActuatorModule::poll()).
    if (lA && calRunningA) { modA.writeRaw(modA.stopPwm()); calRunningA = false; calTimedActive = false; }
    if (lB && calRunningB) { modB.writeRaw(modB.stopPwm()); calRunningB = false; calTimedActive = false; }

    Position p = posSource->read();
    const MissionConfig& mc = cfg.config();

    String j = "{";
    j += "\"lA\":"  + String(lA ? "true" : "false");
    j += ",\"lB\":" + String(lB ? "true" : "false");
    j += ",\"up\":" + String(millis() / 1000);
    j += ",\"state\":" + String((int)sm.state());
    j += ",\"armed\":" + String(sm.isArmed() ? "true" : "false");
    j += ",\"gpsValid\":" + String(p.valid ? "true" : "false");
    j += ",\"lat\":" + String(p.lat_deg, 6);
    j += ",\"lon\":" + String(p.lon_deg, 6);
    j += ",\"sats\":" + String(p.satellites);
    j += ",\"hdop\":" + String(p.hdop, 1);
    j += ",\"doorsA\":" + String(modA.doorsDropped());
    j += ",\"doorCountA\":" + String(modA.doorCount());
    j += ",\"doorsB\":" + String(modB.doorsDropped());
    j += ",\"doorCountB\":" + String(modB.doorCount());
    j += ",\"dropIdx\":" + String(engine ? engine->nextDropIndex() : 0);
    j += ",\"dropTotal\":" + String(mc.drop_count);
    // Approach to the next waypoint — the dashboard's APPROACH card
    if (engine) {
        const DropLogicEngine::ApproachInfo& ap = engine->approach();
        j += ",\"apSt\":\""  + String(DropLogicEngine::approachName(ap.state)) + "\"";
        j += ",\"apWp\":"    + String(ap.wp_id);
        j += ",\"apDist\":"  + String(ap.dist_m, 1);
        j += ",\"apR\":"     + String(ap.radius_m, 1);
        j += ",\"apSpd\":"   + String(ap.speed_mps, 1);
        j += ",\"apSpdOk\":" + String(ap.speed_valid ? "true" : "false");
        j += ",\"apPred\":"  + String(ap.predicted ? "true" : "false");
        j += ",\"apMax\":"   + String(mc.release.max_speed_mps, 1);
        j += ",\"apDw\":"    + String(ap.dwell_s, 1);
        j += ",\"apDwSet\":" + String(mc.release.dwell_s, 1);
    }
    // Hover release mode — the dashboard's HOVER RELEASE card
    if (engine && mc.hover.enabled) {
        const DropLogicEngine::HoverInfo& h = engine->hover();
        const HoverConfig& hc = mc.hover;
        const uint8_t ok = (h.ok_time  ? 1 : 0)  | (h.ok_height ? 2 : 0)  | (h.ok_home  ? 4 : 0) |
                           (h.ok_speed ? 8 : 0)  | (h.ok_agree  ? 16 : 0) | (h.ok_rearm ? 32 : 0) |
                           (h.ok_vert  ? 64 : 0) | (h.ok_mission ? 128 : 0);
        j += ",\"hvOn\":true";
        j += ",\"hvSt\":\""   + String(DropLogicEngine::hoverName(h.state)) + "\"";
        j += ",\"hvAir\":"    + String(h.airborne ? "true" : "false");
        j += ",\"hvT\":"      + String(h.flight_s, 0);
        j += ",\"hvTmin\":"   + String(hc.min_flight_min, 2);
        j += ",\"hvH\":"      + String(h.height_m, 1);
        j += ",\"hvHok\":"    + String(h.height_valid ? "true" : "false");
        j += ",\"hvHmin\":"   + String(hc.min_height_m, 1);
        j += ",\"hvHmax\":"   + String(hc.max_height_m, 1);
        j += ",\"hvD\":"      + String(h.home_dist_m, 1);
        j += ",\"hvDmin\":"   + String(hc.min_home_dist_m, 0);
        j += ",\"hvV\":"      + String(h.speed_mps, 1);
        j += ",\"hvVok\":"    + String(h.speed_valid ? "true" : "false");
        j += ",\"hvMax\":"    + String(hc.max_speed_mps, 1);
        j += ",\"hvVz\":"     + String(h.vspeed_mps, 1);
        j += ",\"hvVzMax\":"  + String(hc.max_vspeed_mps, 1);
        j += ",\"hvP\":"      + String(h.pos_speed, 1);
        j += ",\"hvR\":"      + String(h.rearm_m, 1);
        j += ",\"hvRmin\":"   + String(hc.rearm_dist_m, 0);
        j += ",\"hvHold\":"   + String(h.hold_s, 1);
        j += ",\"hvHoldSet\":" + String(hc.hold_s, 1);
        j += ",\"hvN\":"      + String(h.drops);
        j += ",\"hvOk\":"     + String(ok);
        j += ",\"hvMisOn\":"  + String(hc.need_mission ? "true" : "false");
    }
    // RC pilot trigger — live values feed the Calibration tab's RC card
    j += ",\"rcEn\":"   + String(rcIn.enabled() ? "true" : "false");
    j += ",\"rcSig\":"  + String(rcIn.hasSignal() ? "true" : "false");
    j += ",\"rcUs\":"   + String(rcIn.widthUs());
    j += ",\"rcBand\":\"" + String(RcPwmInput::bandName(rcIn.band())) + "\"";
    j += ",\"rcHz\":"   + String(rcIn.frameRateHz());
    j += ",\"rcMin\":"  + String(rcIn.minSeenUs() == 0xFFFF ? 0 : rcIn.minSeenUs());
    j += ",\"rcMax\":"  + String(rcIn.maxSeenUs());
    j += ",\"rcGl\":"   + String(rcIn.glitchCount());
    j += ",\"rcSafe\":" + String(rcIn.safeMaxUs());
    j += ",\"rcFire\":" + String(rcIn.fireMinUs());
    // OSDK link health — the walk test reads these to tell "no fix yet" from
    // "not receiving anything", which look identical from the LED alone.
    j += ",\"osdkFr\":"  + String(osdkSource.frames());
    j += ",\"osdkErr\":" + String(osdkSource.crcErrors());
    j += ",\"osdkFlag\":" + String(osdkSource.passFlag());
    j += ",\"osdkOk\":"  + String(osdkSource.hasFix() ? "true" : "false");
    {
        // Frames in the last second = the wire works, whatever the GPS says
        const uint32_t lf = osdkSource.lastFrameMs();
        j += ",\"osdkLink\":" + String(lf && millis() - lf < 1000 ? "true" : "false");
        j += ",\"osdkHealth\":" + String(osdkSource.gpsHealth());
    }
    j += ",\"osdkMis\":" + String(osdkSource.missionStatusFrames());
    j += ",\"osdkEvt\":" + String(osdkSource.missionEventFrames());
    j += ",\"osdkEnc\":" + String(osdkSource.encryptedFrames());
    {
        // Last decoded mission push; age -1 = never seen
        const uint32_t now = millis();
        const OsdkPositionSource::MissionLast& ms = osdkSource.lastMissionStatus();
        const OsdkPositionSource::MissionLast& me = osdkSource.lastMissionEvent();
        j += ",\"misWp\":"  + String(ms.wp) + ",\"misSt\":" + String(ms.st);
        j += ",\"misAge\":" + String(ms.ms ? (long)((now - ms.ms) / 1000) : -1L);
        j += ",\"evtWp\":"  + String(me.wp) + ",\"evtSt\":" + String(me.st);
        j += ",\"evtAge\":" + String(me.ms ? (long)((now - me.ms) / 1000) : -1L);
    }
    j += ",\"posSrc\":\"" + String(realSource.onPrimary() ? "OSDK" : "GNSS") + "\"";
    j += ",\"loopMax\":" + String(loop_max_report / 1000);   // ms
#if SIM_MODE
    j += ",\"sim\":true";
#else
    j += ",\"sim\":false";
#endif
    j += "}";
    server.send(200, "application/json", j);
}

// ─── Serial commands ───────────────────────────────────────────────────
// The Phase 2 firmware had these; the dashboard replaced them with HTTP and
// lost them. That was a mistake: the browser needs the SmartLauncher AP,
// which means no internet and no second device, and it is useless when the
// board is on a bench tethered to a laptop. Serial always works.
//
// Deliberately no servo-moving commands here. Motion stays behind the
// dashboard's two-tap confirm.
static void handleSerialLine(String s) {
    s.trim();
    if (!s.length()) return;
    int sp = s.indexOf(' ');
    String cmd = (sp < 0) ? s : s.substring(0, sp);
    String rest = (sp < 0) ? "" : s.substring(sp + 1);
    cmd.toLowerCase();

    if (cmd == "help" || cmd == "?") {
        Serial.println(F("commands: status | clearlog | resetdoors | arm | disarm | stop | wp | rel | hover"
                         " | simpos <lat> <lon> | simclear"));
#if SIM_MODE
        Serial.println(F("  bench (SIM only): wpadd <lat> <lon> [r] [alt] | "
                         "wpradius <idx|all> <r> | wpclear | wpsave"));
        Serial.println(F("  bench (SIM only): rel <max_mps> <dwell_s> [default_r] | "
                         "simvel <vn> <ve> [height_m]"));
        Serial.println(F("  bench (SIM only): hover en=1 min=0.25 h=5 hmax=15 home=30 spd=1 "
                         "vz=1 hold=5 rearm=10 toh=3 b=0 mis=0 [save]"));
        Serial.println(F("  bench (SIM only): balltest — impact-predictor self-test"));
#endif
        return;
    }
    if (cmd == "status") {
        Position p = posSource->read();
        const MissionConfig& mc = cfg.config();
        Serial.printf("state=%d armed=%d dropping=%d\n",
                      (int)sm.state(), sm.isArmed(), sm.isDropping());
        Serial.printf("pos valid=%d %.7f, %.7f alt=%.1f src=%s\n",
                      p.valid, p.lat_deg, p.lon_deg, p.alt_m,
                      realSource.onPrimary() ? "OSDK" : "GNSS");
        Serial.printf("osdk frames=%lu crcErr=%lu health-fix=%d\n",
                      (unsigned long)osdkSource.frames(),
                      (unsigned long)osdkSource.crcErrors(), osdkSource.hasFix());
        Serial.printf("doorsA=%d doorsB=%d dropIdx=%d of %d\n",
                      modA.doorsDropped(), modB.doorsDropped(),
                      engine ? engine->nextDropIndex() : 0, mc.drop_count);
        if (engine) {
            const DropLogicEngine::ApproachInfo& ap = engine->approach();
            Serial.printf("approach=%s wp=%d dist=%.1f r=%.1f speed=%.1f%s max=%.1f "
                          "dwell=%.1f/%.1f aim=%s\n",
                          DropLogicEngine::approachName(ap.state), ap.wp_id,
                          ap.dist_m, ap.radius_m, ap.speed_mps,
                          ap.speed_valid ? "" : "(no vel, gate off)",
                          mc.release.max_speed_mps, ap.dwell_s, mc.release.dwell_s,
                          ap.predicted ? "impact" : "aircraft");
        }
        Serial.printf("log=%lu bytes%s  worstLoop=%lu ms\n",
                      (unsigned long)logger.bytesUsed(),
                      logger.isFull() ? " (FULL)" : "",
                      (unsigned long)(loop_max_report / 1000));
        return;
    }
    if (cmd == "clearlog") { logger.clearLog(); return; }
    if (cmd == "resetdoors") {
        Serial.println(resetDoorCount("serial") ? F("doors reset: A=0 B=0")
                                                : F("blocked: disarm first"));
        return;
    }
    if (cmd == "arm")      { sm.requestArm();    return; }
    if (cmd == "disarm")   { sm.requestDisarm(); return; }
    if (cmd == "stop")     { emergencyStopAll(); return; }
    if (cmd == "wp") {
        const MissionConfig& mc = cfg.config();
        Serial.printf("%d waypoints\n", mc.drop_count);
        for (uint8_t i = 0; i < mc.drop_count; i++)
            Serial.printf("  [%d] %.7f, %.7f r=%.1fm\n", mc.drops[i].id,
                          mc.drops[i].lat_deg, mc.drops[i].lon_deg, mc.drops[i].radius_m);
        return;
    }
    // Release gate. Printing works in every build; setting is SIM-only, like
    // the waypoint editors below — a flight build changes it from the
    // dashboard. RAM only until `wpsave` (which writes the whole mission.json).
    if (cmd == "rel") {
        rest.trim();
#if SIM_MODE
        if (rest.length()) {
            if (calibrationBlocked()) { Serial.println(F("blocked: armed/dropping")); return; }
            float v[3];
            uint8_t nv = 0;
            String r = rest;
            while (nv < 3 && r.length()) {
                int sp2 = r.indexOf(' ');
                v[nv++] = (sp2 < 0 ? r : r.substring(0, sp2)).toFloat();
                if (sp2 < 0) break;
                r = r.substring(sp2 + 1); r.trim();
            }
            if (nv < 2) { Serial.println(F("usage: rel <max_mps> <dwell_s> [default_r]")); return; }
            cfg.setRelease(v[0], v[1], nv >= 3 ? v[2] : cfg.config().release.default_radius_m);
            logReleaseChange("serial");
            Serial.print(F("(RAM only - use wpsave)  "));
        }
#endif
        const ReleaseConfig& r = cfg.config().release;
        Serial.printf("release: speed<=%.1f m/s  dwell=%.1f s  default r=%.1f m\n",
                      r.max_speed_mps, r.dwell_s, r.default_radius_m);
        return;
    }
    // Hover release mode. Printing works in every build; setting is SIM-only,
    // like `rel`: in a flight build it is the dashboard's job.
    //   hover                              config + live conditions
    //   hover en=1 min=0.25 h=5 hmax=15 home=30 spd=1 vz=1 hold=5 rearm=10 toh=3 b=0 [save]
    if (cmd == "hover") {
        rest.trim();
#if SIM_MODE
        if (rest.length()) {
            if (calibrationBlocked()) { Serial.println(F("blocked: armed/dropping")); return; }
            HoverConfig h = cfg.config().hover;
            bool save = false;
            String r = rest + " ";
            int sp2;
            while ((sp2 = r.indexOf(' ')) >= 0) {
                String tok = r.substring(0, sp2);
                r = r.substring(sp2 + 1);
                if (!tok.length()) continue;
                if (tok == "save") { save = true; continue; }
                int eq = tok.indexOf('=');
                if (eq < 0) { Serial.printf("bad token '%s'\n", tok.c_str()); return; }
                String k = tok.substring(0, eq);
                float  v = tok.substring(eq + 1).toFloat();
                if      (k == "en")    h.enabled          = v != 0.0f;
                else if (k == "b")     h.use_b            = v != 0.0f;
                else if (k == "mis")   h.need_mission     = v != 0.0f;
                else if (k == "min")   h.min_flight_min   = v;
                else if (k == "h")     h.min_height_m     = v;
                else if (k == "hmax")  h.max_height_m     = v;
                else if (k == "home")  h.min_home_dist_m  = v;
                else if (k == "spd")   h.max_speed_mps    = v;
                else if (k == "vz")    h.max_vspeed_mps   = v;
                else if (k == "hold")  h.hold_s           = v;
                else if (k == "rearm") h.rearm_dist_m     = v;
                else if (k == "toh")   h.takeoff_height_m = v;
                else { Serial.printf("unknown key '%s'\n", k.c_str()); return; }
            }
            cfg.setHover(h);
            if (engine) engine->resetProgress();
            logHoverChange("serial");
            if (save) Serial.println(cfg.save() ? F("(saved)") : F("*** SAVE FAILED ***"));
            else      Serial.print(F("(RAM only - add 'save')  "));
        }
#else
        if (rest.length()) Serial.println(F("hover settings are SIM-only from serial - use the dashboard"));
#endif
        Serial.println("hover: " + hoverJson());
        if (engine && cfg.config().hover.enabled) {
            const DropLogicEngine::HoverInfo& h = engine->hover();
            Serial.printf("  state=%s airborne=%d t=%.0fs h=%.1f%s home=%.1f v=%.1f%s vz=%.1f "
                          "pv=%.1f rearm=%.1f hold=%.1f drops=%u "
                          "ok[T%d H%d D%d V%d Z%d P%d R%d M%d]\n",
                          DropLogicEngine::hoverName(h.state), h.airborne, h.flight_s,
                          h.height_m, h.height_valid ? "" : "(none)", h.home_dist_m,
                          h.speed_mps, h.speed_valid ? "" : "(none)", h.vspeed_mps,
                          h.pos_speed, h.rearm_m, h.hold_s, h.drops,
                          h.ok_time, h.ok_height, h.ok_home, h.ok_speed, h.ok_vert,
                          h.ok_agree, h.ok_rearm, h.ok_mission);
        }
        return;
    }
#if SIM_MODE
    if (cmd == "simpos") {
        int c = rest.indexOf(' ');
        if (c < 0) { Serial.println(F("usage: simpos <lat> <lon>")); return; }
        simSource.inject(rest.substring(0, c).toDouble(), rest.substring(c + 1).toDouble());
        return;
    }
    if (cmd == "simclear") { simSource.clear(); return; }
    if (cmd == "simvel") {
        int c = rest.indexOf(' ');
        if (c < 0) { Serial.println(F("usage: simvel <vn> <ve> [height_m]")); return; }
        String tail = rest.substring(c + 1); tail.trim();
        int c2 = tail.indexOf(' ');
        if (c2 < 0) simSource.injectVel(rest.substring(0, c).toFloat(), tail.toFloat());
        else        simSource.injectVel(rest.substring(0, c).toFloat(),
                                        tail.substring(0, c2).toFloat(),
                                        tail.substring(c2 + 1).toFloat());
        return;
    }

    // ── Bench-only waypoint editing ───────────────────────────────────────
    // The HTTP /mission API already does all of this, but it is reachable
    // ONLY from the SmartLauncher AP — and a laptop with a single Wi-Fi radio
    // has to abandon its own network (and its internet) to get there. Worse,
    // server.handleClient() runs inside loop(), so the 100-150ms telemetry
    // stalls drop TCP handshakes outright: scripted HTTP against this board
    // returned "connection refused" more often than 200. Serial has neither
    // problem, and bench work is already scripted through it.
    //
    // SIM_MODE-gated on purpose: a flight build must not carry a waypoint
    // editor that bypasses the dashboard's two-tap confirm.
    // Self-test for the impact predictor. The math is pure arithmetic, so it
    // can be verified with no aircraft, no GPS and no servos - the same way
    // the CRC and passFlag work was validated before touching hardware. This
    // runs the REAL firmware code on the REAL target, which a host-side
    // reimplementation would not: float behaviour here is what actually flies.
    // Expected values are in tools/test_ballistics.py; they reproduce the fall
    // -carry table in PROJECT_HANDOFF.md PHASE 4 RESEARCH.
    if (cmd == "balltest") {
        Serial.println(F("[BALL] fallTime(h, vd=0)  expect 1.00980 / 1.27732 / 1.74904"));
        Serial.printf("  h= 5m           -> %.5f s\n", Ballistics::fallTime(5.0f, 0.0f));
        Serial.printf("  h= 8m           -> %.5f s\n", Ballistics::fallTime(8.0f, 0.0f));
        Serial.printf("  h=15m           -> %.5f s\n", Ballistics::fallTime(15.0f, 0.0f));
        Serial.println(F("[BALL] vertical velocity (h=8m)  expect 1.17942 / 1.38336"));
        Serial.printf("  vd=+1 (descend) -> %.5f s\n", Ballistics::fallTime(8.0f,  1.0f));
        Serial.printf("  vd=-1 (climb)   -> %.5f s\n", Ballistics::fallTime(8.0f, -1.0f));

        Position t;
        t.valid = t.vel_valid = t.height_valid = true;
        t.lat_deg = 9.0222514; t.lon_deg = -79.5322405; t.height_m = 8.0f;

        Serial.println(F("[BALL] carry at h=8m  expect 2.55 / 6.39 / 10.22 m"));
        const float sp[3] = {2.0f, 5.0f, 8.0f};
        for (uint8_t i = 0; i < 3; i++) {
            t.vn_mps = sp[i]; t.ve_mps = 0.0f; t.vd_mps = 0.0f;
            Serial.printf("  %.0f m/s north   -> %.3f m\n", sp[i],
                          Ballistics::carryDistance(t));
        }

        double la, lo; float lead;
        // Degenerate case: at zero velocity the predictor MUST return the
        // aircraft position exactly, or it has changed hover behaviour.
        t.vn_mps = t.ve_mps = t.vd_mps = 0.0f;
        bool ok = Ballistics::predictImpact(t, la, lo, &lead);
        Serial.printf("[BALL] v=0 degenerate: ok=%d dLat=%.9f dLon=%.9f (expect 0,0)\n",
                      ok, la - t.lat_deg, lo - t.lon_deg);

        t.vn_mps = 5.0f;
        ok = Ballistics::predictImpact(t, la, lo, &lead);
        Serial.printf("[BALL] 5m/s north: ok=%d lead=%.5fs dLat=%.9f (expect +0.000057372)\n",
                      ok, lead, la - t.lat_deg);
        Serial.printf("       impact is %.2f m north of the aircraft\n",
                      (float)((la - t.lat_deg) * 111320.0));

        t.ve_mps = 5.0f; t.vn_mps = 0.0f;
        ok = Ballistics::predictImpact(t, la, lo, &lead);
        Serial.printf("[BALL] 5m/s east:  ok=%d dLon=%.9f -> %.2f m east\n",
                      ok, lo - t.lon_deg,
                      (float)((lo - t.lon_deg) * 111320.0 * cos(t.lat_deg * DEG_TO_RAD)));

        Serial.println(F("[BALL] fail-closed gates  ALL must be ok=0"));
        Position g = t;
        g.vel_valid = false;
        Serial.printf("  no velocity health -> ok=%d\n", Ballistics::predictImpact(g, la, lo));
        g = t; g.height_valid = false;
        Serial.printf("  no height          -> ok=%d\n", Ballistics::predictImpact(g, la, lo));
        g = t; g.valid = false;
        Serial.printf("  no fix             -> ok=%d\n", Ballistics::predictImpact(g, la, lo));
        g = t; g.height_m = 200.0f;
        Serial.printf("  height 200m        -> ok=%d\n", Ballistics::predictImpact(g, la, lo));
        g = t; g.vn_mps = 99.0f;
        Serial.printf("  speed 99 m/s       -> ok=%d\n", Ballistics::predictImpact(g, la, lo));
        return;
    }

    if (cmd == "wpadd" || cmd == "wpradius" || cmd == "wpclear" || cmd == "wpsave") {
        // Same rule the HTTP route enforces — the engine indexes into this
        // list while armed, so editing it mid-mission is the stale-click hazard.
        if (calibrationBlocked()) {
            Serial.println(F("blocked: armed/dropping"));
            return;
        }

        String tok[4];
        uint8_t nt = 0;
        {
            String r = rest; r.trim();
            while (nt < 4 && r.length()) {
                int sp2 = r.indexOf(' ');
                if (sp2 < 0) { tok[nt++] = r; break; }
                tok[nt++] = r.substring(0, sp2);
                r = r.substring(sp2 + 1); r.trim();
            }
        }

        if (cmd == "wpclear") {
            cfg.clearDrops();
            if (engine) engine->resetProgress();
            Serial.println(F("[CFG] waypoints cleared (RAM only - use wpsave)"));
            return;
        }
        if (cmd == "wpsave") {
            bool ok = cfg.save();
            Serial.println(ok ? F("[CFG] saved to /mission.json")
                              : F("[CFG] *** SAVE FAILED ***"));
            return;
        }
        if (cmd == "wpadd") {
            if (nt < 2) {
                Serial.println(F("usage: wpadd <lat> <lon> [radius_m] [alt_m]"));
                return;
            }
            double lat = tok[0].toDouble();
            double lon = tok[1].toDouble();
            // Default radius is release.default_radius_m (5m out of the box:
            // the smallest radius that still survives a fallback to the 1Hz
            // GNSS source at 5m/s — the chord must exceed one sample step).
            float  r   = (nt >= 3) ? tok[2].toFloat()
                                   : cfg.config().release.default_radius_m;
            float  alt = (nt >= 4) ? tok[3].toFloat() : 8.0f;
            if (lat < -90 || lat > 90 || lon < -180 || lon > 180) {
                Serial.println(F("lat/lon out of range"));
                return;
            }
            r = constrain(r, 0.5f, 100.0f);
            if (!cfg.addDrop(lat, lon, alt, r)) {
                Serial.printf("waypoint list full (max %d)\n", cfg.maxDrops());
                return;
            }
            if (engine) engine->resetProgress();
            return;                       // addDrop() already prints [CFG] +WPn
        }
        if (cmd == "wpradius") {
            if (nt < 2) {
                Serial.println(F("usage: wpradius <idx|all> <radius_m>"));
                return;
            }
            float r = constrain(tok[1].toFloat(), 0.5f, 100.0f);
            const MissionConfig& mc = cfg.config();
            if (tok[0] == "all") {
                for (uint8_t i = 0; i < mc.drop_count; i++) cfg.setDropRadius(i, r);
                Serial.printf("[CFG] radius=%.1fm on all %d waypoints\n",
                              r, mc.drop_count);
                return;
            }
            // 1-based to match what `wp` prints. idx 0 underflows to 255 and
            // is rejected by setDropRadius's bounds check rather than wrapping.
            int idx1 = tok[0].toInt();
            if (!cfg.setDropRadius((uint8_t)(idx1 - 1), r)) {
                Serial.println(F("bad index - `wp` lists them, 1-based"));
                return;
            }
            Serial.printf("[CFG] WP%d radius=%.1fm\n", idx1, r);
            return;
        }
    }
#endif
    Serial.printf("unknown '%s' - try 'help'\n", cmd.c_str());
}

// ─── Per-section loop timing ──────────────────────────────────────────
// worst-loop tells you THAT loop() stalled, never WHERE. Guessing where has
// already cost this project four rounds (the [DLE] print, the log fetch, the
// open/append/close, the telemetry flush). This attributes the stall to a
// section, so the next round is a measurement instead of a hypothesis.
enum LoopSect {
    SECT_HTTP = 0, SECT_SERIAL, SECT_POS, SECT_ACT, SECT_ENGINE,
    SECT_RC, SECT_CAL, SECT_SM, SECT_EVT, SECT_TLM, SECT_COUNT
};
static const char* SECT_NAME[SECT_COUNT] = {
    "http", "serialcmd", "possrc", "actpoll", "engine",
    "rc", "caltimed", "statemc", "events", "telemetry"
};
static uint32_t sect_worst[SECT_COUNT] = {0};
static uint32_t sect_mark = 0;

static inline void sectMark(uint8_t idx) {
    uint32_t now = micros();
    uint32_t dt  = now - sect_mark;
    if (dt > sect_worst[idx]) sect_worst[idx] = dt;
    sect_mark = now;
}

// ─── Setup — numbered checkpoints so a crash location is visible ──────
void setup() {
    // ── Why a 4KB TX buffer, and why the baud rate did NOT change ──────
    // The 60-200ms worst-loop spikes are not compute. At 115200, 8N1, one
    // byte costs 86.8us of TRANSMIT time, and Serial.printf() blocks once
    // the TX FIFO fills. A drop fires [ACT] + [DROP] + [EVT] + a telemetry
    // row together, which is several hundred to ~2000 bytes: 60ms at 690
    // bytes, 200ms at 2300. That arithmetic matches the observed range,
    // and no compute explanation comes within three orders of magnitude of
    // it (CRC32 over a 231-byte OSDK frame is ~5us; haversine is ~5us).
    //
    // The core's default TX buffer is 256 bytes, so a burst overruns it
    // almost immediately. At 4KB the whole burst is memcpy'd and printf()
    // returns; the UART drains it in the background while loop() keeps
    // running. The stall goes away without touching the wire speed.
    //
    // Raising the baud to 921600 would ALSO work — the OSDK link already
    // runs at that rate, so the hardware is not in question. It was
    // rejected because the ROM bootloader prints at 115200 regardless, so
    // `rst:0x8` boot-loop diagnostics would arrive as garbage — and
    // START_HERE.md sends a newcomer looking for exactly that string.
    // Debuggability for the person about to run the validation is worth
    // more than wire speed that buffering already bought us.
    //
    // MUST be called before begin() — the driver allocates there.
    size_t txbuf = Serial.setTxBufferSize(4096);
    Serial.begin(115200);
    delay(1000);   // matches the timing validated all session on this board
    Serial.println("\n=== Smart Launcher Mission Dashboard ===");
    // Returns 0 if the UART was already running, in which case the buffer was
    // NOT resized and the call silently did nothing (the core's log_e is
    // invisible at CORE_DEBUG_LEVEL 0). Report it rather than assume it took.
    Serial.printf("[PERF] TX buffer = %u bytes%s\n", (unsigned)txbuf,
                  txbuf ? "" : "  *** RESIZE FAILED — Serial already running ***");

    Serial.println("[1] Config (LittleFS + mission.json, self-seed if missing)");
    if (!cfg.begin(MISSION_DEFAULT_JSON)) {
        Serial.println("[MAIN] Config load FAILED");
        // Continue anyway — sm.begin() below still runs so the dashboard is
        // reachable and can show a FAULT state rather than bricking silently.
    }
    cfg.printSummary();

    Serial.println("[2] Logger");
    logger.begin();

    Serial.println("[3] State machine (LED GPIO22, ARM button GPIO0 best-effort)");
    sm.begin();

#if SIM_MODE
    Serial.println("[4] Position source (SIM — real OSDK/GNSS until /simpos injects)");
    simSource.setFallback(&realSource);
    posSource = &simSource;
#else
    Serial.println("[4] Position source (OSDK GPIO25 @921600, GNSS fallback)");
    posSource = &realSource;
#endif
    posSource->begin();

#if SIM_MODE
    Serial.println("[5] Actuators *** SIM MODE — announce LED GPIO14, "
                   "servo GPIO12/13 NOT attached ***");
#else
    Serial.println("[5] Actuators (servo GPIO12/13, limit GPIO32/33)");
#endif
    const MissionConfig& mc = cfg.config();
    modA = ActuatorModule(PIN_SERVO_A, PIN_LIMIT_A,
                          mc.module_a.servo_open_pwm_us, mc.module_a.servo_stop_pwm_us,
                          mc.module_a.travel_ms, mc.module_a.door_count, 'A');
    modB = ActuatorModule(PIN_SERVO_B, PIN_LIMIT_B,
                          mc.module_b.servo_open_pwm_us, mc.module_b.servo_stop_pwm_us,
                          mc.module_b.travel_ms, mc.module_b.door_count, 'B');
    modA.begin();
    modB.begin();

    Serial.println("[6] Drop logic engine");
    engine = new DropLogicEngine(cfg, *posSource, modA, modB, sm, logger);

    Serial.println("[6b] RC pilot trigger (GPIO35, input-only + external 10k pull-down)");
    rcIn.setBands(mc.rc_trigger.safe_max_us, mc.rc_trigger.fire_min_us,
                  mc.rc_trigger.frames_to_confirm, mc.rc_trigger.signal_timeout_ms);
    rcIn.setEnabled(mc.rc_trigger.enabled);
    rcIn.begin();

    Serial.println("[7] WiFi AP");
    WiFi.mode(WIFI_AP);
    delay(100);
    WiFi.softAP(SSID, "");
    delay(500);
    Serial.printf("[8] IP: %s\n", WiFi.softAPIP().toString().c_str());

    Serial.println("[9] HTTP server");
    server.on("/",         handleRoot);
    server.on("/cmd",      handleCmd);
    server.on("/timed",    handleTimed);
    server.on("/savecal",  handleSaveCal);
    server.on("/status",   handleStatus);
    server.on("/arm",      handleArm);
    server.on("/disarm",   handleDisarm);
    server.on("/dropa",    handleDropA);
    server.on("/dropb",    handleDropB);
    server.on("/resetdoors", handleResetDoors);
    server.on("/stop",     handleStop);
    server.on("/log",      handleLog);
    server.on("/clearlog", handleClearLog);
    server.on("/rccal",    handleRcCal);
    server.on("/mission",  handleMission);
    server.on("/release",  handleRelease);
    server.on("/hover",    handleHover);
#if SIM_MODE
    server.on("/simpos",   handleSimPos);
#endif
    server.begin();

    Serial.println("[10] BOOT -> IDLE");
    sm.completeBoot();

    Serial.println("[11] Ready — connect to SmartLauncher -> http://192.168.4.1");
    Serial.println("[12] setup() complete — loop starting");
}
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
