codreman2-eng/Smart-Mangrove/Servo_Web_Calibrator_WROVER/StateMachine.h

#pragma once
#include <Arduino.h>

enum class SystemState {
    BOOT,     // startup, self-check
    IDLE,     // running but drop logic disabled
    ARMED,    // drop logic active — ready to fire
    DROPPING, // currently executing a drop
    FAULT     // unrecoverable error — servos stopped
};

class StateMachine {
public:
    // led_pin      : the existing state LED (blink cadence per state)
    // wait_pin     : yellow WAIT LED — steady ON means "armed, waiting for
    //                a trigger". Present in flight builds too, not sim-only.
    StateMachine(uint8_t led_pin, uint8_t arm_btn_pin, uint8_t wait_pin);

    void begin();

    // Call every loop — handles button debounce and LED update
    void update();

    // External modules call these to request transitions
    void requestArm();
    void requestDisarm();

    // Emergency stop -> IDLE from ANY state (except FAULT).
    //
    // Defect (b), confirmed on hardware 2026-08-25: handleStop() called
    // requestDisarm(), which is guarded to ARMED — and during a drop the
    // state is DROPPING, so it silently did nothing. The system was observed
    // still reading state=DROPPING 68ms after an emergency stop, then
    // transitioning INTO ARMED when the (defect (a)) sequence finished.
    //
    // The fix is NOT to loosen requestDisarm()'s guard. That guard is correct
    // for the normal disarm path — you should not be able to casually disarm
    // mid-drop. An emergency stop gets its own explicit authority instead.
    void emergencyStop();
    void setDropping(bool active);
    void setFault(const char* reason);

    // One-time BOOT -> IDLE transition, called once at the end of setup().
    // Deliberately separate from requestDisarm(), which is guarded to only
    // fire from ARMED (its real job is the normal disarm path) and would
    // silently no-op if called from BOOT — which is exactly the bug this
    // method fixes (the system could never leave BOOT before this existed).
    void completeBoot();

    SystemState state() const { return _state; }
    bool isArmed()    const { return _state == SystemState::ARMED; }
    bool isDropping() const { return _state == SystemState::DROPPING; }
    bool isFault()    const { return _state == SystemState::FAULT; }

private:
    uint8_t     _led_pin;
    uint8_t     _btn_pin;
    uint8_t     _wait_pin;
    SystemState _state        = SystemState::BOOT;
    uint32_t    _btn_press_t  = 0;
    bool        _btn_held     = false;

    void _setState(SystemState s);

    // Plain 2-pin LED — states are distinguished by blink pattern, not
    // colour (no WS2812 on this board). Called every update().
    void _updateLED();

    // Yellow WAIT LED. Deliberately DARK during DROPPING so the announce
    // LED has the floor — the pair reads as a semaphore: yellow steady
    // (holding) -> yellow dark + announce lit (firing) -> yellow steady.
    void _updateWaitLED();

    // Long press threshold for ARM/DISARM
    static const uint32_t ARM_HOLD_MS = 2000;
};
