codreman2-eng/Smart-Mangrove/(commit log)

2026-07-10 Add WROVER-E web calibrator with fixed GPIO conflicts, direction, and stop tracking
    Servo_Web_Calibrator_WROVER.ino: rebuilt web-UI calibrator after diagnosing
    two boot-loop bugs on real hardware (GPIO 2 strapping-pin LED, and GPIO 9/10
    being permanently reserved for flash+PSRAM on WROVER modules regardless of
    flash mode -- moved limit switches to GPIO 32/33). Confirmed clean boot via
    live serial bisection.
    After first hands-on test: fixed OPEN/CLOSE direction default (was backwards
    on real hardware) and fixed TIMED RUN never stopping (auto-stop paths were
    hardcoding 1500us as "stopped" instead of each module's real calibrated
    stop, e.g. Module A's measured 1650us).
    Also add Servo_Calibrat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
2026-07-11 Add Phase 3 Mission Dashboard, fix servo-runaway incident and silent UI failures
    Root-caused a real safety incident: a stop value (1650us) measured via the
    calibrator did not stop the servo when run through the PlatformIO firmware
    (older bundled Arduino-ESP32 core, forced onto the classic ledcSetup/
    ledcAttachPin LEDC API) -- it kept slowly rotating even after a fresh
    reboot re-wrote the same stop command, and had to be physically power-cut.
    Re-measured via the calibrator afterward: true stop was 1670us, not 1650.
    The two toolchains' differing underlying LEDC drivers is the likely cause.
    Decision: build the Phase 3 web dashboard (originally roadmapped as "Wi-Fi
    config upload") by extending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
2026-08-12 Add DESIGN_RATIONALE.md and cross-reference it from the handoff
    Records why the launcher runs on its own MCU rather than on the Cube
    Orange+: fault isolation, host-platform independence, bench testing
    without arming an aircraft, and field calibration over Wi-Fi.
    The handoff now points at it from both the architecture intro and the
    flight-controller section, with the operative rule stated inline: the
    launcher may CONSUME data from the Cube, but must never COMMAND through
    it and must never run code on it.
2026-08-12 Add SIM mode (LED dry-run) and the pilot RC trigger from the M600
    Two features that share the dashboard .ino, so they land together.
    === SIM MODE ===
    Everything still unverified on the Phase 3 dashboard is timing, state and
    HTTP behaviour - the servo is only the output stage. SIM_MODE swaps that
    stage for an LED on GPIO 14, so the whole chain can be validated with no
    one-way rack retraction, no risk of repeating the servo-runaway incident,
    and no dependency on Module B hardware existing.
    The sim branch lives in ActuatorModule::_writePWM() and nowhere else.
    Drop timing, door counting, limit switches, DropLogicEngine, StateMachine
    and every HTTP handler run byte-identically to the flight bu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
2026-08-12 Update handoff for SIM mode and the RC pilot trigger
    The handoff is the paste-into-a-new-chat resume doc, and its CURRENT STATE
    and IMMEDIATE NEXT GOAL sections still described the pre-dashboard world.
    - Pin table corrected: limit switches on 32/33 (they were still listed on
    9/10, which that same document elsewhere records as permanently broken on
    WROVER), plus the new LEDs on 14/27 and the RC input on 35.
    - New PHASE 3b/3c sections covering SIM mode and the RC trigger, each
    stating plainly that the code is compile-verified but has NEVER run on
    hardware, and listing the four candidate defects with the three that are
    deliberately left in for the test run to confirm.
    - Lessons 9-12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
2026-08-12 RC tool: do not report SAFE before any frame has been received
    Caught on the first live run after flashing to hardware. last_ok_ms is
    seeded in setup(), so for the first 500ms after boot the freshness check
    passed with width_us still 0 - which classifies as SAFE and printed a
    reassuring "0 us [SAFE]" readout when nothing had ever been received.
    Wrong impression in the wrong direction for a tool whose job is to tell
    you whether the pilot trigger signal is actually arriving. Now requires
    frames > 0 before the readout is considered live.
    Production RcPwmInput does not share this bug - its _has_signal starts
    false and only becomes true once a band is confirmed, so band() correctly
    reports NONE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
2026-08-12 Add Mega 2560 pulse generator; fix glitch counting in both RC readers
    === Mega 2560 generator ===
    RC_Pulse_Generator_Mega2560.ino generates known-good RC PWM so the pilot
    trigger reader can be validated before anything touches the A3 F-channel,
    including the failure modes that cannot safely be provoked on an aircraft.
    Timer1 hardware PWM rather than digitalWrite() or the Servo library:
    a crystal-referenced timer is jitter-free, which matters when the sketch
    IS the reference. It also sidesteps the Servo library clamping
    writeMicroseconds() to 544-2400us, which would have made the out-of-range
    tests impossible - this emits 300us or 2800us on request. Prescaler is
    picked from the requested pe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
2026-08-12 Add JSONL flight logger; announce LED now active in flight builds too
    === JSONL flight logger ===
    The old logger wrote CSV drop events only - nothing about RC channel
    behaviour, GPS quality over time, or state transitions. A test flight that
    produces no record is a wasted flight, and you get one per battery.
    Now writes /logs/flight.jsonl, one JSON object per line:
    - 1 Hz telemetry rows: state, armed, lat/lon/sats/hdop, RC width + band +
    Hz + glitch count, doors A/B, drop index, both limit switches
    - Event rows on change: boot, state transitions, rc_acquired, rc_lost,
    rc_band, rc_fire (including REFUSALS with the reason), drop, estop
    JSON Lines rather than one JSON array, delib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
2026-08-12 Add OSDK API-port sniffer; correct GPIO 16/17 in the handoff
    === Handoff pin correction ===
    Phase 4 specified ESP32 GPIO 16/17 for the Cube's TELEM2 UART. Those pins
    are wired to the PSRAM chip on WROVER modules and are not available as
    general I/O - the same class of fault as the GPIO 9/10 bug that already
    cost a debugging session. Corrected to GPIO 25/26, with the reason recorded
    inline so it does not get "fixed" back.
    === tools/osdk_sniff.py ===
    Listen-only analyser for the A3 Pro Onboard SDK UART, run from a PC through
    a 3.3V USB-TTL adapter. Modes: live sniff with raw capture, offline replay
    of a capture, baud sweep, raw hexdump.
    PC rather than a microcontroller, deliberately. The M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
2026-08-12 OSDK: correct the CRC constants, recovered from a live A3 capture
    First run against the real aircraft on COM11 (FT232R) at 921600: 601 frames
    in 12.2s, 49.2 frames/sec, zero resyncs across 139KB - a healthy broadcast
    link. Frame-length distribution independently corroborates the parse:
    231B/80%, 235B/18%, 250B/2% matches the Assistant 2 rate config exactly
    (50Hz fields always, Flight Status @10Hz = every 5th frame, Battery and
    Control Info @1Hz = every 50th).
    But header CRC scored 0/601, so the constants were recovered from the
    capture itself: the CRC16 seed brute-forced over the 16-bit space per
    candidate polynomial, the CRC32 seed solved algebraically (CRC is linear
    over GF(2), so init is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
2026-08-12 OSDK: add broadcast payload decoder and --diff field locator
    === Decoder ===
    Payload format confirmed from the live capture:
    cmd_set(1) | cmd_id(1) | passFlag(uint16) | enabled fields in bit order
    The passFlag semantics are proven, not assumed: the bits matched the DJI
    Assistant 2 rate configuration exactly (RTK and MAG clear because both were
    set to "Do Not Send"), and the three frame sizes correspond to 0x067F/231B,
    0x0E7F/235B (+STATUS) and 0x3E7F/250B (+BATTERY,+DEVICE).
    Field offsets were derived empirically rather than read from SDK headers,
    and two independent anchors confirm them:
    * POSITION at offset 72 lands on a 16-byte run of zeros (lat/lon as
    float64 0.0 - no GPS fix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
2026-08-12 Add OsdkPositionSource: 50Hz fused position from the M600 A3 broadcast
    Read-only by construction. The A3 broadcasts unprompted - proven on real
    hardware with the adapter's TX physically disconnected - so this never
    transmits, never activates, and never requests control authority. That
    keeps it inside the project rule (consume host data, never command through
    the host) and keeps DJI's SDK Return-Home failsafe out of reach, since that
    is tied to holding control authority.
    DropLogicEngine is untouched. It reads IPositionSource and does a Haversine
    radius check; it neither knows nor cares where the position came from. The
    abstraction was built for this.
    WHY THIS MATTERS: 50Hz fused position ag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
2026-08-12 Add Waypoints tab: plan a mission from the aircraft's own position
    There was no way to plan a mission at all. Waypoints lived in mission.json,
    seeded from MissionDefault.h ONLY when the file was absent - so editing the
    header and reflashing changed nothing on a board that already had one, and
    there was no upload route or editor. The shipped waypoints are placeholders
    in Panama, which makes the walk test impossible.
    Third tab, built around one control: ADD WAYPOINT HERE captures the current
    OSDK/GNSS position on a single tap. No coordinates typed, no laptop, no
    import format - the only workflow that works in a field. It refuses when
    there is no fix rather than storing 0,0, which would be a w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
2026-08-13 Flight log: events-only filter and auto-scroll, so drops are visible
    Reported after a successful stage-1 walk test: the LED fired but no drop
    appeared in the datalog. The rows are almost certainly there - the viewer
    made them impossible to find.
    Telemetry writes one row per second; a drop writes two rows total. The
    dashboard log box is 180px tall, renders the file from the TOP, and never
    scrolls. A few minutes of running buries the two drop lines under hundreds
    of tlm rows, off-screen below.
    * /log?ev=1 filters out "ev":"tlm" rows SERVER-side. Filtering on the
    device matters over a WiFi AP - shipping the whole file to the browser
    just to discard most of it is wasteful, and the fi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
2026-08-13 Fix: SimPositionSource::begin() never started the fallback source
    Reported as "no fix" outdoors. Not a wiring problem - UART2 was never
    initialised, so the OSDK link had never received a single byte, and the M8N
    was never started either. Both position sources were dead in every SIM
    build since the fallback was added.
    update(), read() and hasFix() all delegate to the fallback. begin() did not.
    The boot log still looked healthy; the only symptom was the ABSENCE of the
    [OSDK] and [GNSS] init lines at checkpoint [4], which is easy to miss when
    nothing is obviously wrong.
    Also adds a 5-second OSDK health line to serial: frames, CRC errors,
    resyncs, passFlag, raw lat/lon, health byte, and whethe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
2026-08-13 Fix drop latency: the flight log was stalling loop()
    Reported as "a lot of lag to deploy" after a successful walk test. The
    cause was the logger, three ways, all of them mine.
    The log file had reached 752KB - not the 80KB I had assumed - because 1Hz
    telemetry ran during hours of idle bench time.
    1. THE LOG FETCH. The events-only filter added yesterday read the ENTIRE
    file one byte at a time, every 5 seconds, inside an HTTP handler. At
    752KB that is seconds of stall, and it grew with every session. While
    loop() is blocked, position is not read and the drop radius is not
    evaluated, so this landed directly on drop timing.
    Now: seek to the last ~25KB, block reads, output accumul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
2026-08-14 Add START_HERE.md: onboarding guide for a newcomer
    The project is being handed to another student for a week. Every existing
    document assumes prior context: PROJECT_HANDOFF.md is written for someone
    already up to speed, and SIM_MODE_VALIDATION_PLAN.md assumes you know what
    SIM mode is and why it exists.
    START_HERE.md assumes none of it. Safety first (the cover moves one way and
    does not go back; the ESP32 is not 5V tolerant; props off, always), then
    what the project is in plain language, the hardware, the pins that must
    never be used and why, setting up the Arduino IDE, finding a COM port that
    moves between sessions, flashing, reading the boot output, using the
    dashboard, and a troubleshoot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
2026-08-14 Serial commands, drop-latency fix, and the Spanish handover guide (PDF)
    === The real cause of the drop lag ===
    DropLogicEngine printed "[DLE] WP1 dist=..." on EVERY loop iteration while
    armed. ~30 characters at 115200 baud is ~2.6ms of blocking, thousands of
    times per second, and Serial.printf() stalls once the TX buffer fills. The
    distance readout was itself the largest source of drop latency - and it
    only ran while ARMED, which is exactly when the lag was reported.
    Now rate-limited to 1Hz, or whenever the distance moves more than a metre
    so an approach stays visible in real time.
    NOT fully resolved: worst-loop still shows 60-200ms spikes clustered around
    the drop, when [ACT]/[DROP]/[EVT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
2026-08-25 Fix the drop-latency spikes at the source: serial blocking, not CPU speed
    The 60-200ms worst-loop spikes raised the question of whether the ESP32 is
    too slow and the project should move to a Raspberry Pi Zero 2 W. It is not,
    and this commit fixes the actual cause.
    === The evidence ===
    The Phase 3d field capture already settled it: frames=368 crcErr=2 resync=1,
    with CRC and resync counts FLAT between reports. A board that could not keep
    up with its input shows those climbing continuously - that is what buffer
    overrun looks like. The ESP32 decodes 100% of the A3 stream in steady state.
    Per-frame compute at 240MHz against 50Hz: CRC16+CRC32 over 231 bytes is
    ~5-50us, haversine is ~5us on the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
2026-08-25 Bench run: drive window measures +0ms; residual stall is lfs_file_sync()
    Flashed to COM10 and ran the drop test over the serial command interface.
    SIM build, servos disconnected, LEDs only.
    === The headline ===
    [ACT] Door 1 - timed drop OK (580 ms target, 580 ms actual, +0 ms)
    [ACT] Door 1 - timed drop OK (350 ms target, 350 ms actual, +0 ms)
    Three consecutive runs, both modules, +0ms every time, against a +/-58ms
    budget. The plan's step 4 criterion passes with the whole tolerance to spare.
    [PERF] TX buffer = 4096 bytes - the resize is confirmed live. That line was
    added on purpose: setTxBufferSize() returns 0 and silently does nothing if
    the UART is already running, and the core's l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
2026-08-26 Fix defects (a), (b) and (e); unify the two emergency-stop paths
    Confirmed on hardware this session, fixed as ONE change, re-verified with the
    same script and the same timing that caught them.
    === The fix ===
    DropLogicEngine::abort() - tears down the in-flight sequence and resets
    _phase to IDLE. Deliberately does NOT advance _next_drop_idx: an aborted
    waypoint was not serviced and must still be pending when the operator
    re-arms. Records the interrupted door truthfully before resetting.
    StateMachine::emergencyStop() - IDLE from any state except FAULT.
    requestDisarm()'s ARMED guard was NOT loosened. That guard is correct for the
    normal disarm path - you should not be able to casually disarm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
2026-08-26 Fix defect (c): honour startDrop()'s return on the GPS trigger path
    _modA.startDrop()'s false return was ignored, and _phase was set to WAITING_A
    regardless. With no drop actually started, the WAITING_A branch fired on the
    next tick, recorded a drop using whatever _lastResult happened to hold,
    started module B, and logged a full SUCCESS with zero motion. The shipped
    default mission is exactly that case: 10 waypoints, 5 doors.
    startManualPair() has ALWAYS guarded this correctly - it checks isEmpty() and
    refuses. The GPS path simply never got the same check. Two trigger paths that
    disagreed, which is the same shape of bug as the two e-stop paths found an
    hour earlier. That is now twice in one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
2026-08-26 Add the serial bench harness; record Phase 4 waypoint/ballistics research
    Two things that would otherwise have been lost when this session ended.
    === tools/bench_serial.py ===
    The harness that drove yesterday's testing lived in a session-scoped scratch
    directory. It found defects (a), (b) and (e), and then caught the first fix
    landing on only one of the two e-stop code paths, so it belongs in the repo.
    boot / listen / cmd / drop / estop modes. The estop mode is the point: it
    schedules the emergency stop INSIDE module A's 580ms drive window with the
    engine in WAITING_A. A human typing into a serial monitor cannot reliably hit
    that, and an ambiguous miss is indistinguishable from "the defec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
2026-09-01 Close defect (c); add SIM-gated waypoint commands; find a servo hazard
    Defect (c) is the last of the four planted defects. It needed a mission with
    more waypoints than doors, and the device had one waypoint saved.
    RESULT: none of (c)'s symptoms occur. 10 waypoints against 5 doors, WP1-WP4
    fire at +0ms, the run ends at WP5 with MISSION COMPLETE, and WP6 produces no
    [DLE] output at all - no evaluation, no phantom SUCCESS row, no spurious
    module B start, five waypoints correctly left pending.
    But the inner guard was never executed and cannot be. missionComplete() is
    checked at DropLogicEngine.cpp:73 before any waypoint evaluation, and
    launcherEmpty() is `A.isEmpty() || B.isEmpty()` - so the i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
2026-09-01 Phase 4a: predict the impact point instead of the release point
    A propagule keeps the aircraft's horizontal velocity while it falls, so
    releasing AT the waypoint lands every seed downrange - 6.4m at 5 m/s from 8m,
    twice the target radius. Chasing 10cm of GPS sampling accuracy while ignoring
    that was straining a gnat.
    DropLogicEngine now tests the PREDICTED IMPACT POINT against the waypoint
    rather than the aircraft position. It is a substitution at the haversine call,
    not a rewrite; everything downstream is untouched.
    Inputs were already on the wire and simply not read:
    - OsdkPositionSource kept `height` (height above takeoff), which had been
    memcpy'd and discarded since Phase 3d - one st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
2026-09-09 Write the T_EXIT_S bench procedure and its reduction tool
    T_EXIT_S is the last ballistics constant still at 0.0 - the seconds between
    the drop command and the propagule actually leaving the module. leadTime()
    adds it to the fall time, so it is carry the aircraft's velocity applies to
    the seed before it is even in the air: up to 2.9m of along-track spread at
    5 m/s. It was left at 0 deliberately in Phase 4a rather than guessed. This
    commit makes measuring it a procedure instead of an intention. It does NOT
    measure it - zero trials have been taken.
    THE FRAME RATE NEVER ENTERS THE ANSWER. The announce LED (GPIO 14) is lit
    for exactly the servo drive window - ActuatorModule::_writePWM sets it fr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
2026-09-14 Correct the wiring guide against Pins.h
    SMART_LAUNCHER_COMPLETE_GUIDE.md was still written for an ESP32-S3 WROOM and
    documented pins that crash this board. Anyone wiring from section 4 would have
    put the limit switches on GPIO 9/10 — the WROVER flash+PSRAM SPI bus, where
    pinMode(9, INPUT_PULLUP) crashes instantly — and the status LED on GPIO 2,
    which boot-loops. Pins.h is the authority; the guide now says so and matches it.
    Section 4:
    - 4.1 pin table rebuilt from Pins.h: servos 12/13 (was 18/8), limits 32/33
    (was 9/10), status LED 22 (was 2), wait LED 27, announce LED 14, RC in 35,
    OSDK 25/26, GNSS 4/5. Added a forbidden-pins table for 2, 9/10 and 16/17
    with the reason and how eac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
2026-09-24 Rewrite the build section of the guide for the Arduino IDE toolchain
    Section 7 still documented a PlatformIO workflow and an ESP32-S3 board
    profile. The live firmware is the Servo_Web_Calibrator_WROVER sketch, built
    with the Arduino IDE / arduino-cli as "ESP32 Wrover Module".
    - Board and settings for the WROVER; warn that Dev Module and S3 are wrong.
    - Turn compiler warnings on so the flight-build #warning is visible.
    - Upload steps: check SIM_MODE first, the CH340 port moves, one program per port.
    - No uploadfs step: mission.json self-seeds from MissionDefault.h.
    - Headless arduino-cli build recipe.
    - PlatformIO tree marked historical; its 16/17 MAVLink pins are the PSRAM trap.
    - Zero-coup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
2026-09-24 Add a single-trial driver for the T_EXIT_S bench measurement
    Fires one filmed drop over the SmartLauncher AP, refuses when the next door
    would be the last one (the unwired-switch overdrive hazard), retries through
    the loop() stalls that refuse HTTP handshakes, and transcribes drive_ms from
    the [ACT] line into a CSV row stub. --dry checks preconditions without firing.
2026-09-30 Gate the release on slow-down, show the approach, switch to the flight build
    Release gate: being inside the waypoint radius is no longer enough. The
    drop fires only once horizontal speed is at or below 2.0 m/s
    (MAX_RELEASE_SPEED_MPS); faster than that it holds and logs "holding for
    slow-down" at 1Hz. The gate needs velocity, so it is enforced on OSDK data
    only; on the GNSS fallback it stays open (the old radius-only behaviour).
    Dashboard: new APPROACH card on Mission Control and an approach= line in
    the serial status - FAR / APPROACHING (within max(20m, 4r)) / SLOW DOWN /
    IN RADIUS / DROPPING, with distance, radius, speed vs limit, and whether
    the aim is the predicted impact or the aircraft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
2026-10-14 Default to the SIM build again and bring the docs up to date
    Pins.h goes back to SIM_MODE 1 so a fresh clone flashes the safe build.
    The 2026-09-30 flight flash was built from 22d753a with SIM_MODE 0; the
    bench board still carries it until it is reflashed, and the docs say so.
    README, START_HERE, PROJECT_HANDOFF and the Spanish guide (HTML + PDF) no
    longer describe the planted defects as open: all four are closed. They now
    cover the slow-down gate, the APPROACH card, LIMIT_SWITCHES_WIRED, the
    2026-09-30 servo bench findings (new PHASE 4b) and the current next steps
    (T_EXIT_S, limit switches, OSDK_VZ_IS_UP, first real prediction). The
    flight-build #warning is rewritten to match.
    SIM build c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
2026-10-14 Log the OSDK mission pushes instead of discarding them
    DJI's Open Protocol defines two unsolicited pushes on the same API UART as
    the position broadcast: 0x02/0x03 (ground station state: mission type,
    target waypoint, status, error) and 0x02/0x04 (waypoint event: incident,
    waypoint index, status). Layouts from OSDK 3.9 dji_ack.hpp. Whether the A3
    sends them for a GS Pro mission to a never-activated device is unknown;
    until now _decode() threw away every non-broadcast frame, so nobody could
    have seen them.
    OsdkPositionSource now routes every non-broadcast frame to a listener:
    - 0x02/0x03 is queued when its bytes change (it may repeat at a steady
    rate and the flight log is capped); every fr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
2026-10-15 Make the release gate configurable from the dashboard; audit the wiring
    The release used to fire on the first sample with the predicted impact
    point in radius and horizontal speed <= a compile-time 2.0 m/s. Max speed,
    a dwell time and a default radius are now mission.json settings ("release"
    block) edited from the Waypoints tab. An absent block gives 2.0 m/s, 0 s
    and 5 m, which is the 2026-09-30 behaviour, so an existing mission.json
    keeps firing exactly as before.
    Release gate (DropLogicEngine):
    - MAX_RELEASE_SPEED_MPS is gone; the engine reads release.max_speed_mps.
    - Dwell: in radius AND not too fast must hold, ARMED, for release.dwell_s.
    Any exit, a disarm, an abort or firing restarts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
2026-10-15 Add the M600 waypoint-status research report and its notes
    reports/Estado de waypoints en el M600.md (Spanish) asks whether the M600
    can tell the launcher a GS Pro waypoint was reached without the launcher
    transmitting. Main finding: the A3 may already send 0x02/0x03 and
    0x02/0x04 mission pushes on the API UART the ESP32 listens to; one DJI
    Assistant 2 simulator session settles it. Fallback: GS Pro's "PWM to
    F-channel" waypoint action on GPIO 35. DUML/CAN sniffing ruled out; an
    MSDK app only helps if it replaces GS Pro.
    research_notes/ holds the four source notes behind it (OSDK mission and
    authority, indirect channels via waypoint actions, MSDK app, DUML/CAN).
    OsdkPositionSource.h and the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
2026-10-30 Add hover release mode and switch the committed build to flight
    Hover mode drops on what the aircraft is doing instead of where it is, for
    flights that go beyond Wi-Fi range with no coordinates set. While armed it
    fires module A once all of these hold together for hold_s: airborne for
    min_flight_min (takeoff = height above takeoff_height_m), height >= min,
    >= min_home_dist_m from the takeoff point, OSDK speed <= max, the speed
    derived from position agreeing within 1 m/s, and >= rearm_dist_m from the
    last hover drop. Below takeoff height for 10 s counts as landed and resets
    the clock and home point. Module B fires only if use_b is set.
    Every value lives under "hover" in mission.json and is t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
2026-10-30 Block hover drops during climbs, descents and high stops
    Hover mode only checked horizontal speed, so an aircraft climbing or
    descending in place read as hovering. A GS Pro "Return to Home" finish
    action, a signal-loss RTH or a landing away from the takeoff point could
    each hold still long enough to fire. Two conditions close that:
    |vertical speed| <= max_vspeed_mps (1.0) abs() so the unverified OSDK
    vz sign does not matter
    height <= max_height_m (15) no drop from transit or RTH
    altitude
    New defaults, tuned for the 5-waypoint GS Pro test with 15 s hover
    actions at 8 m: 0.25 min flight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
2026-10-30 Tell a dead DJI link from a missing GPS fix on the hover card
    The hover card said NO DATA both when no frame was arriving from the A3
    and when frames arrived at full rate without a GPS fix (indoors), so a
    working link read as a broken one. The board now reports osdkLink (a
    CRC-good frame within the last second, fix or not) and osdkHealth (A3 GPS
    health 0-5), and the card names the case under the badge:
    NO DJI LINK no frames: check GPIO 25, ground, drone power
    LINK OK - MISSING DATA broadcast lacks POSITION or VELOCITY
    LINK OK - WAITING GPS frames arriving, health below 3 (normal indoors)
    link OK line in green everything present; badge shows the hover state
    with the liv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
2026-10-30 Add a door-count reset so an emptied launcher can fly again
    After the fifth drop missionComplete() is true for good, and loop()
    disarms on it: every ARM after a field reload was undone within one loop
    (the 2026-10-30 ground test log shows six ARM -> IDLE pairs ~150 ms
    apart). Only a reboot cleared the counters.
    RESET DOOR COUNT on the Control tab (two taps, "rack reloaded?"), the
    /resetdoors?confirm=1 route and serial `resetdoors` all go through one
    helper. It zeroes both modules, rewinds mission progress, and clears the
    hover drop count and last-drop point; it is refused while armed, dropping
    or mid-sequence, and logs doors_reset with the counts it replaced. The
    takeoff point and flight cl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
2026-10-31 Fix the field-test findings: landing after an empty rack, manual drop logs
    The 2026-10-31 field test log showed four problems; all fixed here and
    host-tested against the real engine (tools/host_sim, new test_fixes).
    - Flight tracking ran after the missionComplete() return, so once the
    rack was empty "landed" froze until RESET DOOR COUNT. A quick takeoff
    after the reset could inherit the old flight clock, home and last-drop
    point. Tracking now runs first; test_fixes [2] fails 4 checks on the
    old order.
    - Dashboard DROP A/B left no log row. They now write manual_drop
    (module, door, OSDK height and speed at the press, result) and a drop
    row with id 0, after the drive window.
    - New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
2026-10-31 Record the first field test (PHASE 4d/4e) and keep its flight log
    PHASE 4d (hover release, field plan) was written on 2026-10-30 and never
    committed. PHASE 4e covers the 2026-10-31 test: 8 hover drops at stops,
    5 of 6 eligible waypoints, the A3's mission pushes seen for the first
    time, the owner's account of the day, and the fixes flashed that day.
    flight_logs/2026-10-31_field_test/ holds the full log, the board config
    at the end of the day, and timeline.py to rebuild the per-flight view.
